ahmedjk34/hardware-grad-project/report_src/figs/fig-raw-fisheye.png

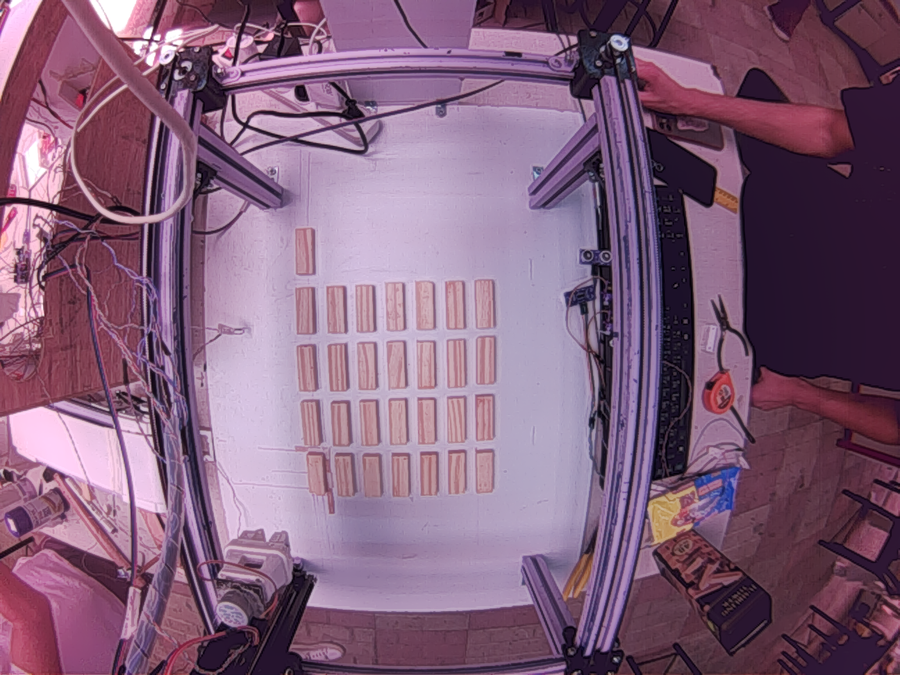
report_src/figs/fig-raw-fisheye.png
