ahmedjk34/hardware-grad-project/report_src/figs/fig-feed-detected.png

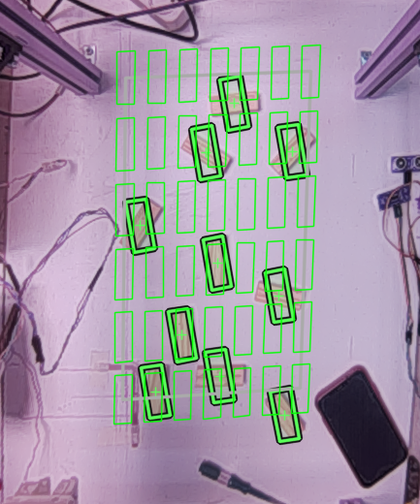
report_src/figs/fig-feed-detected.png
