ahmedjk34/hardware-grad-project/WANTED_REPORT_STRUCTURE.md

# Graduation Project Report Structure

## Front Matter

- Title Page
- Acknowledgments
- Abstract
- Table of Contents
- List of Figures
- List of Tables

# 1. Introduction

## 1.1 Background and Motivation

- General background of the project area.
- Context behind the project.
- Motivation for developing the system.

## 1.2 Problem Statement

- The problem being addressed.
- Why the problem requires a solution.

## 1.3 Project Objectives

- Main goal of the project.
- Specific objectives the completed system is intended to achieve.

## 1.4 Scope and Boundaries

- What is included within the project.
- What is outside the project's scope.
- Boundaries of the implemented system.

## 1.5 Significance of the Project

- Importance and potential value of the project.
- What the project contributes or demonstrates.

## 1.6 Organization of the Report

- Brief description of what each following chapter covers.

# 2. System Requirements and Design

## 2.1 System Requirements

- Functional requirements.
- Performance requirements where applicable.
- Safety or operational requirements.

## 2.2 Design Constraints

- Physical constraints.
- Hardware/electrical constraints.
- Technical and project constraints.

## 2.3 Overall System Architecture

- High-level system architecture.
- Main subsystems.
- How the subsystems connect and interact.

## 2.4 Mechanical Design

- Overall mechanical structure.
- Main mechanical mechanisms.
- Design choices relevant to movement and physical operation.

## 2.5 Electrical and Control Design

- Overall electrical design.
- Control architecture.
- Connections between controllers, actuators, sensors, and other hardware.

## 2.6 System Workflow

- Overall sequence of operation.
- How the system moves from an initial command/input to the final physical operation.

# 3. Hardware and System Implementation

## 3.1 Cartesian Motion System

- Physical motion mechanisms.
- Motors and motor drivers.
- Axis control hardware.
- Homing and movement-related hardware.

## 3.2 End-Effector and Manipulation System

- End-effector design.
- Gripping/manipulation mechanisms.
- Actuators involved in manipulation.

## 3.3 Processing and Control Hardware

- Main processing units and microcontrollers.
- Purpose of each controller.
- Division of responsibilities between them.

## 3.4 Vision System

- Vision hardware.
- Physical setup and mounting.
- Calibration and positioning approach.

## 3.5 Sensors and Feedback

- Sensors used in the system.
- Purpose of each sensor.
- Signal acquisition and feedback.

## 3.6 Power and Safety

- Power sources and voltage requirements.
- Power distribution.
- Electrical protection.
- Safety mechanisms.

## 3.7 System Integration

- How the individual hardware subsystems are connected.
- Final integrated hardware configuration.

# 4. Control and System Operation

## 4.1 Control Methodology

- Overall control approach.
- Relationship between high-level and low-level control.

## 4.2 Motion Control

- Movement commands and execution.
- Homing and positioning.
- Relevant control logic.

## 4.3 Vision and Positioning

- Image processing workflow.
- Detection/localization process.
- Conversion between vision information and physical coordinates.

## 4.4 Main System Operation

- Main automatic operating sequence.
- How individual subsystems cooperate during operation.

## 4.5 Additional Operating Modes

- Any manual, interactive, testing, or alternative operating modes implemented.

# 5. Testing, Results and Discussion

## 5.1 Testing Methodology

- How the system and its subsystems were tested.
- Test conditions and evaluation criteria.

## 5.2 Motion System Testing

- Movement and positioning tests.
- Homing and repeatability where applicable.

## 5.3 Manipulation Testing

- End-effector tests.
- Physical manipulation performance.

## 5.4 Vision System Testing

- Detection and positioning tests.
- Calibration results.
- Accuracy where measurable.

## 5.5 Sensor Testing

- Sensor calibration.
- Sensor performance and stability.

## 5.6 Integrated System Testing

- Testing of the complete system.
- End-to-end operation.
- Overall results.

## 5.7 Challenges and Limitations

- Major problems encountered.
- Solutions or design changes made.
- Remaining limitations of the final system.

# 6. Conclusion and Future Work

## 6.1 Conclusion

- Summary of the completed project.
- Main outcomes.
- Degree to which the project objectives were achieved.

## 6.2 Future Work

- Possible improvements.
- Features or capabilities that could be added.
- Areas that could be improved in future versions.

# References

- Academic papers.
- Technical documentation.
- Datasheets.
- Other sources referenced throughout the report.

# Appendices

- Detailed wiring diagrams.
- Pin mappings.
- Bill of materials.
- Relevant code or pseudocode.
- Detailed experimental data.
- Additional mechanical drawings or diagrams.
