ahmedjk34/hardware-grad-project/WRITING_STYLE.md

# Deep Writing-Style Analysis of Your CircuitAI Graduation Report

I treated this as a **style-reconstruction task, not a project summary**, and analyzed the report as a writing corpus, as you requested. I read the complete uploaded PDF from page 1 through page 126, including the long implementation/results sections rather than judging your style only from the polished opening pages.

There is one important document-level finding before the analysis: **the uploaded report does not actually contain standalone sections titled “Problem Statement,” “Conclusion,” or “Future Work.”** The problem is expressed across **General Background** and **Problem Scope and Boundaries**. The report says in its organization section that “Chapter 5 discusses limitations, trade-offs, and future improvements,” but the uploaded PDF instead ends during the Authentication & User Management limitations, without a separate Chapter 5 conclusion/future-work chapter. I will therefore **not invent original examples that are not in the document**. For conclusion/future-work style, I can only derive a lower-confidence pattern from your abstract endings, high-level summaries, discussion sections, trade-offs, and limitations.

---

# 1. The Core Fingerprint of Your Writing

If I had to recognize your report anonymously, the strongest fingerprint would be this:

> **Practical engineering writing with academic framing, direct vocabulary, moderately long explanatory sentences, strong system-oriented structure, concrete implementation detail, frequent lists/workflows, and occasional conversational or imperfect phrasing that prevents the prose from sounding like polished journal-paper English.**

Your writing is **not primarily “research-paper academic.”** It is closer to:

**student-engineer academic report + technical system documentation + practical design explanation.**

That distinction matters enormously.

You do not normally write like:

> “The proposed methodological paradigm facilitates the systematic orchestration of heterogeneous computational subsystems…”

You write more like:

> “The system follows a modular, layered architectural approach to ensure maintainability, scalability, and clear boundaries throughout the entire design.”

And when explaining an actual feature, you become even more concrete:

> “Student opens /student/dashboard. System calls get_student_dashboard_overview with the student ID.”

That movement from **formal explanation → concrete mechanism → exact implementation** is one of the strongest recurring characteristics of the report. The methodology introduces the architecture at a high level and then immediately decomposes it into functional layers and technologies.

A second major fingerprint is that you strongly prefer **clarity and completeness over sophisticated academic wording**. You regularly use familiar words such as _provide, support, enable, manage, handle, reduce, clear, practical, unified, reliable,_ and _interactive_. You rarely reach for ornate scholarly connectors.

A third fingerprint is **functional thinking**. You describe things according to:

**what it is → what it does → what goes into it → what comes out → how it operates → what constrains it.**

That becomes almost an explicit template in the Results and Discussion chapter, where features repeatedly use **What it does / Inputs / Outputs / Typical workflow / Validation & constraints**.

That pattern will be extremely useful when writing the hardware report.

---

# 2. Full Original Style Reference

## Original example from my report — Abstract

> Engineering students have been facing significant challenges bridging theoretical circuit knowledge with its practical implementation. While current general purpose AI systems exist, they have showcased inadequate accuracy in addressing hardware design questions, frequently providing incorrect instructions, flawed circuit analysis, and misleading debugging guidance, leaving students with no reliable assistance once outside of the classroom.
>
> This is where our project comes in: an interactive cross-platform hardware learning application that integrates three foundational components into a single system. The platform includes a Moodle-like learning management layer responsible for course structuring, enrollment, assignments, quizzes, grading, and progress tracking. It also provides interactive circuit simulation, featuring a real-time, client-side digital logic simulator for immediate feedback and conceptual validation, alongside a SPICE-based electrical circuit simulator capable of DC operating point analysis, DC sweep, AC frequency analysis, and transient time-domain simulation. Last but not least, a domain-specific AI engine, enhanced through Retrieval-Augmented Generation (RAG) and grounded in An-Najah University course materials and circuit design principles, which ensures that it delivers accurate, context-specific tutoring, and then we applied the same advanced AI capabilities to quiz generation and AI-assisted grading designed to support instructors while preserving human oversight.
>
> The resulting system enables students to learn theory, design circuits, perform simulations, and complete assignments within a unified workflow aligned with academic and laboratory practices. Integrating learning management, accurate circuit simulation, and curriculum-grounded AI ensures coherence between instruction, practical application, and evaluation.
>
> The front-end development was done using NextJS and CSS modules, while the back-end development was done in python for the AI inference server and setup, while the RESTful API endpoints were tied closely to our front-end via NextJS API routes. As for database choice, we used a PostgreSQL database for user data and general storage, and ChromaDB vector database for AI embeddings.
>
> While general circuit tools such as Multisim and Proteus support heavy simulation, and TinkerCAD and CircuitLab offer lighter educational interfaces, and while general-purpose AI assistants are becoming widely available, no project combines the best of all worlds into a single, easily accessible platform. This work demonstrates the effectiveness of such integration, with An-Najah University as its starting point.

### Abstract structure

Your abstract follows this sequence:

**problem → solution → major system components → integrated value → implementation stack → comparative positioning/significance.**

What is interesting is what it **doesn't** do. It does not behave like a strict scientific abstract with _method → experiment → quantitative results → conclusion_. There are no statistical findings.

Instead, it behaves like a **graduation engineering-project abstract**:

1. Establish a practical problem.
2. Introduce the product directly.
3. Explain the main subsystems in substantial detail.
4. Explain what integration achieves.
5. Name the concrete technologies.
6. position it relative to existing alternatives.

Your transition into the solution is particularly characteristic:

> “This is where our project comes in…”

That is noticeably more natural and conversational than something such as _“To address the aforementioned challenge, a novel framework is proposed.”_

Similarly:

> “Last but not least…”

and:

> “As for database choice…”

are not highly formal academic constructions. They are **human, direct, student-engineer constructions**.

That mixture is central to your voice.

---

# 3. Your Full Introduction Style

Your introduction is not just the page headed “General Background.” Structurally, it consists of **General Background → Objectives and Purpose → Significance → Organization of the Report**.

## Original example from my report — General Background

> Electrical and digital circuit designs is a core pillar of many engineering majors (such as computer, electrical, mechatronics), yet it is one of the areas where students most frequently struggle to translate theory into reality. In the typical fashion, the student first encounters circuit laws, device models, and logical reasoning in lectures, and later attempts to apply them in laboratories, assignments and design exercises. This transition exposes a gap: solving a circuit on paper is fundamentally different from building, simulating, debugging, and validating it under real constraints such as incorrect wiring, missing ground references, non-ideal component behavior, misunderstanding of measurement points, and even faulty hardware components.
>
> And there exists learning workflows that could help mitigate that gap, but they are scattered across multiple systems; Course content and assessments are handled in a learning management system (LMS), simulation is usually performed in specialized heavy desktop tools. And students often rely on informal sources such as online forums for explanations and debugging help.
>
> This fragmentation introduces a real-world barrier: complex installations, licensing constraints, device and platform incompatibility, and a lack of continuity between learning materials, lab activities, and evaluation. As a result, students may spend significant time switching tools instead of focusing on conceptual understanding and hands-on skills.
>
> At the same time, general-purpose AI assistants have become widely available, and they are supposed to be a real help when it comes to bridging those gaps, and answering students hardware-related questions accurately, since they do use the entire internet as a source of info. However, traditional large language models [LLMs] often struggle with hallucinations, which causes it to produce confident but incorrect explanations, flawed circuit reasoning, or misleading debugging steps. And that is especially true when the question depends on a certain convention that is used in a specific course material but not necessarily all.
>
> These challenges highlight the need for a more coherent learning environment that connects course content, hands-on practice, and reliable support in one place. By reducing tool-switching and confusion, students can focus on understanding circuits and developing practical skills rather than struggling with fragmented workflows.

This is one of the **best samples of your natural prose voice**.

Your opening strategy is:

**broad domain importance → actual student experience → concrete practical mismatch → fragmented current workflow → consequence → new technological opportunity → weakness of that opportunity → project need.**

Notice that you do not spend several paragraphs explaining the history of electrical engineering or AI. You get to the **actual user problem very quickly**.

You also repeatedly make abstract problems tangible using concrete examples:

> “incorrect wiring, missing ground references, non-ideal component behavior…”

This is very characteristic. You don't simply write “practical implementation challenges.” You enumerate what those challenges actually look like.

---

## Original example from my report — Objectives and Purpose

> This work was done to reduce the practical gap between theoretical hardware education and real-world applications by building a single software platform that supports the full learning cycle: instruction, practice, validation, and evaluation.
>
> The main objectives of this project are:
>
> 1. Provide an integrated circuit-learning environment that combines course delivery (modules, lectures, slides), student management (enrollment, role-based access), and assessment tools (assignments, quizzes, grading, progress tracking) in one system rather than distributed tools.
> 2. Enable hands-on circuit practice with immediate feedback by delivering two complementary simulators
>    a) A client-side digital logic simulator that runs in real time in the browser for fast conceptual validation of combinational and sequential logic.
>    b) A SPICE-based electrical circuit simulator powered by a Python back-end capable of DC operating point analysis, DC sweep, AC frequency analysis, and transient simulation for realistic analog behavior.
> 3. Deliver reliable, curriculum-grounded AI tutoring using a RAG pipeline that retrieves relevant content from ingested course materials (Books and Slide) and generates answers with source awareness, reducing hallucination risk, grounding the answer, and showing proper citations directly from the material the student is studying.
> 4. Support instructors with AI-assisted automation while preserving oversight, whether through AI-driven quiz generation from lecture slides to reduce workload while keeping questions aligned with course content. Or AI-assisted grading that provides suggested grades and feedback as a decision-support tool, not as a replacement for the instructor.

### Objective-writing fingerprint

The verbs are extremely revealing:

**Provide → Enable → Deliver → Support.**

You prefer **action verbs describing outcomes**, followed immediately by enough implementation detail to prove that the objective is concrete.

You don't write vague goals like:

> “Explore the potential of artificial intelligence.”

You write:

> “Deliver reliable, curriculum-grounded AI tutoring using a RAG pipeline…”

So your objectives combine:

**desired capability + mechanism + intended benefit.**

That is exactly how future objectives should be written if they are to sound like this report.

---

## Original example from my report — Significance and Importance

> This work is tied to the increasing demand for accessible, scalable, and interactive engineering education tools. Universities worldwide are steadily moving towards digital and hybrid learning models. Where students expect easy access to course materials, labs, and assessments with minimal friction. At the same time, engineering programs in many universities around the world face increasing pressure to deliver practical, industry-relevant skills while managing large class sizes and limited laboratory time and staffing. These trends create a strong need for platforms that can provide hands-on practice, consistent evaluation, and continuous support beyond the physical lab in a way that allows the instructor to scale their teaching effort without turning the grading, tracking and support process into a bottleneck.
>
> As engineering education continues to shift toward blended delivery, tools that combine learning, practice, and evaluation in one workflow are becoming a baseline expectation rather than an extra feature.
>
> In addition, there is a growing demand for AI-integrated software all around the globe, but we end up with many programs that are just a generic LLM wrapper or out-of-place AI usage, where the “AI feature” feels cosmetic rather than functional. In contrast, our software introduces a real, high-impact use case for AI within engineering education by embedding a domain-specific support layer directly into the learning workflow, so students receive help that stays aligned with their course context instead of generic, disconnected answers. At the same time, the AI is explicitly designed as a support tool, not a replacement for instructors or a shortcut around learning. Because human expertise is essential for engineering judgment, proper evaluation, and oversight; the system uses AI to assist students and reduce repetitive instructor workload while keeping teaching authority and final decisions in human hands

This section shows another important characteristic: you express significance using **practical consequences rather than abstract societal claims**.

Even when you make a large-scale claim, you immediately bring it toward a practical bottleneck:

> “without turning the grading, tracking and support process into a bottleneck.”

And your criticism of bad AI integration is unusually plain:

> “just a generic LLM wrapper”

> “the ‘AI feature’ feels cosmetic rather than functional.”

That phrasing is much more recognizably yours than generic academic language.

---

## Original example from my report — Organization of the Report

> This report is organized as follows: Chapter 2 outlines the system requirements and design goals. Chapter 3 presents the methodology in detail, including the selected tools, programming languages, architecture decisions, and how course materials were processed for the AI pipeline. Chapter 4 carries the main weight of the work, presenting the implemented features and results. Chapter 5 discusses limitations, trade-offs, and future improvements.

This is very direct. You do not explain why the report is organized this way. You simply tell the reader **where everything is**.

“Chapter 4 carries the main weight of the work” is another small human signature. A more generic academic writer would probably say “Chapter 4 presents the primary implementation and evaluation results.”

---

# 4. Problem Statement: What the Report Actually Does

There is **no section titled “Problem Statement.”**

The problem is instead developed in two places:

1. **General Background**, where the problem is narrated.
2. **Problem Scope and Boundaries**, where it is formalized and bounded.

That means your problem-writing style is **distributed rather than redundant**. You introduce the human/practical problem first, and later state its formal project boundary.

## Original example from my report — Problem Scope and Boundaries

> This project targets a well-defined problem within engineering education: the difficulty students face when translating theoretical circuit concepts into practical design, simulation, and validation workflows. The scope is focused on university-level hardware courses, with An-Najah University serving as the primary academic context.
>
> Rather than separating learning management, circuit simulation, and student support across multiple tools, the system integrates these components into a single, coherent platform. Students can move smoothly between studying course material, designing circuits, simulating behavior, and completing assessments without leaving the environment.
>
> The project emphasizes educational correctness, integration, and accessibility, prioritizing alignment with academic workflows over industrial-scale simulation depth or commercial deployment concerns.
>
> This following aspects are considered out of scope for this software graduation project:
>
> 1. Support for a broad or extensible library of circuit components, whether digital or analog, beyond the predefined educational set needed for An-Najah students.
> 2. Highly specialized analysis domains, such as RF circuit design, power electronics, signal integrity analysis, or simulations requiring frequency ranges and numerical precision beyond standard undergraduate coursework.
> 3. Physical laboratory hardware integration or real-time embedded execution
> 4. Academic materials and curricula outside An-Najah University
> 5. Commercial deployment concerns such as large-scale scalability, licensing, or high-availability guarantees.
> 6. Any unique mobile application features (it represents a mirror of the web version)

The sequence here is extremely reusable:

**define exact problem → define target context → explain what the system includes → state design priority → explicitly list what it does not attempt.**

You are comfortable saying what the project **does not do**, without trying to hide it.

---

# 5. Overall Academic Voice

### Formality

Your voice sits around **medium-high formality**, but not scholarly-journal formality.

You use technical terminology correctly and comfortably, but you mix it with ordinary phrases:

- “This is where our project comes in”
- “real help”
- “best of all worlds”
- “As for database choice”
- “Last but not least”
- “generic LLM wrapper”
- “bullet-proof yet simple integration”

That prevents the writing from becoming sterile.

### Engineering tone

Very strong.

You think in terms of:

- components;
- responsibilities;
- inputs/outputs;
- states;
- interfaces;
- workflows;
- constraints;
- failure modes;
- trade-offs.

The architecture chapter explicitly divides the system into presentation, application logic, computation, and data layers, then states the design principles independently.

### Confidence

Usually assertive.

You write:

> “The system follows…”

> “The simulator supports…”

> “The system validates…”

> “The platform includes…”

rather than:

> “The system may potentially…”

You hedge primarily when a limitation genuinely requires it.

### Personality

Low in implementation sections, moderate in introductory prose.

Your personality appears through wording rather than direct personal commentary.

The introduction feels substantially more human than the later implementation chapter.

### What you optimize for

**Understanding.**

Not elegance for its own sake.

Your recurring question seems to be:

> “Will the reader understand exactly what this component does and how the system behaves?”

That is why you often give one more concrete example, field name, route, state, or constraint than strictly necessary.

---

# 6. Sentence-Level Fingerprint

I also measured the extracted text to avoid relying entirely on impression.

In the more narrative opening portion of the report, your sentences average approximately **23 words**, with a median around **20 words**. Across the entire document, where the many workflow bullets make sentences substantially shorter, the average falls to roughly **15 words** with a median around **11**.

So the important distinction is:

**prose = medium-to-long sentences**
**technical bullets/workflows = short-to-medium declarative units**

## Pattern 1: Long sentence + concrete enumeration

Example:

> “This transition exposes a gap: solving a circuit on paper is fundamentally different from building, simulating, debugging, and validating it under real constraints such as incorrect wiring, missing ground references, non-ideal component behavior, misunderstanding of measurement points, and even faulty hardware components.”

You often state an abstract point and then **unpack it into several concrete cases**.

### Formula

**claim + colon + specific examples**

This should absolutely be preserved.

---

## Pattern 2: Several related ideas inside one sentence

You are comfortable stacking clauses:

> “At the same time, general-purpose AI assistants have become widely available, and they are supposed to be a real help when it comes to bridging those gaps, and answering students hardware-related questions accurately…”

You do **not** aggressively split every idea into a separate polished sentence.

This produces a slightly flowing, natural rhythm.

---

## Pattern 3: Present-tense system agency

Later chapters repeatedly use:

> “System fetches…”

> “System validates…”

> “Student opens…”

> “Instructor selects…”

> “UI renders…”

This is arguably the strongest implementation-level syntax in the report.

The actor is named first; then the action.

Very little abstraction.

---

## Pattern 4: Colon as an explanation tool

You use colons constantly for:

- definitions;
- lists;
- roles;
- implementation explanations;
- component descriptions.

Examples:

> “The main objectives of this project are:”

> “Presentation Layer (Web and Mobile Clients): Implements…”

> “What it does: Displays…”

> “Inputs:”

> “Outputs:”

Colons are far more characteristic of you than elegant semantically hidden transitions.

---

## Pattern 5: Parenthetical clarification

You regularly use parentheses for:

- examples;
- acronyms;
- routes;
- implementation alternatives;
- units;
- states.

For example:

> “course delivery (modules, lectures, slides)”

> “student management (enrollment, role-based access)”

> “status badge, progress indicator (0–100%)”

This lets you keep the main sentence readable while still providing implementation specificity.

---

## Pattern 6: Contrast inside the sentence

Typical structures include:

> “Rather than separating…”

> “while preserving oversight”

> “not as a replacement for the instructor”

> “prioritizing alignment with academic workflows over industrial-scale simulation depth…”

You often define something partly by **what it is not**.

---

## Pattern 7: Cause/result tails

You frequently attach the engineering consequence to the end:

> “…reducing hallucination risk…”

> “…enabling the use of scientific and machine learning libraries…”

> “…without impacting front-end performance.”

> “…to reduce integration risk.”

So the sentence frequently operates as:

**implementation choice → immediate reason/consequence.**

---

# 7. Punctuation Signature

The extraction shows an overwhelming preference for **commas, colons, parentheses, and ordinary hyphenation**.

The em dash is exceptionally rare across the entire report.

That means prose like this would _not_ sound natural for you:

> “The controller—a critical component of the architecture—must therefore…”

Your natural form would be closer to:

> “The controller is a critical component of the architecture, since it is responsible for…”

or:

> “The controller has one primary responsibility: …”

That is an important imitation rule.

Also notable: formal transitions such as **Moreover, Thus, Hence, Therefore, Consequently, Nevertheless** are virtually absent.

Across the extracted report:

- “Moreover”: 0
- “Therefore”: 0
- “Thus”: 0
- “Hence”: 0
- “Consequently”: 0
- “Furthermore”: only 1, in the acknowledgment
- “At the same time”: several uses
- “As a result”: several uses
- “Rather than”: recurring
- “In contrast”: occasional

So if future text constantly says _Moreover_, _Furthermore_, _Consequently_, or _Thus_, it will immediately sound unlike this report.

---

# 8. Paragraph-Level Style

Your paragraphs generally follow a clear **one-main-point architecture**, but individual sentences may contain multiple details.

A very typical paragraph behaves like this:

**topic sentence → explanation → specific examples/mechanism → engineering consequence.**

For example:

> “This fragmentation introduces a real-world barrier: complex installations, licensing constraints, device and platform incompatibility, and a lack of continuity between learning materials, lab activities, and evaluation. As a result, students may spend significant time switching tools instead of focusing on conceptual understanding and hands-on skills.”

This paragraph is characteristic because it does four things quickly:

1. names the issue;
2. enumerates what creates it;
3. states the practical consequence;
4. stops.

You usually do **not** add a final decorative sentence that restates everything.

### General → specific movement

This is very consistent.

You often begin broadly:

> “This work is tied to the increasing demand…”

then narrow toward:

> actual course materials → instructors → grading → AI → system design.

That broad-to-project-specific movement is a major part of the introduction voice.

---

# 9. Requirements Style

Requirements are one area where you become extremely compressed.

Your functional requirements are essentially **capability statements without paragraphs of explanation**:

> “User authentication and role-based access control”

> “Course and module management”

> “Browser-based digital logic circuit simulation”

> “AI-assisted grading with structured feedback”

Non-functional requirements are similarly concise:

> “Correct and reliable simulation behavior for educational circuits”

> “Stable operation during normal academic use and demonstrations”

> “Maintainable and modular codebase”

So when a section is naturally list-like, you do not force it into prose merely to sound academic.

That is another key trait:

**you choose format based on information type.**

---

# 10. Methodology and Architecture Style

The methodology section is very revealing.

You first tell the reader **what kind of methodology applies**:

> “This project follows a software engineering design and implementation methodology rather than a traditional physical experimental approach.”

Then you explain what the usual academic terminology means **in the context of your project**:

> “the ‘materials’ consist primarily of programming frameworks, libraries, databases, and APIs…”

Then you move to architecture.

This means you don't like dumping formal methodology language without connecting it to actual work.

### Architecture explanation pattern

You use:

**high-level architectural principle → individual layers → responsibility of each layer → design principles.**

The layer descriptions are written as:

> **Layer name:** action + responsibility + consequence.

For example:

> “Application Logic Layer (Next.js API Routes): Acts as a lightweight orchestration layer responsible for request handling, authentication enforcement, and coordination…”

This form should transfer very naturally to hardware components later.

---

# 11. Technology Explanation Style

When introducing individual technologies, you rarely give textbook histories.

You write:

> “Fabric.js: Powers the interactive circuit design canvas…”

> “Axios: Handles HTTP communication…”

> “ChromaDB: Vector database used to store and retrieve embeddings…”

> “PySpice with NGSpice: Provides SPICE-based electrical circuit simulation…”

The pattern is:

**Technology name → project-specific role → useful implementation capability.**

Not:

**Technology definition → history → industry adoption → generic advantages → project usage.**

That is extremely important for the hardware report.

For example, when eventually describing a driver, sensor, microcontroller, motor, or power system, a paragraph that spends half a page explaining generic electrical theory would probably not match your existing style unless that theory is necessary to understand the design.

Your natural instinct is:

> **What is this component doing in our system?**

before:

> **What is this component in general?**

---

# 12. Your Implementation-Section Formula

This is perhaps the most reproducible part of the entire report.

For almost every major software feature, you use roughly:

### Feature N: [Feature]

**High-level summary**

Short dense overview.

**Feature list**

Main capabilities.

**Sub-features**

For every major UI or subsystem:

- What it does
- Inputs
- Outputs
- Typical workflow
- Validation & constraints

Then:

### Discussion

- Design goals
- Architectural overview
- Key system mechanisms
- Implementation architecture
- Design trade-offs
- Constraints & limitations

That pattern begins immediately with the Course Management System.

The Student Course List then uses:

> “What it does…”

> “Inputs…”

> “Outputs…”

> “Typical workflow…”

And later sub-features add:

> “Validation & constraints…”

This repeats so consistently that it is essentially a **personal technical-report grammar**.

---

# 13. Purpose → Implementation → Details → Reasoning → Result?

The pattern you proposed in your prompt is close, but your actual pattern is slightly different.

Your report usually follows:

**purpose → observable behavior → implementation/workflow → constraints → architecture/rationale → trade-off**

rather than:

**purpose → implementation → reasoning → result.**

You frequently postpone the deeper design reasoning until the **Discussion** section.

So you might first explain exactly how a feature behaves, and only later discuss why a certain architecture or trade-off was selected.

That separation is characteristic.

---

# 14. Results Style

Your chapter is titled **Results and Discussion**, but its dominant meaning of “results” is:

> **what was successfully implemented and what the resulting system can do**

rather than:

> **experimental evaluation with hypotheses, data sets, statistical analysis, and confidence intervals.**

That is an important distinction.

The first feature starts:

> “The Course Management System delivers core LMS functionality…”

then immediately states how it organizes content and what its outputs are.

So your result-writing is predominantly **factual and implementation-centered**.

You describe:

- final behaviors;
- outputs;
- limits;
- routes;
- data structures;
- timings;
- capacities;
- states.

You interpret results mostly through the later **Discussion / Design Trade-offs / Constraints & Limitations** sections.

---

# 15. Use of Numbers and Evidence

You use many numbers, but generally as **engineering parameters and system facts**, not academic statistical evidence.

Examples throughout the report include things such as:

- 0–100% progress;
- 40 MB uploads;
- 500 MB media files;
- 50 MB assignment files;
- 24-hour urgency thresholds;
- 7-day feedback windows;
- one attempt per quiz;
- 8 convergence iterations;
- 60-second SSE timeout;
- 384-dimensional embeddings;
- `top_k=30`.

The pattern is usually:

**state exact value → place it directly beside the relevant mechanism or constraint.**

You usually do **not** isolate numerical values merely to make the report appear quantitative.

### What is missing

The report has very little formal empirical evaluation.

There is no strong pattern of:

> “Ten experiments were performed…”

> “Mean error was…”

> “Standard deviation…”

> “The proposed method improved X by Y%…”

That means we **cannot truthfully derive a mature experimental-results style from this software report**.

For the hardware report, where actual physical testing will probably matter more, the safest stylistic transfer is:

**measured value → condition under which it was measured → direct interpretation → limitation if relevant.**

That preserves your directness without inventing a testing style that does not exist here.

---

# 16. Limitations and Trade-Off Style

This is one of the strongest areas of the report.

You are relatively candid.

The early project constraints already state things such as:

> “Development was bounded by academic timelines…”

> “AI features rely on cost-constrained, open-source / lower-tier models…”

> “The project intentionally prioritized horizontal system coverage… over vertical specialization…”

Later sections become even more systematic.

You repeatedly use two forms:

### Trade-off

**choice → benefit → cost**

Examples conceptually include:

- simpler approach vs scalability;
- automation vs review requirement;
- persistent saving vs write volume;
- external service benefit vs dependency;
- JSON flexibility vs queryability.

### Limitation

**subsystem/category: concrete restriction + engineering consequence**

Your limitations are generally:

- specific;
- unemotional;
- non-defensive;
- technically explainable.

You do not write:

> “Unfortunately, due to unforeseen circumstances, the system was unable…”

You write something closer to:

> “No real-time updates: dashboards can become stale if left open; refresh required.”

That tone will be valuable in the hardware report.

---

# 17. Vocabulary Profile

Your most characteristic vocabulary is **functional**, not decorative.

### Common action vocabulary

- provide
- support
- enable
- manage
- handle
- deliver
- integrate
- validate
- enforce
- store
- retrieve
- render
- route
- load
- reduce
- preserve

The entire report repeatedly assigns these verbs to concrete system actors.

### Characteristic descriptive vocabulary

- unified
- integrated
- clear
- consistent
- reliable
- modular
- practical
- accessible
- interactive
- structured
- optimized
- strict
- real-time

### Characteristic nouns

- system
- platform
- workflow
- architecture
- component
- module
- layer
- functionality
- integration
- validation
- constraint
- behavior
- state
- output
- input
- implementation
- design
- access
- management

### Characteristic benefit expressions

You frequently phrase benefits as:

- “to reduce…”
- “enabling…”
- “while preserving…”
- “to ensure…”
- “without…”
- “rather than…”
- “allowing…”
- “providing…”
- “keeping…”

This gives your writing a highly **cause-and-purpose oriented** character.

---

# 18. Transition Style

You do not rely heavily on explicit academic transition words.

Instead, flow usually comes from **logical continuity of subject matter**.

Your actual recurring transitions include:

> “At the same time…”

> “As a result…”

> “Rather than…”

> “In addition…”

> “In contrast…”

> “While…”

> “Since…”

> “The resulting system…”

> “These challenges…”

You also frequently transition simply by changing the subject:

> “The system…”

> “The platform…”

> “The project…”

There is very little:

> Moreover
> Furthermore
> Therefore
> Hence
> Thus
> Consequently
> Nevertheless

This is one of the easiest ways to detect generic AI imitation of your writing: ChatGPT often overuses those words unless explicitly restrained.

---

# 19. How You Refer to the Project

Your references vary depending on context:

### “This project”

Used when discussing:

- purpose;
- scope;
- methodology;
- constraints.

### “This work”

Used when framing:

- significance;
- purpose;
- broader contribution.

### “The system”

Dominant when explaining:

- behavior;
- architecture;
- workflows;
- validation.

### “The platform”

Used when referring to the product as a unified user-facing environment.

### Specific subsystem names

Once deep in implementation, you stop saying “the project” and use:

- Course Management System
- Assignment System
- Quiz System
- Circuit Simulation System
- AI-Powered Educational Assistant

That hierarchy is useful.

---

# 20. Figures, Tables, and Diagrams

Your figure integration is practical rather than analytical.

The recurring pattern is:

**Sub-feature title (Fig. N)**

then explanation,

then figure,

then:

> “(Figure. N) [short descriptive name]”

Examples include **Student Course List & Discovery**, **Instructor Course Detail & Management**, and **Module System**.

The caption normally names the interface or subsystem rather than explaining an interpretation.

You rarely write a separate paragraph such as:

> “As demonstrated in Figure 4, the visualization indicates…”

Instead, the figure is integrated as **visual evidence of the feature just described**.

Tables appear primarily where information has a naturally comparative form, especially:

- role/access relationships;
- design trade-offs.

You do not turn everything into tables.

---

# 21. Formatting Style

The report consistently prefers:

### Headings

Multiple semantic levels, but relatively little visible numerical subsection numbering.

Examples:

- Results and Discussion
- Feature 1: Course Management System
- High-level summary
- Feature list
- Sub-features
- Discussion
- Design Goals
- Architectural Overview
- Key System Mechanisms
- Implementation Architecture
- Design Trade-offs
- Constraints & Limitations

### Bullets

Used heavily for:

- architecture components;
- feature capabilities;
- inputs;
- outputs;
- constraints;
- technical mechanisms.

### Numbered lists

Used predominantly for:

- objectives;
- workflows;
- ordered procedures;
- constraints when the order/list is significant.

### Code and implementation identifiers

You usually keep code-level information inline:

- route names;
- RPC names;
- enum values;
- database fields;
- API endpoints.

There are effectively no long source-code dumps.

### Equations

Almost nonexistent. Where a formula is needed, you state it directly in text/bullets.

So a hardware report suddenly filled with pages of formal mathematical derivations would not resemble this report unless the subject genuinely required them.

---

# 22. Grammar and Personal Quirks

This needs to be separated carefully.

## Intentional or consistent style characteristics

These are worth preserving:

- beginning occasional sentences with **“And”**;
- direct phrases such as **“This is where…”**;
- combining technical and plain language;
- using concrete parenthetical examples;
- somewhat long comma-linked sentences;
- repeating an important noun instead of constantly searching for synonyms;
- direct active actors such as **System**, **Student**, **Instructor**;
- using _rather than_ to distinguish design choices;
- practical wording rather than polished literary wording;
- separating reasoning into a later Discussion section.

## Likely mistakes or inconsistencies

These should **not** be deliberately copied.

Examples from the report include:

> “Electrical and digital circuit designs is…”

Subject–verb disagreement.

> “And there exists learning workflows…”

Agreement/wording problem.

> “Universities worldwide are steadily moving towards digital and hybrid learning models. Where students expect…”

Sentence fragment.

> “traditional large language models [LLMs] often struggle with hallucinations, which causes it…”

Singular/plural pronoun mismatch.

> “This following aspects…”

Grammar error.

> “different types content”

Missing preposition.

There are also occasional:

- inconsistent capitalization;
- `python` instead of `Python`;
- incomplete punctuation;
- awkward semicolon usage;
- slightly redundant phrases;
- inconsistent singular/plural forms.

For future work, I would reproduce the **structure and rhythm**, not the mistakes.

That is the correct balance if the new report should sound like you **after proofreading**, rather than like artificially degraded English.

---

# 23. Active vs Passive Voice

Your style is mixed, depending on section.

### Project-development discussion

You occasionally use passive constructions:

> “The front-end development was done using…”

> “All components were built…”

### Functional description

You overwhelmingly move toward active/simple-present structures:

> “System fetches…”

> “Instructor opens…”

> “UI renders…”

> “The system validates…”

So a future report should not become passive-heavy.

Something like:

> “The signal was subsequently transmitted to the controller, where it was processed…”

is less characteristically yours than:

> “The sensor sends the signal to the controller, which processes the reading…”

unless passive voice is genuinely useful.

---

# 24. Technical Explanation Style

Your default sequence is approximately:

### 1. Identify the component/subsystem.

### 2. State its role immediately.

### 3. Explain its interaction with the rest of the system.

### 4. Give exact implementation details.

### 5. Describe normal operation as a workflow.

### 6. State constraints.

### 7. Later discuss rationale/trade-offs.

This is much more **project-specific** than textbook-like.

You generally assume the reader has a basic engineering/software background.

You explain what RAG, SPICE, RPC, JWT, etc. are _enough to understand their role_, but you do not teach an entire introductory course on them.

That level of assumed prior knowledge should carry over.

---

# 25. Human-Written Characteristics

Several things make the report feel distinctly human.

### Uneven polish

Some sections are clean and controlled; others contain awkward grammar or very long sentences.

AI-generated reports often maintain an unnaturally uniform polish.

### Natural repetition

You repeatedly say:

- “the system”
- “the instructor”
- “the student”
- “course”
- “module”
- “workflow”

You do not aggressively replace them with synonyms.

### Practical language

Phrases such as:

> “generic LLM wrapper”

> “best of all worlds”

> “real help”

> “carries the main weight of the work”

sound like a person explaining something they actually built.

### Uneven sentence lengths

The narrative sections contain substantial sentences, while workflows become extremely short.

### Concrete implementation habits

You include obscure details that make sense because they arose during implementation: enum names, route paths, RPC function names, limits, storage behavior, cascade deletion, exact state models.

That specificity is one of the strongest defenses against generic AI prose.

---

# 26. What Sounds AI-Like in the Existing Report

Some aspects **do** become formulaic.

That does not prove anything about authorship; it simply describes the prose.

The biggest one is the repeated framework:

> What it does
> Inputs
> Outputs
> Typical workflow
> Validation & constraints

Repeated across many sub-features, this creates a documentation-template feel.

Other more generic constructions include:

> “ensure maintainability, scalability, and clear boundaries”

> “modular, layered architectural approach”

> “clear separation of concerns”

> “optimized response times”

These are legitimate engineering phrases, but they are common enough to sound generic unless followed by concrete system detail.

Your report usually fixes that by immediately supplying that detail.

So the rule for imitation should be:

**generic engineering claim + immediate project-specific evidence.**

Never leave the generic sentence standing alone.

---

# 27. Things That Would NOT Sound Like You

A future section would noticeably deviate from this report if it did the following:

1. Used ornate academic vocabulary throughout: _paradigm, multifaceted, elucidates, aforementioned, notwithstanding, quintessential, facilitates the orchestration of…_
2. Used **Moreover / Furthermore / Therefore / Thus / Consequently** every paragraph.
3. Used em dashes constantly.
4. Made every sentence short and punchy.
5. Made every paragraph exactly the same length.
6. Avoided repetition by constantly inventing synonyms for “system,” “component,” or “project.”
7. Explained generic engineering theory for pages before discussing your actual design.
8. Used excessive passive voice.
9. Filled implementation sections with buzzwords but omitted routes, components, interfaces, states, thresholds, measurements, or constraints.
10. Used dramatic claims such as “revolutionary,” “groundbreaking,” or “state-of-the-art” without evidence.
11. Made every limitation sound like a positive.
12. Used dense research-paper hedging: _may potentially suggest that…_
13. Used extremely compressed technical descriptions with no operational sequence.
14. Turned everything into prose instead of using lists where the information is naturally procedural.
15. Used first-person singular “I” throughout.
16. Produced perfectly polished ChatGPT-style parallel sentences in every paragraph.

---

# 28. MY GRADUATION REPORT WRITING STYLE

This is the reusable profile I would give another AI.

## Tone

Formal enough for an engineering graduation report, but practical and natural rather than journal-like. The writing should sound like a student engineer explaining a system they actually designed and implemented.

## Formality

Moderate-to-high. Use correct technical terminology, but prefer normal English over ornate academic vocabulary. Occasional natural phrases are acceptable.

## Sentence Structure

Narrative prose should usually use medium-to-long sentences, roughly 18–30 words, often combining a main claim with examples, consequences, or implementation details. Technical workflows should use much shorter sentences.

Use commas and colons freely. Parentheses are common for examples, abbreviations, values, and clarifications. Avoid frequent em dashes.

## Paragraph Structure

Begin with a concrete topic sentence. Develop one main idea. Move from general claim to specific implementation or examples. End when the point has been demonstrated; do not add unnecessary concluding filler.

## Vocabulary

Prefer:

**system, project, platform, component, workflow, design, implementation, functionality, validation, constraint, practical, clear, reliable, integrated, unified, modular, real-time.**

Prefer verbs:

**provide, enable, support, handle, manage, validate, integrate, reduce, store, retrieve, process, render, ensure.**

## Technical Depth

Explain enough theory to establish the role of a technology/component, then quickly move into **how it is used in this project**.

Do not write textbook chapters unless the underlying engineering concept is necessary to understand a design decision.

## Explanation Pattern

Use:

**purpose → behavior → implementation → interaction → workflow → constraints → rationale/trade-off.**

For major features/components, separate operational description from later discussion.

## Section Structure

Start broad sections with a short overview.

For implementation-heavy material, prefer:

**High-level summary → capabilities → individual components/subfeatures → workflow → validation/constraints → discussion → trade-offs → limitations.**

## Transitions

Use straightforward transitions such as:

- At the same time
- As a result
- Rather than
- In addition
- In contrast
- While
- Since
- This project
- The system
- The resulting system

Do not artificially insert formal transitions between every paragraph.

## Use of Evidence

Give concrete specifications directly beside the relevant statement. Numbers should mean something operationally.

When actual testing exists, give the measurement and immediately state what it means for the system.

## Formatting

Use prose for reasoning and context.

Use bullets for:

- components;
- features;
- requirements;
- constraints.

Use numbered lists for:

- objectives;
- workflows;
- ordered procedures.

Use tables where genuine comparison or trade-offs exist.

## Typical Phrases

Characteristic constructions include:

> “This project…”

> “This work…”

> “The system…”

> “The platform…”

> “Rather than…”

> “At the same time…”

> “As a result…”

> “The main objectives of this project are…”

> “The system follows…”

> “The following design principles…”

> “What it does:”

> “Inputs:”

> “Outputs:”

> “Typical workflow:”

> “Validation & constraints:”

> “while preserving…”

> “to reduce…”

## Things to Avoid

Avoid ornate vocabulary, excessive formal transition words, frequent em dashes, excessive passive voice, buzzwords without implementation evidence, generic textbook explanations, artificial synonym variation, perfect-but-generic ChatGPT prose, and unnecessary rhetorical flourish.

---

# 29. Section-Specific Writing Templates

These are **style templates only**, not hardware-report content.

## Background Template

**Paragraph 1:** Establish why the domain/problem matters. Introduce the gap using a concrete real-world situation.

**Paragraph 2:** Explain how current workflows or solutions deal with it and why they are fragmented/inadequate.

**Paragraph 3:** State the practical consequences.

**Paragraph 4:** Introduce any modern technology or alternative that appears able to solve the issue, then explain its limitation.

**Final paragraph:** Synthesize the challenges into a direct need for the proposed project.

Characteristic progression:

> broad importance → real problem → existing approach → shortcomings → need

---

## Problem Statement Template

**Confidence: medium, because the source report has no standalone Problem Statement.**

Derived from General Background + Problem Scope:

> This project targets [specific practical problem]: [plain-language definition].
> The problem appears when [real operating situation].
> Existing approaches [fragmentation/limitation].
> As a result, [practical consequence].
> The project therefore focuses on [bounded problem area] rather than [excluded broader objective].

---

## Objectives Template

One opening sentence:

> “This work was done to…”

Then:

> “The main objectives of this project are:”

Numbered objectives beginning with direct verbs:

1. **Provide** [capability] by [mechanism].
2. **Enable** [user/system outcome] through [implementation].
3. **Deliver** [capability] using [technical mechanism], reducing/improving [effect].
4. **Support** [stakeholder/process] while preserving/maintaining [constraint].

---

## Scope Template

**Paragraph 1:** precise problem and environment.

**Paragraph 2:** what the system combines/supports.

**Paragraph 3:** what the project prioritizes over broader alternatives.

Then:

> “The following aspects are considered out of scope…”

Numbered exclusions.

---

## System Architecture Template

Opening:

> “The system follows a [architecture type] approach to ensure [2–3 practical qualities].”

Then each architectural element:

> **Component/Layer:** Performs [role], handling [responsibilities] while [interaction/benefit].

Then:

> “The following design principles guided…”

with short labelled bullets.

---

## Hardware / Technical Component Template

The closest direct analogue to your technology-stack style is:

> **[Component name]:** Provides/Handles/Controls [role in project], enabling [specific capability] while [important interaction or design consideration].

Then, if complex:

- What it does
- Inputs
- Outputs
- Typical workflow
- Validation / operating constraints

This would sound much closer to your existing report than a textbook definition.

---

## Implementation Template

### [Subsystem]

**High-level summary**

One dense paragraph covering purpose, major functionality, and resulting outputs.

**Feature/component list**

Short bullets.

### [Individual component/subfeature]

**What it does:** concrete role.

**Inputs:** signals/data/actions.

**Outputs:** resulting state/data/action.

**Typical workflow:**

1. Actor/component initiates.
2. System reads/processes.
3. Component responds.
4. State/result changes.
5. Validation occurs.

**Validation & constraints:** explicit limits.

Then a later **Discussion** containing design goals, mechanisms, architecture, trade-offs, and limitations.

---

## Testing / Results Template

This is the least directly evidenced template because the source lacks a dedicated experimental testing chapter.

The best style-consistent pattern is:

> **Test purpose:** what behavior is being validated.
> **Inputs/conditions:** exact setup.
> **Outputs/results:** measured or observed result.
> **Interpretation:** what the result proves.
> **Validation & constraints:** conditions under which it remains valid.

Keep results factual first; interpret after.

---

## Limitations Template

Prefer:

> **[Subsystem/constraint]:** specific technical limitation; resulting consequence.

Or a trade-off table:

**Decision | Benefit | Cost**

Do not apologize for limitations.

Explain them.

---

## Conclusion Template

**Direct source evidence is absent**, so this is a _provisional_ reconstruction from your abstract/high-level summaries rather than an observed conclusion formula.

Closest likely structure:

**restate original problem → summarize resulting system → mention major implemented capabilities → explain what integration achieved → end with practical project significance.**

Keep it concrete. Do not suddenly become philosophical.

---

## Future Work Template

Again, there is no standalone Future Work section in the uploaded report.

The strongest available evidence comes from your limitation sections. Your natural future-work logic would therefore probably be:

**existing limitation → specific extension that removes it → practical benefit.**

Not:

> “Future researchers may explore various exciting directions…”

More likely:

> “[Current feature] is limited to [constraint]. Future development could extend it by [specific mechanism], allowing [practical outcome].”

---

# 30. Before/After Style Demonstrations

These use neutral hypothetical content so I am **not starting the new hardware report**.

## A. Introduction / Background

### Generic AI version

> Modern educational systems increasingly rely on sophisticated technological solutions to enhance learning outcomes. Nevertheless, students continue to encounter numerous challenges when transitioning from theoretical instruction to practical application. Consequently, an integrated platform may provide a valuable mechanism for improving this process.

### Version in your style

> Students can understand a concept during a lecture and still struggle when they have to apply it in an actual practical task. This creates a gap between knowing how something should work theoretically and being able to build, test, and debug it under real conditions. Existing tools can help with individual parts of this process, but when those tools are separated, the student still has to move between multiple environments to complete the full workflow.

### What changed

Less academic decoration. Concrete student behavior. Practical gap. No _Nevertheless/Consequently_. Clear movement toward system fragmentation.

---

# 31. Technical Explanation

### Generic AI version

> The database management subsystem represents a fundamental component of the proposed architecture and facilitates the efficient persistence and retrieval of heterogeneous application data.

### Version in your style

> The database layer manages persistent application data and keeps the main system entities organized in a consistent structure. It stores user and application records while exposing the data needed by the back-end services, allowing the rest of the system to retrieve and update information without directly handling storage logic.

### What changed

Concrete role first. Familiar vocabulary. Specific interaction. Benefit attached to implementation.

---

# 32. Architecture Explanation

### Generic AI version

> A multilayered architectural paradigm was adopted to enhance scalability, maintainability, and modularity across the solution.

### Version in your style

> The system follows a layered architecture to keep the main responsibilities separated and make individual components easier to maintain. Each layer handles a specific part of the workflow and communicates with the next layer through a defined interface, allowing individual parts of the system to change without requiring the entire architecture to be redesigned.

### What changed

The generic architectural claim was retained, but immediately explained operationally.

That is very characteristic of you.

---

# 33. Results

### Generic AI version

> Experimental evaluation demonstrated satisfactory system performance and validated the effectiveness of the proposed implementation.

### Version in your style

> The implemented system completed the expected workflow successfully and produced the required output under the tested conditions. The result confirms that the main components can communicate correctly during normal operation, while the remaining limitations are mainly tied to the current implementation boundaries rather than the basic workflow itself.

### What changed

Less vague praise. More operational description. Direct interpretation. Limitation acknowledged.

---

# 34. Limitation

### Generic AI version

> Despite the promising performance of the proposed system, several limitations remain and represent potential opportunities for future enhancement.

### Version in your style

> The current implementation is limited to the predefined operating conditions used throughout the project. This keeps the system predictable and reduces implementation complexity, but it also limits how easily the same design can be extended to significantly different use cases without additional changes.

### What changed

No ceremonial “despite promising performance.” Limitation stated immediately, followed by **benefit vs cost**.

---

# 35. Conclusion

Because your actual report has no conclusion, this one is only a **lower-confidence approximation based on your abstract and feature summaries**.

### Generic AI version

> In conclusion, the proposed system successfully demonstrates the transformative potential of modern technologies and establishes a robust foundation for future innovation in this domain.

### Closest match to your observed style

> The resulting system brings the main project components into a single workflow and demonstrates that the proposed design can support the intended use case in practice. By combining the individual subsystems rather than treating them as separate tools, the project provides a more complete solution to the original problem while still leaving clear areas that can be improved in future development.

### What changed

No “transformative potential.” No “robust foundation for innovation.” Concrete system integration, original problem, and realistic limitation.

---

# 36. The Most Important Distinction When I Imitate You Later

There are really **two variants of your report voice**.

### Narrative Ahmed

Used in:

- Abstract
- General Background
- Significance
- Scope

Characteristics:

- moderately long sentences;
- some conversational wording;
- concrete examples;
- flowing paragraphs;
- broader problem framing;
- occasional “we/our.”

### Technical-documentation Ahmed

Used throughout implementation/results.

Characteristics:

- structured headings;
- very direct wording;
- system/component as grammatical subject;
- lists;
- workflows;
- exact fields/routes/limits;
- constraints;
- trade-offs;
- minimal decoration.

A good hardware report should probably use **both**, depending on chapter.

Trying to use the abstract voice for every technical component would not match the source.

Trying to use the `What it does / Inputs / Outputs` voice for the introduction would also not match it.

That distinction is essential.

---

# 37. Confidence by Section Type

| Future section | How confidently your software report defines the style |
| --- | ---: |
| Abstract | **Very high** |
| Background | **Very high** |
| Objectives | **Very high** |
| Significance | **Very high** |
| Scope | **Very high** |
| Requirements | **Very high** |
| Architecture | **Very high** |
| Component explanation | **Very high** |
| Implementation | **Extremely high** |
| Workflow description | **Extremely high** |
| Constraints | **Extremely high** |
| Trade-offs | **Extremely high** |
| Figures/captions | **High** |
| Experimental testing | **Medium-low** |
| Problem Statement as separate section | **Medium** |
| Conclusion | **Low/derived** |
| Future Work | **Low/derived** |

This matters because I should **not pretend the report gives equally strong evidence for every future section**.

---

# 38. Final Style Checklist for the Hardware Report

When we eventually write a hardware-report section, I would evaluate it against these questions:

### Voice

- Does it sound like an engineering student explaining a system they actually built?
- Is it formal without sounding like a journal paper?
- Does it use straightforward vocabulary rather than unnecessarily sophisticated wording?

### Sentences

- Are narrative sentences mostly medium-length, with occasional longer explanatory sentences?
- Are concrete examples or consequences often attached to the main claim?
- Are colons and parentheses used naturally?
- Are em dashes rare?
- Did we avoid constant _Moreover/Furthermore/Therefore/Thus_?

### Paragraphs

- Does each paragraph have one recognizable main idea?
- Does it move from general explanation toward concrete project detail?
- Does it stop when the point has been established instead of adding generic filler?

### Technical explanation

- Is the role of the component explained before unnecessary generic theory?
- Does the text say how the component interacts with the actual project?
- Are inputs, outputs, behavior, or interfaces concrete where appropriate?
- Are exact implementation details included when they improve understanding?
- Are constraints stated rather than hidden?

### Structure

- Are lists used when the information is naturally list-like?
- Are ordered workflows numbered?
- Are rationale and trade-offs separated from basic functional explanation where appropriate?
- Does the section use a hierarchy comparable to the software report rather than excessive micro-headings?

### Vocabulary

- Does it naturally use words such as _system, component, project, design, workflow, practical, reliable, integrated, support, provide, enable, validate,_ and _reduce_?
- Does it avoid thesaurus-style synonym swapping?
- Does it avoid marketing language?

### Evidence

- Are numbers connected to actual engineering meaning?
- Are measured values stated directly?
- Is the significance of a result explained instead of simply calling it “successful”?

### Human consistency

- Does the prose retain some natural rhythm and repetition?
- Is it clean without becoming suspiciously perfect or formulaic?
- Have grammatical mistakes from the old report been corrected **without changing the underlying voice**?

### Final test

The strongest test is this:

> **Could this paragraph reasonably sit beside your CircuitAI report without suddenly sounding like it was written by a different academic writer?**

If the answer is yes, it should have the same combination of **directness, practical engineering detail, medium-length explanatory prose, concrete implementation language, structured workflows, honest constraints, simple transitions, and restrained academic vocabulary**.

That is the writing identity I would preserve when we move to the hardware graduation project.
