ahmedjk34/hardware-grad-project/REFERENCES.md

THE PCB / Cartesian ROBOT X/Y DESIGN COME DIRECTLY FROM THIS:
https://www.instructables.com/Automated-Chessboard/

This will help a ton in the mechanical design of the robot

---

Some context

We have the 12 volt power supply, and the step down converter, for electrical design, for wiring we used heat shrink and cropped male/male jumpers. with heat shrink and communication wires.
