ahmedjk34/hardware-grad-project/docs/feature-ideas.md

# Feature ideas — the software around the rig

A catalogue of everything worth building on top of the gantry, sorted by what it
costs and what it buys. The rig itself already works: a block gets picked from
the feeder and placed at `B <col> <row> <level>`. Everything here is about
making that capability *legible, planned, verified and impressive*.

The headline item — the **3D Build Studio** — is now built (M0–M7); its
living implementation record is [STUDIO.md](STUDIO.md).
Visual language for all of it is in [DESIGN.md](DESIGN.md).

---

## Tier 0 — done in the index redesign

**All of these shipped** with the console redesign (see [CONSOLE.md](CONSOLE.md)
§1 "Grown beyond the original ten steps", [DESIGN.md](DESIGN.md), and the
components under `web/src/`). Kept as a record of the plan.

| # | Feature | Where it landed |
| --- | --- | --- |
| 0.1 | **Rig serial log panel** | `web/src/components/RigLog.tsx`; `consoleStore.ts` keeps a bounded buffer of `serial` events |
| 0.2 | **Overlay view toggles** | `api.view()` → `POST /api/view`, chips on the camera stage |
| 0.3 | **Grid mode switch in the browser** | `web/src/components/ModeSwitch.tsx` → `api.mode()`; confirm step warns it homes X/Y |
| 0.4 | **Camera freshness meter** | `web/src/components/CameraChip.tsx` from `state.camera` / `camera_age_ms` |
| 0.5 | **Direct level entry** | `api.setLevel()` → `POST /api/level {value}`, guarded ≥ 0 |
| 0.6 | **Axis select** | `api.selectAxis()` → `POST /api/select/axis` |
| 0.7 | **Keyboard control** | `web/src/components/Shortcuts.tsx`, `?` overlay |

---

## Tier 1 — the flagship: design, plan, build, verify

### 1.1 The 3D Build Studio  ★ headline — built

A real 3D modelling environment in the browser. Dark space, orbit with the
mouse, the machine's own lattice on the floor, click to drop an actual 3D block,
stack on top of it, switch orientation and watch the lattice re-form live, shift
the grid live, save models to a library.

Under the hood every model is nothing but an ordered list of
`B <col> <row> <level>` commands separated by `R` / `RR` mode latches — which is
exactly why this is tractable: the hard part is a viewer, not a robot.

**Built, M0–M7.** Living implementation record: [STUDIO.md](STUDIO.md). One
piece remains unbuilt — the "wow pass" (live shift clipping, timeline scrub,
audio, instruction-sheet export, plan-on-video projection) — kept at
[STUDIO.md §12](STUDIO.md#12-not-yet-built--m8-the-wow-pass).

### 1.2 The live digital twin — built

The same 3D engine, read-only, sitting **next to the camera on the index page**.
As the rig places each block the twin fills in, the next target pulses, and the
remaining plan shows as ghosts. Real workspace and virtual workspace, side by
side, in step. This is the single most impressive thing a demo can show.

**Built, Studio milestone M6** — see [STUDIO.md](STUDIO.md).

### 1.3 Plan projection onto the live camera  ★ sleeper hit

You already have a homography from workspace cells to camera pixels
(`WorkspaceMap.target_polygon`, used by `web/geometry.py`). Feed the *planned*
model through it and draw the plan superimposed on the real video: the next
block glowing in the exact place it will physically land, and the rest of the
design faintly behind it. Near-AR, on hardware you already own, with maths that
is already written and tested.

### 1.4 Placement supervision  ★ BUILT

After each `PLACED`, compare the detections against the cell the model expected
to fill: `VERIFIED`, `NOT DETECTED`, `UNEXPECTED BLOCK AT [c,r]`. Run the same
check continuously while the rig is idle and it also catches a **human moving
or removing a block** — the board stops matching the plan, and the console says
which cell.

This closes the loop between the vision pipeline and the motion system, the most
defensible engineering claim in the project, with no new detector and no extra
frames.

> **The build plan is [features/placement-supervision.md](features/placement-supervision.md).**
> It merges and supersedes Appendix A below *and* Stage 15 §3's "as-built
> memory" — they were one component described twice. Read it before Appendix A;
> its §2a corrects three things the older designs assert about the code that
> are not true (most importantly: **detections are not labelled with cells**,
> so the pixel → cell step is real work, not an inherited input).

**Implemented.** `rig/placement_ledger.py` is the memory, `rig/supervisor.py`
is the subtraction, `web/app.py` runs it once per accepted frame, and
`web/state.py` publishes `vision_verification` plus a `SupervisionModel` that
four surfaces render. `vision_verification` is populated — the run-report column
was free as predicted, and the runner log row needed one extra event because the
verdict cannot exist until ~0.6 s after the result the row is written from.

**Gate 0 was measured on the rig on 2026-09-07** and settled the risk this idea
lived or died on: a hand over the board reads **105× the parked median**, and
the quiet window opens in 42–47% of frames *during a running program*. So
supervision is not restricted to a between-jobs activity.

What is **not** built: M4's bounded automatic repair, and M5's lift of the
level-3 detection ceiling. And nothing here has been watched on hardware —
there is no camera on the development desktop.

Appendix A is kept below for its reasoning — the decisions and why they were
made. **The milestones, the file list and the known limits live in the plan
file, and several of Appendix A's claims about the code are wrong; the plan's
§2a says which.** Read the plan and its build record, not this, for what was
actually built.

### 1.5 Colour-aware planning and next-block guidance — built in Studio

Detections already carry a colour name. Let a model assign a colour per block,
then have the console preview which colour the automatic feeder path must stage
next: **`NEXT: RED`**. The current Uno stages the hopper's next block; it does
not select colours, so loading/sorting the hopper remains an operator concern.

### 1.6 Build execution runner — built (Studio M7)

Given a compiled model, step through it: current command, blocks placed / total,
elapsed and estimated remaining from measured cycle time, per-block confirm or
continuous run, and a clean resume point if a build is rejected. The safety
rules do not change — one command at a time, never queued.

**Built** as the Studio's runner: `web/src/studio/runner.ts`,
`runner-driver.ts`, `run-report.ts`, surfaced by
`web/src/components/RunnerPanel.tsx`. See [STUDIO.md](STUDIO.md) M7.

---

## Tier 2 — credibility and polish

| # | Feature | Why it earns its place |
| --- | --- | --- |
| 2.1 | **Session timeline** — every build with timestamp, command, result, duration and a camera thumbnail at completion | Becomes the evidence section of the written report |
| 2.2 | **Time-lapse export** — save a JPEG on every `PLACED`, stitch to GIF/MP4 | Frames already flow through the pipeline; near-free, enormous demo value |
| 2.3 | **Telemetry strip** — builds today, placed/rejected/aborted counts, mean cycle time, camera FPS, socket round-trip | Makes the console feel instrumented rather than decorative |
| 2.4 | **Diagnostics page** — serial port, board FQBN, camera settings in force, calibration age, workspace-map presence, self-test | The page you open when a demo misbehaves in front of an examiner |
| 2.5 | **SIMULATION badge** — the console already runs `--mock` with no hardware; say so unmistakably on screen | Lets you rehearse and present with zero risk, honestly labelled |
| 2.6 | **Audio and haptic result cues** — distinct tones for placed / rejected / locked, `navigator.vibrate` on phones | The operator is looking at the rig, not the screen. This is real usability |
| 2.7 | **Calibration wizard** — stepped four-corner flow with progress, preview and a saved-calibration timestamp | Replaces a row of bare buttons with something an examiner can follow |
| 2.8 | **Control arbitration** — one operator "holds" the rig, others are view-only | Deferred in [CONSOLE.md](CONSOLE.md); cheap to fake convincingly, good safety story |
| 2.9 | **Run report export** — Markdown/PDF of a session: model, commands, results, timings, photos | Straight into the thesis appendix |
| 2.10 | **QR code on screen** to open the console on a phone | Two lines of code, always impresses |
| 2.11 | **Kiosk mode** — fullscreen, no chrome, for a tablet mounted at the rig | Makes the installation look like a product |
| 2.12 | **E-stop status surface** — the hardware interlock is deferred; display `E-STOP: NOT FITTED` honestly, and require the operator to hold the button for unattended runs | Honesty about a known gap reads as engineering maturity, not weakness |

---

## Tier 3 — the camera as an instrument

Every idea above uses the camera the way it is used today: as a **monitor**. It
watches the board, it calibrates the grid against printed sheets or placed
blocks, and it draws overlays. Tier 1's supervision and plan-projection are more
of the same lens — the camera looking at *blocks*.

This tier is the other use, and nothing in the repo does it yet: **the camera as
the only measuring device on the rig, pointed at the machine itself.**

The reason it earns a tier is embarrassing and easy to fix. Almost every physical
number in this project is a guess, and — to the codebase's credit — each one says
so out loud:

| Number | What it says about itself | Where |
| --- | --- | --- |
| `BLOCK_CYCLE_SECONDS = 2.115` | five `--mock` placements; *"rehearsal transport, not the physical arm"* | [studio/settings.ts](../web/src/studio/settings.ts) |
| `LATCH_HOMING_SECONDS = 16` | *"A guess until M7 measures it"* | same |
| `CLAW_MARGIN_MM = 8` | *"A guess about the claw's width. Measure the claw and change this."* | same |
| `SUPPORT_RATIO = 0.55` | *"Nobody has measured this rig."* | same |
| `SETTLE_SECONDS = 1.5` | *"belt-and-braces wait on top of the firmware's own confirmation"* | [rig/block_calibration.py](../python/rig/block_calibration.py) |
| camera height `H` | the one extrinsic `block_levels` needs, and it is a tape measurement | [vision/block_levels.py](../python/vision/block_levels.py) |

A camera is already pointed at the workspace at 10 Hz. **Every one of those is
something it could measure instead.** That is the cheapest credibility available
in the project, and it is the difference between a report that says "the system
places blocks" and one that says "placement repeatability is ±0.4 mm, measured
over sixty placements".

Everything in this tier is **software only** — no firmware change, no new
detector, no second camera, no extra frames beyond the ones `ConsolePipeline`
already produces.
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
