ahmedjk34/hardware-grad-project/docs/dual-orientation-grid.md

# Dual-orientation grid — vertical and horizontal, both calibrated

**State:** built on the desk — all eight steps have regression coverage; camera
and hardware verification remain. See §10 for exactly what has and has not run.
**Blocked on:** nothing; §4 was answered (see §4)

> **Numbers here are pre-revision. Read §5 and §10 first.** This started as a
> plan against a 7.5 cm block / 0.5 cm gap layout with a centred allocation.
> The shipped geometry is a **2.2 × 6.0 × 1.5 cm** block, uniform **1.6 cm**
> gaps on every axis, and a **centre-anchored** lattice (`centre(i) = trim +
> error_offset + shift + i·pitch`). Vertical is **7 × 6** addressable
> (6 × 5 positive), horizontal **3 × 10** (2 × 9 positive); holder travel is
> **22.8 × 38.0 cm**. `config/rig.json`, `python/rig/grid.py` and
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
