ahmedjk34/hardware-grad-project/artifacts/stack-detector-20260909/combined.png

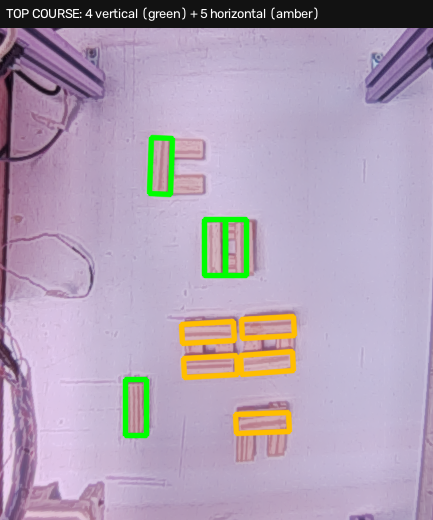
artifacts/stack-detector-20260909/combined.png
