ahmedjk34/hardware-grad-project/python/camera/Camera Feed - picamera2 @ 1296x972, sensor mode 1296x972_screenshot_20.08.2026.png

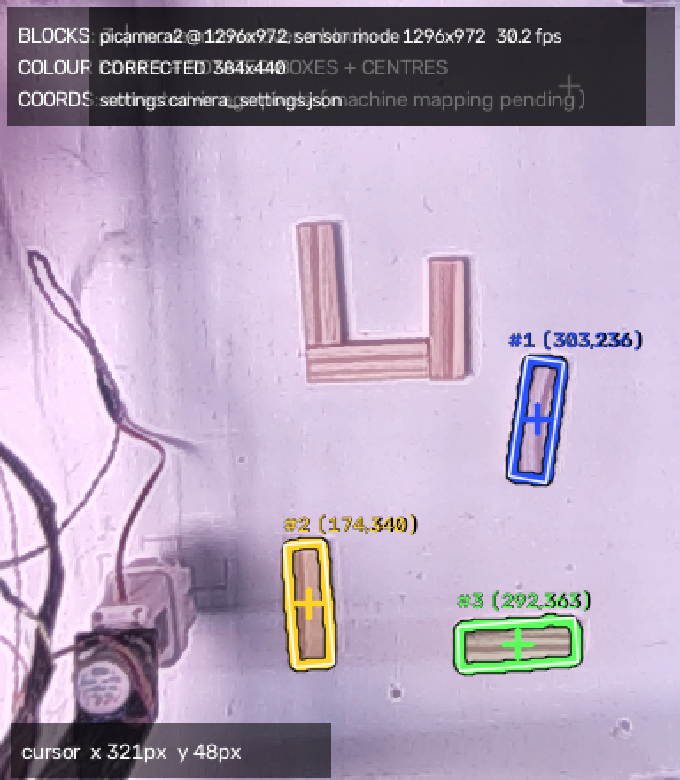
python/camera/Camera Feed - picamera2 @ 1296x972, sensor mode 1296x972_screenshot_20.08.2026.png
