ahmedjk34/hardware-grad-project/python/captures/20260902-165930_corrected_equidistant-lens160-out120-k+0.04_+0.00_+0.02_+0.00-c+0_+0-f1.200_1.000-s+0.000-p-0.028_+0.000.png

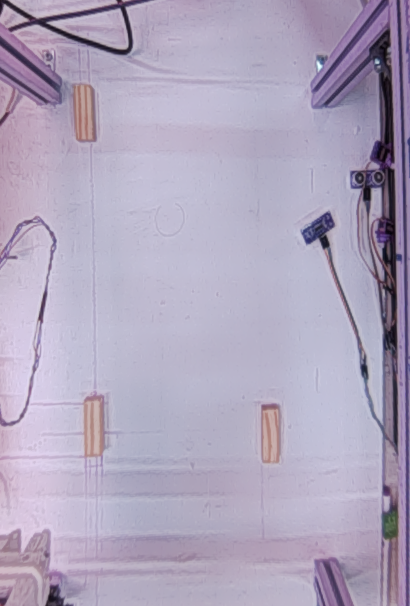
python/captures/20260902-165930_corrected_equidistant-lens160-out120-k+0.04_+0.00_+0.02_+0.00-c+0_+0-f1.200_1.000-s+0.000-p-0.028_+0.000.png
