ahmedjk34/hardware-grad-project/python/captures/20260903-122957_corrected_equidistant-lens168-out120-k+0.14_+0.18_+0.03_+0.00-c+0_+0-f1.200_1.000-s+0.020-p-0.028_+0.000.png

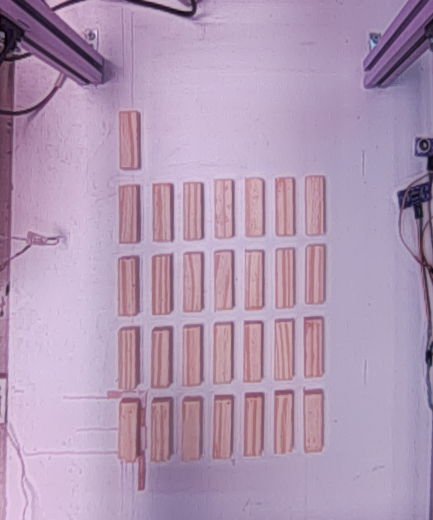
python/captures/20260903-122957_corrected_equidistant-lens168-out120-k+0.14_+0.18_+0.03_+0.00-c+0_+0-f1.200_1.000-s+0.020-p-0.028_+0.000.png
