ahmedjk34/hardware-grad-project/python/captures/20260905-123235_corrected_equidistant-lens168-out120-k+0.14_+0.18_+0.03_+0.00-c+0_+0-f1.200_1.105-s+0.042-p-0.020_+0.008.png

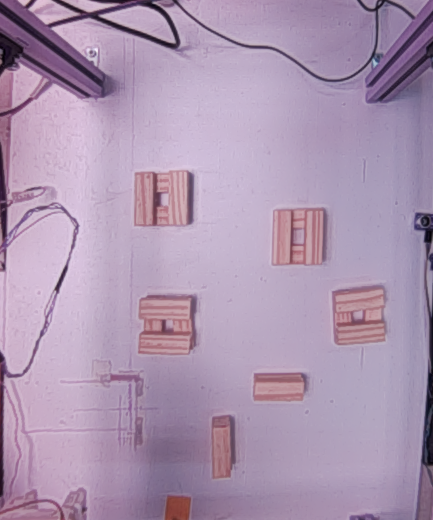
python/captures/20260905-123235_corrected_equidistant-lens168-out120-k+0.14_+0.18_+0.03_+0.00-c+0_+0-f1.200_1.105-s+0.042-p-0.020_+0.008.png
