ahmedjk34/hardware-grad-project/python/captures/20260908-184831_blocks.png

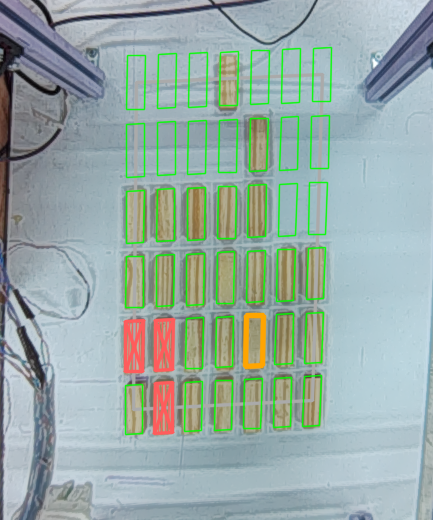
python/captures/20260908-184831_blocks.png
