ahmedjk34/hardware-grad-project/python/captures/20260909-094841_raw.png

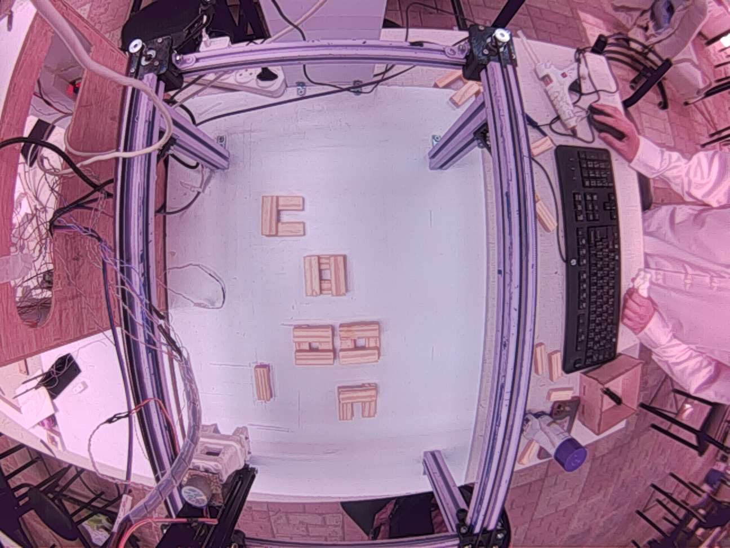
python/captures/20260909-094841_raw.png
