ahmedjk34/hardware-grad-project/python/captures/camera_live.png

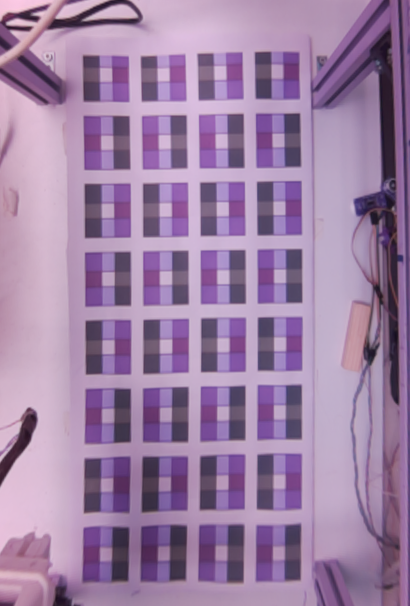
python/captures/camera_live.png
