ahmedjk34/hardware-grad-project/python/captures/color_correction/raw_with_phone.jpeg

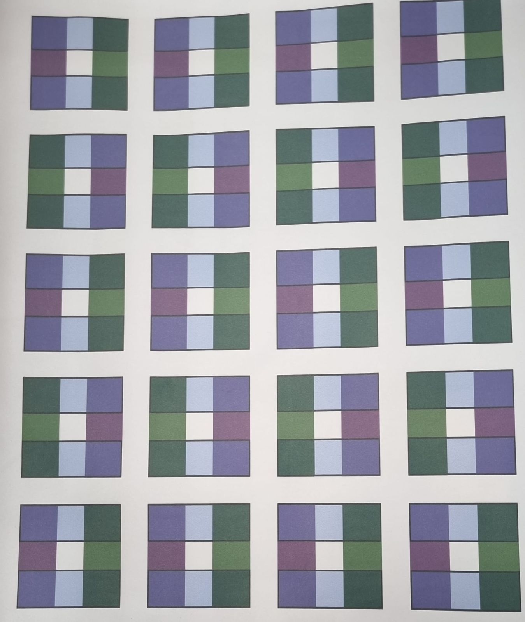
python/captures/color_correction/raw_with_phone.jpeg
