ahmedjk34/hardware-grad-project/python/captures/physical_grid_digital_image.jpeg

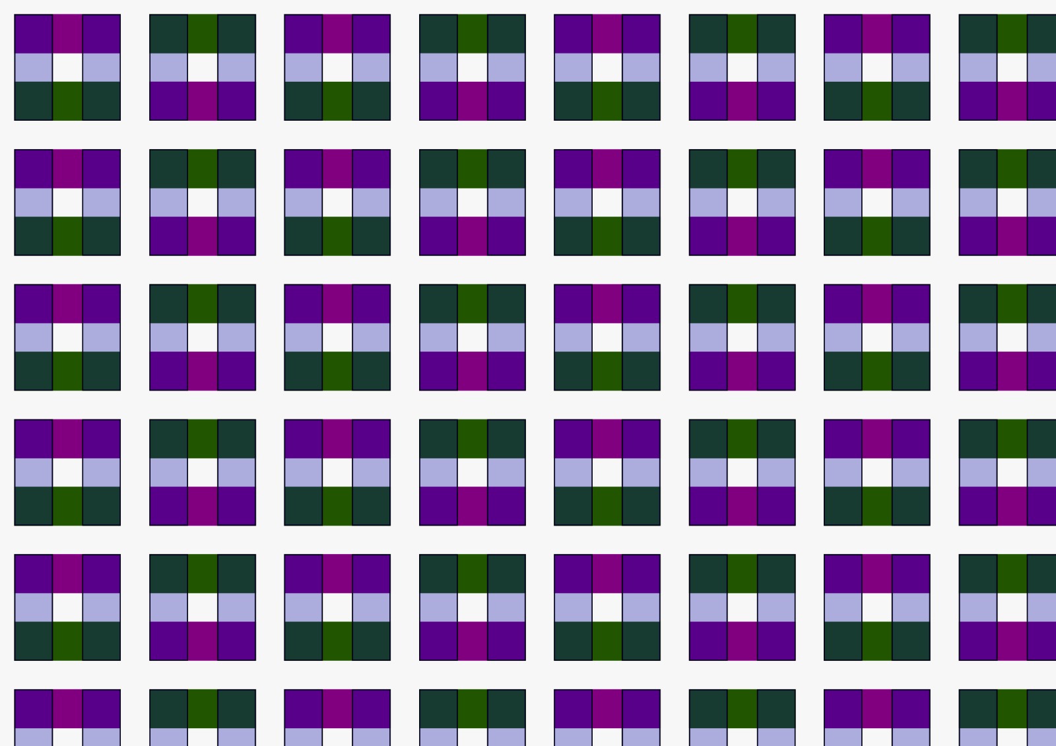
python/captures/physical_grid_digital_image.jpeg
