ahmedjk34/hardware-grad-project/python/captures/WITH_BLOCK_DETECTOR_ON_EXAMPLE.png

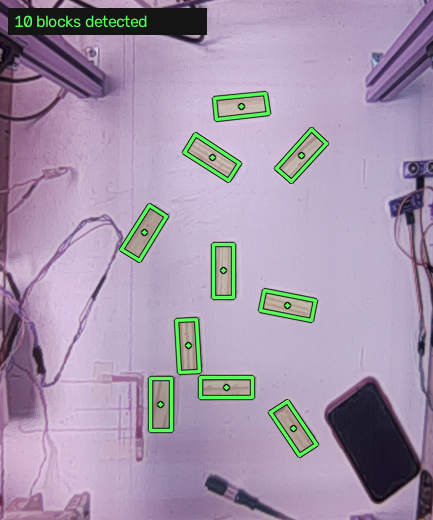
python/captures/WITH_BLOCK_DETECTOR_ON_EXAMPLE.png
