ahmedjk34/hardware-grad-project/report_src/figs/combined-grid.png

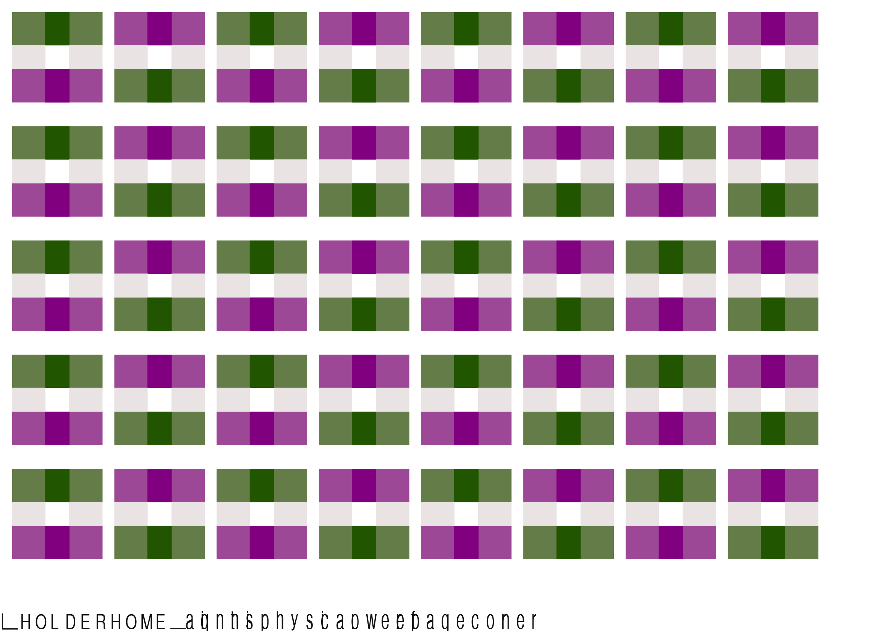
report_src/figs/combined-grid.png
