ahmedjk34/hardware-grad-project/report_src/figs/fig-combined-target.png

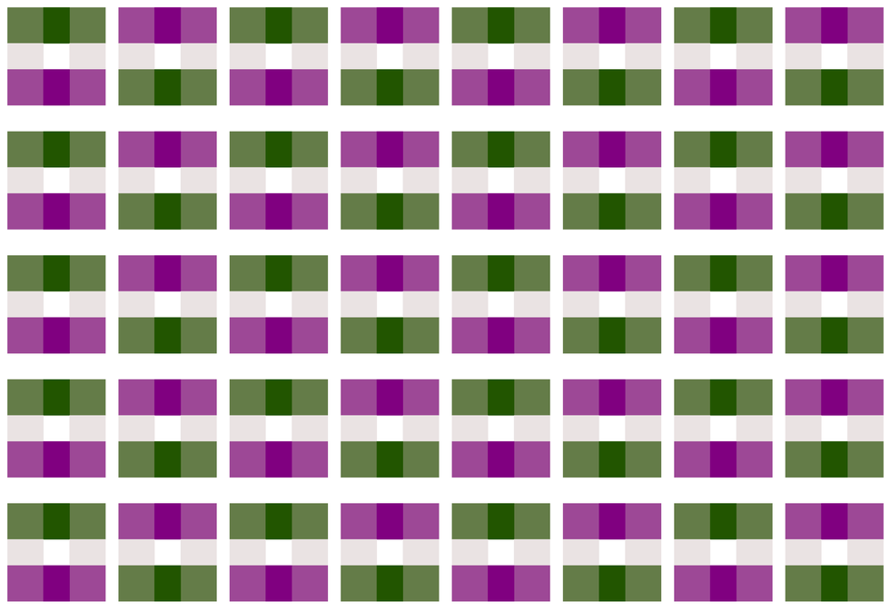
report_src/figs/fig-combined-target.png
