ahmedjk34/hardware-grad-project/report_src/figs/fig-descent-vs-level.png

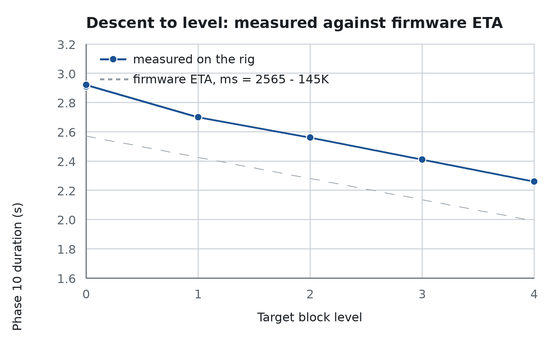
report_src/figs/fig-descent-vs-level.png
