ahmedjk34/hardware-grad-project/report_src/figs/fig-detection-pair.png

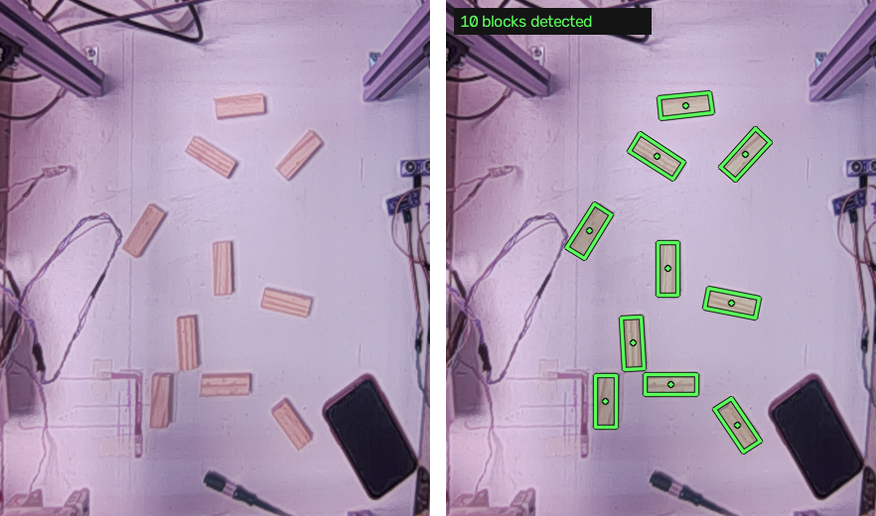
report_src/figs/fig-detection-pair.png
