ahmedjk34/hardware-grad-project/report_src/figs/fig-reference-board.png

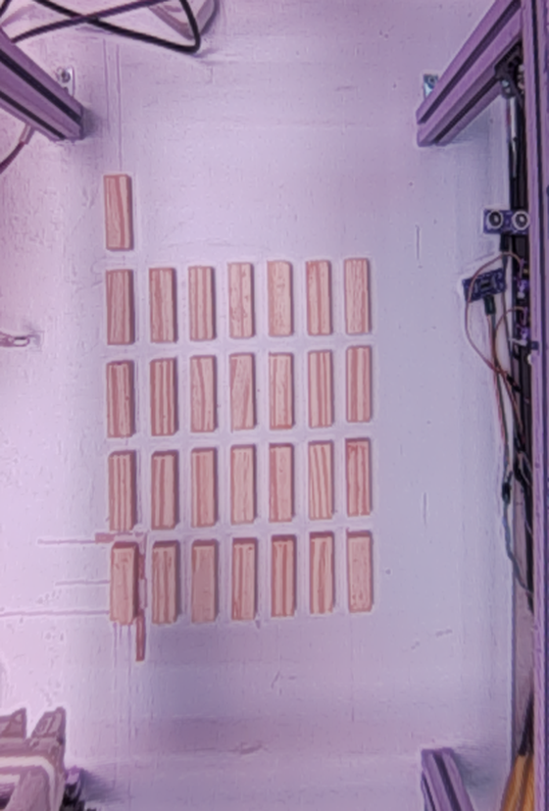
report_src/figs/fig-reference-board.png
