ahmedjk34/hardware-grad-project/report_src/figs/fig-target-detail.png

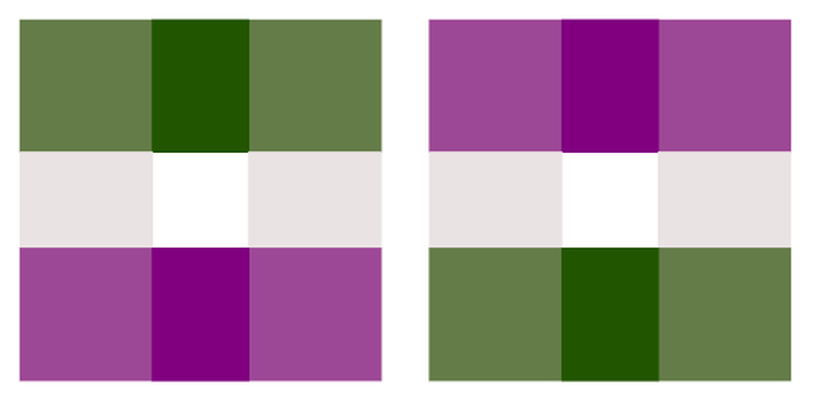
report_src/figs/fig-target-detail.png
