ahmedjk34/hardware-grad-project/report_src/figs/fig-traverse-vs-column.png

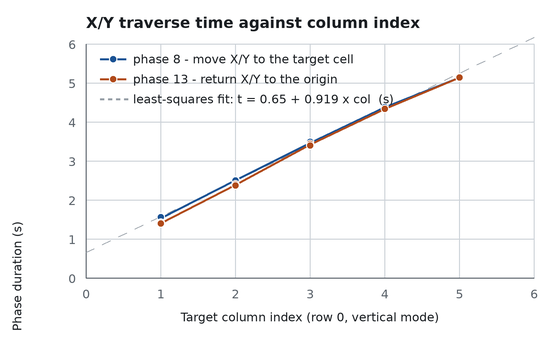
report_src/figs/fig-traverse-vs-column.png
