ahmedjk34/hardware-grad-project/docs/Bill_of_Materials.md

# Bill of Materials — Hardware Grad Project

## Compute

| Item | Qty |
| --- | --- |
| Arduino Mega | 1 |
| Raspberry Pi 5 (8GB RAM) | 1 |
| Raspberry Pi 5 Camera Module (Fisheye 160° FOV) + cable | 1 |

## Motion / Actuators / Sensors

| Item | Qty |
| --- | --- |
| NEMA17 Stepper Motor | 3 |
| TB6600 Driver | 3 |
| Stepper Motor 28BYJ-48, 5V | 1 |
| ULN2003 Driver | 1 |
| Servo Motor | 1 |
| Limit Switch | 4 |

## Mechanical

| Item | Qty | Note |
| --- | --- | --- |
| Linear Rail + Linear Motion Bearing | 1 | 1.5m x 15mm |
| Aluminum Profile | 1 | Gantry frame and ~30cm Z column; cut from 6m stock |
| Timing Pulley | ~9 | CoreXY and Z drive |
| 3D Printed Parts | multiple | Carriages, claw and mounts |
| Timing Belt | 4 | 5 Meters GT2, 1 meter belet |
| Castor Wheel | 8 | For X/Y movment, attached to 3d parts |

## Electrical / Power

| Item | Qty |
| --- | ----- |
| Power Supply, 12V 15A | 1 |
| LM2596 Adjustable Buck Converter (4–40V → 1.25–37V, 3A, with display) | 1 |
| Resistors & Capacitors (assorted) | 1 lot |
