ahmedjk34/hardware-grad-project/docs/server-guide.md

# Rig operator console — server guide

This guide runs the browser console in the `hardware-grad-project` checkout.
The service owns exactly one camera and one Arduino serial connection, so run
one backend process only. Do not start multiple Uvicorn workers or launch a
second camera/serial client while the service is running.

For how a placement travels from the browser through the Pi to the Mega and
back, see
[docs/communication-pipeline.md](communication-pipeline.md).

## 1. Prerequisites

You need:

- Python 3 and the repository virtual environment at `.venv/`.
- Node.js and npm for the browser app.
- For mock operation: no hardware.
- For real operation: a configured camera and a powered, flashed Arduino Mega.

On a desktop, create the environment once with:

```bash
cd /home/ahmedjk34/Desktop/Work_Dev/Miscellaneous/hardware-grad-project
python3 -m venv --system-site-packages .venv
.venv/bin/pip install -r requirements-dev.txt
```

The Raspberry Pi should use its distro-provided NumPy/OpenCV/Picamera2 and the
venv for the remaining Python packages. Do not pip-install `numpy` or
`opencv-python` into the Pi venv; see [AGENTS.md](../AGENTS.md).

Install the browser dependencies once:

```bash
cd web
npm install
```

## 2. Check configuration

Before starting, inspect `config/rig.json`:

- `serial.port`, `serial.baud`, and `board.*` identify the Mega gantry.
- `grid.active_mode` selects the vertical or horizontal layout.
- `workspace.width_cm` and `workspace.height_cm` are the holder travel
  envelope; they are not the observed build footprint.

Camera settings are read from
`python/config/camera_settings.json`. A saved
`config/workspace_map.json` is generated calibration data and is ignored by
Git. Delete that local file only when you intentionally want to recalibrate.

On the Pi, enumerate stable device names with:

```bash
ls -l /dev/serial/by-id/
```

If the configured paths exist but open fails with `Permission denied`, add the
service account to the distro's serial-device group (normally `dialout` on
Raspberry Pi OS), then log out/in or restart the service session so the new
group membership takes effect. Do not solve identity or permission problems by
running the web service as root.

If the sketch or any shared geometry/baud value changes, update both firmware
and Python-side partners as described in [AGENTS.md](../AGENTS.md), then run the
grid/config tests before connecting hardware.

## 3. Run a complete mock console (recommended first)

Use two terminals from the repository root.

Terminal A — backend:

```bash
PYTHONPATH=python .venv/bin/python -m web --mock --host 127.0.0.1 --port 8000
```

Terminal B — browser app:

```bash
cd web
npm run dev -- --host 127.0.0.1
```

Open the URL Vite prints, normally `http://127.0.0.1:5173/`. The Vite proxy
forwards `/api/*` and `/api/events` to the backend on port 8000. Mock mode
provides a simulated camera and Mega; it does not move hardware.

The mock workflow is:

1. Wait for the camera badge to become `LIVE`.
2. Tap a grid cell. The server returns the authoritative selection and `B`
   command label.
3. Tap `BUILD`, stage one block at pickup, then tap the displayed confirmation.
4. When the Mega pauses with its claw open, align the block and tap `CLOSE CLAW`.
5. Watch the RUNNING banner and terminal result.
6. Use **Calibrate** for four-corner calibration if you want to exercise the
   generated map path. The current mock artwork is not a full-fidelity printed
   calibration sheet; test the printed-sheet route with a real sheet/camera.

## 4. Run with the real rig

First discover, flash, and bench-check the configured Mega:

```bash
scripts/flash.sh boards
scripts/flash.sh compile
scripts/flash.sh upload
```

Then start only the backend on the Pi (or the machine physically connected to
the rig):

```bash
cd /home/ahmedjk34/hardware-grad-project
PYTHONPATH=python .venv/bin/python -m web --host 0.0.0.0 --port 8000
```

Do not pass `--mock`. The backend opens and validates the configured Mega port
during startup. If it cannot connect cleanly, stop and inspect the camera,
USB cables, board resets, and the values in `config/rig.json`; do not work
around it by starting another process.

From a phone or tablet on the trusted LAN, open `http://<raspberry-pi-ip>:8000/`
if you have copied/built `web/dist/` on the Pi. The FastAPI process serves that
bundle and the `/api/*` routes from the same origin. The backend itself is HTTP
unless you place it behind an HTTPS reverse proxy; do not expose port 8000
directly to the public Internet.

## 5. Build and serve the PWA

Create the production app bundle with:

```bash
cd web
npm test
npm run build
```

For a no-separate-frontend-server deployment, build on the Pi (or copy the
resulting `web/dist/` directory to the Pi) and then start the backend from the
repository root:

```bash
cd /home/ahmedjk34/hardware-grad-project/web
npm install
npm test
npm run build
cd /home/ahmedjk34/hardware-grad-project
PYTHONPATH=python .venv/bin/python -m web --host 0.0.0.0 --port 8000
```

Open `http://<raspberry-pi-ip>:8000/` on the phone. There is exactly one server
process: FastAPI serves `web/dist/`, REST, the WebSocket, and MJPEG stream.
Node/npm is needed to build the bundle, not to keep the live UI running.

The generated `web/dist/` directory is a deployment artefact and is ignored by
Git. Serve it from a static web server or local HTTPS reverse proxy, forwarding
these paths to the single backend process:

| Browser path | Backend route |
| --- | --- |
| `/api/state` | REST state snapshot |
| `/api/events` | WebSocket event stream (state, build phases, serial, results) |
| `/api/stream.mjpg` | shared MJPEG camera stream |
| `/api/select`, `/api/build`, `/api/level`, etc. | guarded commands |
| `/api/calibration/*` | guarded calibration routes |

The frontend must not cache `/api/*`, `/api/events`, or the MJPEG stream. Only
the app shell may be precached; stale rig state or camera imagery is unsafe.

### The `/api/events` protocol

Every frame carries `type`, a monotonic `event_id` and an `at` timestamp in
epoch milliseconds. There are five fact types plus one envelope:

| `type` | Carries |
| --- | --- |
| `state` | the whole `StateModel` snapshot, under `state` |
| `build_step` | one firmware build phase: `command_seq`, `step`, `total`, `phase`, `label`, `action`, `status`, `eta_ms` |
| `build_result` | one settled build: `command_seq`, `result`, `reason`, `locked`, `locked_reason`, `from_prose` |
| `serial` | one Mega raw line, under `line`, with `stream` (`rig` / `error`) |
| `heartbeat` | nothing but its id — proof the socket is alive |
| `replay` | the envelope a reconnect's missed events arrive in: `events`, plus `gap` |

**Priority.** `serial`, `build_step` and `build_result` are DURABLE: delivered
exactly once each, in order, and kept in a bounded server-side replay buffer.
`state` is COALESCED: each client holds only the newest pending snapshot,
because a snapshot describes *now* and an older one has no value once a newer
one exists. Durable events are always sent first, so a backlog of camera
geometry can never delay a build phase.

**Rate.** A state snapshot goes out immediately whenever something semantic
changes — a selection, a phase, a result. A snapshot whose only change is
camera geometry is throttled to `geometry_hz` (default 5) rather than the
driver's 20 Hz.

**Reconnecting.** Open with `?after=<the newest durable event_id you applied>`
and the server replays everything after it, in one `replay` envelope. If that
id predates the buffer, `gap` is true and the client says so rather than
pretending its log is continuous. Deduplicate with `>` on the id — **never by
comparing text**, because two identical serial lines are two real lines, and
**never** by assuming `previous + 1`, because coalesced snapshots and
heartbeats consume ids without being replayable.

**What the build fields mean.** `build_phase_status` walks `idle → accepted →
validating → running → parking → placed | rejected | aborted | locked`.
`parking` is still a RUNNING command: the block is down and the rig is tidying
up. `build_release_confirmed` is phase 11's `status=done` — the jaws opened —
and is **not** a placement. Nothing says `placed` before the terminal `@n OK`
arrives as a `build_result`.

**`eta_ms`** is the firmware's own prediction of how long a phase will take,
present on the Z moves only and `null` everywhere else. The board computes it
(exact step count x its Z step period) because the constants it needs are
firmware-owned and the Pi may not keep copies. It is a FLOOR — the real move can
only take longer — so a client may animate from it but must never treat its
expiry as the phase having finished.

The firmware reports PHASES, not motor positions. There is no continuous
position telemetry, so no client may claim to know where the arm is between
phases. The one animation driven by a clock is the placement descent, and it is
clamped short of the cell so that only the real release event can land the
block.

## 6. Safety rules while operating

- A build always requires selection followed by a second confirmation tap.
- During `RUNNING`, the server rejects mutations. Mega motion cannot be
  interrupted; the runner's stop control means stop after the current block.
- Once the operator confirms a block is staged, any Mega non-success locks the
  session because pickup/claw state may be unknown.
- A placed build clears the selection.
- An aborted build, timeout, reset, or cable-loss/unknown outcome locks the
  session. Stop touching the controls, inspect the physical rig, and restart
  the service only after a human has verified its state.
- Calibration, selection, and build commands are server-guarded for freshness,
  build state, and lock state. Never rely on a disabled browser button as the
  safety mechanism.

## 7. Run logs

A real server run (`python -m web`, with or without `--mock`) appends to three
plain-text files under `logs/` at the repository root. All are git-ignored and
opened in append mode, so they accumulate across runs; delete them
yourself when they get large. `pytest` never writes to them — only the
`main()` entry point turns them on, via `rig.build_log.configure()`.

- **`logs/build.log`** — one clearly separated section per build triggered from
  the web console. It records the `/api/build` request, the job-thread handoff,
  the board's `RECV`, then every firmware phase with the ETA the firmware
  predicted beside the time the phase actually took (`(firmware ETA 2.57s,
  +0.23s)`), and the settled result with the total elapsed. Every timestamp in
  a section is relative to that build's start, so it reads as a stopwatch.
- **`logs/serial.log`** — every line to (`>>`) and from (`<<`) the Mega,
  each stamped with the wall clock and the gap since the previous serial line.
  `[MEGA/GANTRY]` identifies the source.
  A stall on the cable or a slow phase shows up directly as a large delta in
  the second column. The terminal ack and a one-line `-- final: …` summary
  close each build.

- **`logs/placements.log`** — the board's own timeline: what was placed, and
  what the camera made of it. One `PLACED` line per confirmed placement (the
  as-built record behind `rig/placement_ledger.py`), one `CHECK` line per
  settled build carrying the camera's sentence about it, and one line each time
  the observer **changes** what it says about the board — a verdict, or a
  refusal such as `NO MAP` / `NO MEMORY`. Deliberately per *change* and not per
  frame: at the pipeline's measured 8.6–8.7 Hz a line a frame would be half a
  million entries an hour and the one that mattered would be unfindable.

  **Nothing ever reads this file back.** It is evidence, not authority — a
  reloaded ledger would claim to describe a board nobody has looked at since the
  process died, and what consumes the ledger drives a claw. After a restart the
  console reports `NO MEMORY` and refuses every verdict until the first build.

Placed-block calibration drives the rig through the same serial link, so its
traffic also appears in `logs/serial.log`; it does not get a `logs/build.log`
section.

The code is `python/rig/build_log.py`, wired in from `python/web/app.py`,
`python/web/routes_command.py`, and `python/rig/link.py`.

## 8. Troubleshooting

**The page says `DISCONNECTED`.** Confirm the backend is listening on port
8000, the browser is using the correct host, and the reverse proxy forwards the
WebSocket upgrade for `/api/events`. In development, keep the backend on 8000
and use the Vite dev server so its proxy remains active.

**Camera stays `WAITING` or becomes `STALE`.** Check the camera connection and
`python/config/camera_settings.json`; on a desktop use `--mock` because the
Pi CSI camera is not available there. A stale frame is intentionally refused
for selection and calibration.

**The board does not connect.** Verify `serial.*` and `board.*` in
`config/rig.json`; check that no other process owns the port. The service
validates the Mega handshake before it accepts requests.

**The overlay is amber.** No valid saved workspace map exists for the active
mode. Approximate-grid operation is supported; use four-corner or printed-sheet
calibration when you need a measured camera mapping.

**The session is locked.** This is deliberate. Inspect the claw, holder,
block, and gantry before restarting the service. There is no browser reset,
cancel, or retry path for an unknown machine state.

## 9. Verification commands

From the repository root:

```bash
PYTHONPATH=python .venv/bin/python -m pytest
cd web && npm test && npm run build
```

The Python suite (`pytest`) currently has two known failures, both isolated to
`mock_camera_test.py` and neither a console regression (see
[CONSOLE.md](CONSOLE.md) §6): a freeze/pump race — an in-flight frame arriving
just after `MockCamera.freeze()` — and `test_warm_mock_blocks_..._grid_cells`
occasionally seeing 1 detection instead of ≥2 for two same-colour blocks. Do
not hide either as part of server/frontend changes.

Note that `pytest` only collects the `*_test.py` files (`pytest.ini`); the
`python/tests/test_*.py` scripts are plain-assert programs, run individually
(`../.venv/bin/python tests/test_grid.py`). Three of those currently fail on a
fresh checkout for missing fixtures / a moved asset path — see the repo notes,
not this guide.
