ahmedjk34/hardware-grad-project/docs/printed-color-grid.md

# The printed colour calibration grid

A sheet of alternating green and magenta blocks, printed at the rig's own cell
geometry, that the camera can measure instead of an operator having to aim at
an invisible rectangle.

**The required behaviour is specified in
[printed-grid-spec.md](printed-grid-spec.md)** — read that to decide whether a
change is still correct. This document is how it works and what was measured.

**Current status.** The combined A2 target described below (§"The current
one-page target") is the primary, actively-used calibration artefact; its
geometry is verified by `python/tests/test_combined_grid.py` (all passing).
The legacy per-mode sheet described in §"The sheet" is a fallback only,
reachable through `detect_printed_grids()`; its reference training captures
are of the retired pre-6cm-block sheet and are skipped by
`test_color_grid.py` until a new legacy sheet is reprinted and reshot.

Implemented by `python/vision/color_grid.py` (geometry),
`python/vision/combined_grid.py` (the one-page target and legacy fallback),
`python/vision/color_grid_overlay.py` (drawing),
`python/camera/color_grid_check.py` (a tool that does nothing but prove it
works), the strict `p`/`k` routes in `camera/gridded_camera_feed.py` and
`camera/rig_build_v1.py`, and the evidence collector
`python/vision/grid_evidence.py`. The latter lives only in the non-moving
gridded feed: `e` starts it, Space accepts a frame and `k` saves once its
coverage gates pass. See
[Evidence-Assisted Printed-Grid Calibration](evidence-assisted-printed-grid-calibration.md).

---

## The current one-page target

The current printable artefact is
[`assets/combined-calibration-grid.svg`](assets/combined-calibration-grid.svg),
one A2 landscape page carrying both visible
block orientations. Detection treats its saturated green/magenta portions as
an **8 × 10 fiducial lattice**, not as 80 machine blocks:

| property | value |
| --- | --- |
| page | 59.4 × 42.0 cm, A2 landscape |
| fiducial bar | 6.0 × 2.2 cm, X thirds 2.2 + 1.6 + 2.2 cm |
| fiducial gaps | 0.8 cm X, 1.6 cm Y |
| lattice | 8 columns × 10 rows |
| first outer edge | 0.8 cm from page left, 4.8 cm from page bottom |
| machine registration | physical lower-left page corner = holder home |

The supplied `grad project grid white background.png` is 2245 × 1587 px
(37.79 px/cm). Away from one-pixel antialiased edges, a composite tile measures
227–228 px square. Its X runs are approximately 83 px muted chromatic/beige,
60 px dark chromatic or white, and 83 px muted chromatic/beige. Its Y runs are
approximately 83 px chromatic, 60 px beige/white/beige, and 83 px opposite
chromatic. Tiles repeat every 257 px in X (about 0.8 cm white separation) and
287 px in Y (the extra 60 px is the plain-white 1.6 cm separator). This measured
raster geometry is the source of the 2.2 + 1.6 + 2.2 cm internal model; it is
not inferred from the old detector comments.

The olive shades use a detector-local wider green hue window. The exact raster
is an 8 × 5 array of 6.0 × 6.0 cm composite tiles. Read along X, each of the 80
chromatic bars is muted colour + dark same colour + muted colour: one vertical
fiducial. Read perpendicular to those bars, the left and right 2.2 cm lanes of
each tile are colour + beige + opposite colour: two separate horizontal
fiducials, 80 total. The 1.6 cm centre lane is white in the middle and is a
local paper reference. Four other intervals are plain-white separators.

Detection first uses the full chromatic bars, then retries faded/cracked ink
with stronger mask closing. If those fills have nearly disappeared, the dark
centre accents are isolated with separate green and magenta Otsu thresholds
plus local saturation contrast. After fitting the homography it samples every
projected subregion and classifies green, purple or beige/gray using normalized
channel opponents, HSV saturation, Lab prototype distances and locally
adaptive thresholds. Each physical pattern is assigned exactly one of
vertical, horizontal or unknown; horizontal bridge evidence is never copied
onto either neighboring chromatic bar. The selected calibration mode chooses
one family before aggregation and output. Vertical mode returns only the 80
bars (`80/0/0`); horizontal mode returns only the 80 bridges (`0/80/0`). The
inactive family may support shared colour normalization internally but is not
counted, labelled or drawn. The two selected views expose the same logical
8 × 10 cell addresses. Gray alone cannot vote: the fallback still has to pass
the complete
8 × 10 chromatic geometry, alternating-colour parity, aspect and residual
gates. All 80
chromatic bars fit one page-coordinate homography; that same
fit yields the shared holder envelope
(`grid.workspace_width_cm` × `grid.workspace_height_cm` = 22.8 × 38.0 cm) for
either active mode.
The resulting `WorkspaceMap` is still saved under the active mode and embeds
that mode's independent block/gap/trim geometry.

A camera-cropped diagnostic frame may fit/extrapolate the 8 × 10 homography
from a broad partial lattice and decode only its complete visible patterns.
That is orientation evidence, not permission to save geometry: fewer than
76/80 page-plane observations makes `workspace_corners()` refuse calibration.
Frame-edge partial bars are excluded from both votes and evidence.

The `firmware` home convention is mandatory for the combined target. The
`printed` convention below belongs only to the legacy real-block sheets.

`detect_printed_grids()` tries this target first and falls back to the two
legacy sheets. `PrintedGridEvidence` locks onto whichever target the first
accepted frame used, so the existing evidence-assisted route works for the
combined page too without mixing observations from two designs. Overlay labels
`V: G-G-G`, `H: G-B-P` and `?: ...` show the measured signatures rather than
build-cell names.

Horizontal decoding compares each beige middle with the adjacent 1.6 cm white
centre lane at the same illumination. Its two end thirds must remain chromatic
and opposite; beige or gray alone never votes. If an individual beige middle
is washed out, it may be inferred only after directly measured bridges choose
one alternating interval parity sheet-wide. Inferred cells are `H~`; directly
measured ones are `H`.

---

## The sheet

Each printed cell has the active mode's block footprint with white between
neighbours — **a uniform 1.6 cm on both axes** (an earlier revision claimed
0.8 cm along Y; that was wrong — see AGENTS.md §3a): vertical is
**2.2 × 6.0 cm**, horizontal is **6.0 × 2.2 cm**. Both come from
`config/rig.json`, so the paper and the machine are describing the same grid.
Colours alternate like a chessboard, which costs nothing to print and gives
the detector a free consistency check: if a cell's colour disagrees with the
parity of its index, the indices are wrong.

The sheet is deliberately printed **larger than the machine's grid**. An A2
print holds more cells than the mapped window. Vertical maps 7 × 6; the
horizontal sheet maps **3 × 10** (30 cells — the horizontal grid dropped from
11 to 10 rows in a later block revision; see
[dual-orientation-grid.md](dual-orientation-grid.md) §3). That surplus is what makes the sheet usable at
any camera height without reprinting it — and it is why choosing which cells
count, and which of several overlapping mode-sized windows to calibrate on, is
half the problem.

### What is not part of the project

* **Partial cells.** Any block clipped by the edge of the paper or the edge of
  the frame. Their centres and sizes are both wrong, so they are excluded from
  the fit entirely rather than down-weighted. A whole cell that merely comes
  *near* the frame border is excluded too: `edge_margin` (a fraction of the
  cell's own size, default 0.5) is how much clear space it must keep. `0`
  disables that and keeps every visible cell.
* **The outer white margin.** The sheet has one; the grid does not. The grid
  ends at the outer edge of the last whole block, with no trailing margin, the
  same way the machine's grid ends at the last block edge.
* **Inner margins are real.** The 1.6 cm (X) / 0.8 cm (Y) between blocks is
  white paper, not a rounding artefact. `cell_at()` returns `None` there instead
  of naming the nearer block, because quietly absorbing the gap would widen
  every cell.

---

## How the fit works

0. **The frame is white balanced first**, driving its bright quantile to
   neutral. See [Colour, and why this is not optional](#colour-and-why-this-is-not-optional).
1. **Two hue windows** segment the inks. Hue plus a saturation floor rather
   than brightness: the two inks stay far apart in hue (green at 80-88 in
   OpenCV's 0-179 scale in a clean capture, 101 in a balanced rig frame;
   magenta at 150-162; nothing in between).
2. **Each blob becomes a rotated rectangle.** Broad aspect, area and colour-
   purity checks decide which rectangles may vote on the median size and
   long-axis direction. Rejected scene blobs are still drawn for diagnosis.
3. **Multiple breadth-first walks** hand out integer lattice indices, hopping
   from cell to cell using *that cell's own* measured size times the known
   pitch/block ratio. Each connected hypothesis is fitted provisionally, then
   other physical blobs close to its integer grid sites are recovered. This
   bridges a missed local hop without inventing an occluded cell. Hypotheses
   are ranked by coverage, chessboard parity and residual.
4. **A homography is fitted** from integer indices to cell centres; every cell
   is re-scored against the footprint the fit predicts *for it*; the fit is
   repeated on the survivors. Both an upper and lower fill bound reject clipped
   and merged cells. Colour parity, measured aspect, mean residual and maximum
   residual are hard acceptance gates rather than status-only measurements.
5. **Every strongly supported mode-sized window is retained** (7 × 6 vertical,
   3 × 10 horizontal), swept across **both** axes — an oversized sheet exposes
   every full copy of the coordinate map it contains, not just short-axis
   shifts off one anchored edge. A window needs at least 95% physical coverage
   with every row/column supported, so one underlit edge cell does not move the
   calibration but a clipped strip cannot pass; `edge_margin` additionally drops
   any window whose ring hugs the frame border. Windows are ordered by distance
   from image bottom-left (index 0 = the bottom-left-most) and capped at
   `max_windows` (16). The operator selects with `,` / `.` (or `--grid-window`)
   before `k` saves the map.

### Which axis is X

Never from the image alone. The explicit mode decides which physical side is
machine X: vertical maps 2.2 cm to X; horizontal maps 6.0 cm to X. The detected
short/long lattice axes then follow that declared geometry, whichever way the
sheet was photographed. `ColorGridSpec.mode` and the 7 × 6 / 3 × 10 complete
counts cross-check the `MachineGrid` before calibration; a partial sheet never
causes an orientation guess.

---

## Colour, and why this is not optional

The first live frame from the rig detected **nothing at all**, and it is worth
recording why, because the failure was invisible from the outside.

The camera's white balance had put a heavy magenta cast over the whole scene.
Measured off that frame:

| what | HSV, raw | HSV, white balanced |
| --- | --- | --- |
| green ink | **(120, 49, 168)** | (101, 48, 160) |
| magenta ink | (153, 97, 160) | (155, 75, 153) |
| white paper | (137, 37, 195) | (98, 15, 186) |
| the wall behind the rig | (139, 78, 176) | (135, 53, 168) |

The green ink had moved to hue **120 — cyan, not green** — with saturation 49.
It missed the green hue window *and* fell under the saturation floor, so half
of every sheet was simply not there. Worse, the pink **wall** landed inside the
magenta window with saturation 78, so the frame had plenty of "ink" in it, none
of it on the sheet.

Absolute hue windows cannot survive an arbitrary camera white balance, so the
detector now normalises first. `white_balance()` scales each channel so the
frame's 92nd-percentile brightness is neutral — white-patch rather than
grey-world, because the sheet's white paper is the brightest large thing in
frame and therefore a real white reference, whereas grey-world would be dragged
around by how much of the frame the pink ink happens to cover. It costs ~3 ms
on a 1296 × 972 frame (a lookup table, not a float pass), and it no-ops on a
frame that is already neutral.

The thresholds moved with it: green `(58, 115)`, magenta `(130, 178)`,
saturation floor `32`. The floor sits between the rig's green ink at 48 and its
white paper at 15.

The wall and the aluminium rails can still register as "magenta" under that
cast. They remain in the failure overlay, but broad shape/area/purity filters
exclude them from the direction and size vote before the lattice hypotheses
are built. An over-inclusive hue mask is useful, but its clutter is not allowed
to influence the fitted grid.

**This is worth fixing at the camera too.** A cast that severe also degrades
`block_detector.py`, which keys on red-minus-blue. `camera_studio.py` is where
the white balance and gains are tuned and saved.

---

## The paper and the firmware once disagreed at coordinate zero

**Historical — resolved by the centre-anchored lattice.** Kept because the
`--home-convention` switch is still in the code.

Before the centre-anchored lattice, the sheet printed a real block at
coordinate zero while the firmware treated zero as a bare home *point* with
only the gap before cell 1, so the printed grid was one block wider on X and
one taller on Y than the machine's, and `workspace_corners()` needed an
explicit convention to reconcile them. The figures that used to be worked out
here (`10 × 2.2 + 9 × 0.5`, `9 × 2.7 = 24.3 cm`, "45 positive cells",
"3.75 cm on Y") are all pre-revision.

Today the firmware **also** puts a real 2.2 × 6.0 cm block on the home corner
(cell 0's centre is home, half the block hanging back past the switches), so
`ColorGridSpec.from_config` reads `grid.cols` / `grid.rows` from config **with
no `+1`** and the counts agree outright. `workspace_corners()` still takes a
convention:

| convention | machine origin sits at | effect |
| --- | --- | --- |
| `firmware` *(default)* | the far corner of printed `[0,0]` | printed `[c,r]` lands exactly on the firmware's `[c,r]` for all positive cells |
| `printed` | the centre of printed `[0,0]` | every printed cell taken at face value; positive cells sit `block/2 − (pitch − grid.x_start)` further from home per axis |

`tests/test_color_grid.py` derives the expected offset from the current grid
geometry rather than hard-coding it, so the two conventions differ by whatever
the shipped trims say (`0` for vertical, `+1.9` for horizontal).

Switch with `--home-convention`, or with `h` in `color_grid_check.py`.

---

## Measured on the training captures

`python/captures/grid_training/` is gitignored, so these are recorded here
rather than in a test's expected output.

> These captures are of the **pre-6 cm sheet** (2.2 × 7.5 cm blocks, 0.5 cm
> gaps, 10 × 6 map). They no longer match `ColorGridSpec` and the tests skip
> them until a new sheet is printed and reshot. The rows below are the old
> record.

| capture | result |
| --- | --- |
| `original_image_VERTICAL.jpeg` (2048 × 1466) | 130 blobs, 111 on the lattice, **15 × 7 whole cells**, 10 × 6 grid fitted, mean residual **1.13 px** (max 5.59), colour parity **100 %** |
| `original_image_HORZONTIAL.jpeg` (1920 × 1061) | 133 blobs, 110 on the lattice, **22 × 5 whole cells** — refused: 5 whole cells along the 7.5 cm axis cannot hold 6 rows |

A first live frame from the rig (1296 × 972, corrected feed) found 89 blobs
with 53 on the lattice, spread over 11 × 6 — but with holes from a cable lying
diagonally across the sheet and from the frame clipping the outer columns, so
the largest unbroken block was only 6 × 3. The strict one-frame route refuses
that correctly. Evidence-Assisted Printed-Grid Calibration can use the whole
cells it sees across several gantry positions, but only if those frames expose
every outer edge and corner region; it still cannot invent a permanently hidden
workspace boundary.

The refusal is correct, not a limitation: that photo genuinely does not contain
six whole rows. The sheet is the same A2 print in both, just laid down the other
way, and only one of the two orientations has room for the grid. A live camera
looking straight down from 50 cm sees far more forgiving geometry than either.

---

## Using it

```bash
cd python

# prove the detection on a still, or live on the camera
../.venv/bin/python camera/color_grid_check.py --image captures/grid_training/original_image_VERTICAL.jpeg --mode vertical
../.venv/bin/python camera/color_grid_check.py --mode horizontal

# the two feeds: p overlays the sheet, k calibrates from it and saves
../.venv/bin/python camera/gridded_camera_feed.py --mode horizontal
../.venv/bin/python camera/rig_build_v1.py
```

`k` writes the same mode-keyed `config/workspace_map.json` the four-click route
writes. Recalibrating one layout preserves the other; loading a map through the
wrong mode is refused. Nothing downstream knows the sheet exists. In
`rig_build_v1.py` it is guarded exactly like `c`: refused during a build,
refused on a stale camera, and it clears the current selection.

The overlay tints every mapped cell and stamps its `col,row`; whole cells
outside the chosen window are outlined dull yellow and clipped ones red. Watch
the tint against the ink — a residual number cannot tell you *where* a fit went
wrong, and the tint can.

If the gantry hides an interior strip, use Evidence-Assisted Printed-Grid
Calibration in `gridded_camera_feed.py`: `e`, then Space for each useful safe
gantry position, then `k` only at **READY TO SAVE**. It keeps physical evidence
green and inferred-only interior cells amber/dashed; it never allows a virtual
outer boundary. The full procedure and gates are in
[evidence-assisted-printed-grid-calibration.md](evidence-assisted-printed-grid-calibration.md).

### Reading a bad result

**A refusal always still draws what it found** — the blobs that joined a
lattice in green, the ones that did not in red, with the count and the stage in
the corner. A blank window would make "the sheet is out of shot", "the colours
are wrong" and "the code never ran" look identical, which is precisely how the
first live attempt was reported as *no detection, no overlay, nothing*.

| what you see | what it means |
| --- | --- |
| `N whole cells along the 2.2 cm side where 7 are needed … Move the sheet or the camera` | genuinely not enough sheet in view. The named side says which way to move. |
| `… The sheet is big enough in view, so the gaps are holes` | enough cells, but something punched holes in them — a cable lying across the sheet, or an edge clipping a row. The strict route refuses; Evidence-Assisted calibration can cover an interior hole from other safe gantry positions. |
| `only N coloured blocks visible` | the sheet is not in frame, or the colours are being lost. Look at the drawn blobs: many blobs means a colour problem, almost none means a framing one. |
| `they do not form a regular lattice` | blobs found, but not in a grid. Usually something else in view is ink-coloured and the sheet is mostly out of shot. |
| red blobs all over the walls and rails | normal under a colour cast; the lattice discards them. Only a problem if they outnumber the sheet. |
| parity below 100 % | the lattice indices are inconsistent. Distrust the fit even if the residual looks fine. |
| tint drifting off the ink at one corner | residual lens distortion, or the sheet is not flat. |
| `normalized workspace corners must lie inside the image` | the envelope the sheet implies runs off the frame. The sheet is too close to an edge to calibrate from. |
