ahmedjk34/hardware-grad-project/report_src/figs/fig-wiring-mega.png

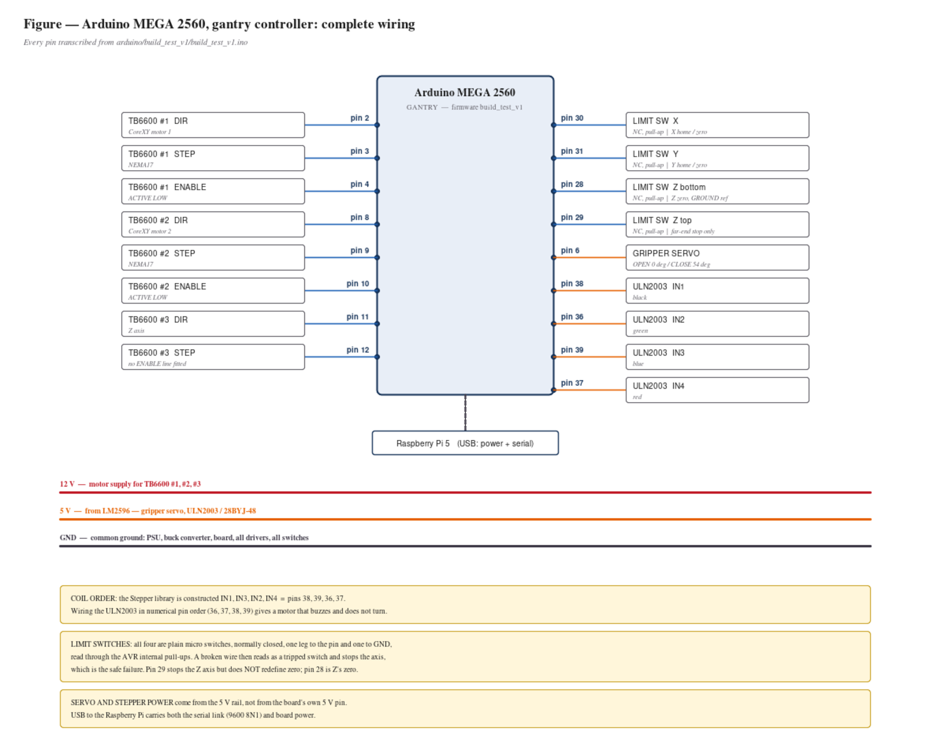
report_src/figs/fig-wiring-mega.png
