ahmedjk34/hardware-grad-project/docs/measurements/gate0_hand.csv

t | seq | stale | calibrated | mode | diff_fraction | detections | on_lattice | off_lattice | cell_churn | cells
0.536 | 3 | 0 | 1 | vertical |  | 0 | 0 | 0
0.647 | 7 | 0 | 1 | vertical | 0.000013 | 6 | 5 | 1 | 5 | 0:2 2:0 2:1 3:2 4:4
0.759 | 10 | 0 | 1 | vertical | 0.000013 | 6 | 5 | 1 | 0 | 0:2 2:0 2:1 3:2 4:4
0.874 | 13 | 0 | 1 | vertical | 0.000004 | 6 | 5 | 1 | 0 | 0:2 2:0 2:1 3:2 4:4
0.986 | 17 | 0 | 1 | vertical | 0.000004 | 6 | 5 | 1 | 0 | 0:2 2:0 2:1 3:2 4:4
1.099 | 20 | 0 | 1 | vertical | 0.008207 | 6 | 5 | 1 | 0 | 0:2 2:0 2:1 3:2 4:4
1.215 | 23 | 0 | 1 | vertical | 0.040487 | 6 | 5 | 1 | 0 | 0:2 2:0 2:1 3:2 4:4
1.327 | 27 | 0 | 1 | vertical | 0.063759 | 6 | 5 | 1 | 0 | 0:2 2:0 2:1 3:2 4:4
1.441 | 30 | 0 | 1 | vertical | 0.043422 | 6 | 5 | 1 | 0 | 0:2 2:0 2:1 3:2 4:4
1.552 | 34 | 0 | 1 | vertical | 0.041704 | 6 | 4 | 2 | 1 | 0:2 2:1 3:2 4:4
1.664 | 37 | 0 | 1 | vertical | 0.033150 | 4 | 4 | 0 | 0 | 0:2 2:1 3:2 4:4
1.776 | 40 | 0 | 1 | vertical | 0.020368 | 4 | 4 | 0 | 0 | 0:2 2:1 3:2 4:4
1.887 | 44 | 0 | 1 | vertical | 0.020021 | 4 | 4 | 0 | 0 | 0:2 2:1 3:2 4:4
1.999 | 47 | 0 | 1 | vertical | 0.027296 | 4 | 4 | 0 | 0 | 0:2 2:1 3:2 4:4
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
