ahmedjk34/hardware-grad-project/docs/measurements/gate0_parked.csv

t | seq | stale | calibrated | mode | diff_fraction | detections | on_lattice | off_lattice | cell_churn | cells
0.536 | 3 | 0 | 1 | vertical |  | 0 | 0 | 0
0.647 | 7 | 0 | 1 | vertical | 0.000022 | 6 | 5 | 1 | 5 | 0:2 2:0 2:1 3:2 4:4
0.759 | 10 | 0 | 1 | vertical | 0.000004 | 6 | 5 | 1 | 0 | 0:2 2:0 2:1 3:2 4:4
0.874 | 13 | 0 | 1 | vertical | 0.000009 | 6 | 5 | 1 | 0 | 0:2 2:0 2:1 3:2 4:4
0.985 | 17 | 0 | 1 | vertical | 0.000004 | 6 | 5 | 1 | 0 | 0:2 2:0 2:1 3:2 4:4
1.096 | 20 | 0 | 1 | vertical | 0.000000 | 6 | 5 | 1 | 0 | 0:2 2:0 2:1 3:2 4:4
1.208 | 23 | 0 | 1 | vertical | 0.000009 | 6 | 5 | 1 | 0 | 0:2 2:0 2:1 3:2 4:4
1.32 | 27 | 0 | 1 | vertical | 0.000009 | 6 | 4 | 2 | 1 | 0:2 2:1 3:2 4:4
1.433 | 30 | 0 | 1 | vertical | 0.000004 | 6 | 5 | 1 | 1 | 0:2 2:0 2:1 3:2 4:4
1.545 | 34 | 0 | 1 | vertical | 0.000004 | 6 | 5 | 1 | 0 | 0:2 2:0 2:1 3:2 4:4
1.656 | 37 | 0 | 1 | vertical | 0.000000 | 6 | 5 | 1 | 0 | 0:2 2:0 2:1 3:2 4:4
1.767 | 40 | 0 | 1 | vertical | 0.000000 | 6 | 5 | 1 | 0 | 0:2 2:0 2:1 3:2 4:4
1.878 | 44 | 0 | 1 | vertical | 0.000009 | 6 | 5 | 1 | 0 | 0:2 2:0 2:1 3:2 4:4
1.99 | 47 | 0 | 1 | vertical | 0.000004 | 6 | 5 | 1 | 0 | 0:2 2:0 2:1 3:2 4:4
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
