ahmedjk34/hardware-grad-project/docs/measurements/gate0_program.csv

t | seq | stale | calibrated | mode | diff_fraction | detections | on_lattice | off_lattice | cell_churn | cells
0.535 | 3 | 0 | 1 | vertical |  | 0 | 0 | 0
0.646 | 7 | 0 | 1 | vertical | 0.014274 | 1 | 0 | 1 | 0
0.757 | 10 | 0 | 1 | vertical | 0.013337 | 1 | 0 | 1 | 0
0.87 | 13 | 0 | 1 | vertical | 0.015633 | 1 | 0 | 1 | 0
0.981 | 17 | 0 | 1 | vertical | 0.016819 | 1 | 0 | 1 | 0
1.093 | 20 | 0 | 1 | vertical | 0.029428 | 1 | 0 | 1 | 0
1.206 | 23 | 0 | 1 | vertical | 0.048392 | 1 | 0 | 1 | 0
1.317 | 27 | 0 | 1 | vertical | 0.060446 | 1 | 0 | 1 | 0
1.428 | 30 | 0 | 1 | vertical | 0.042436 | 0 | 0 | 0 | 0
1.541 | 33 | 0 | 1 | vertical | 0.036019 | 0 | 0 | 0 | 0
1.652 | 37 | 0 | 1 | vertical | 0.049667 | 1 | 0 | 1 | 0
1.764 | 40 | 0 | 1 | vertical | 0.043542 | 1 | 0 | 1 | 0
1.875 | 44 | 0 | 1 | vertical | 0.040265 | 1 | 0 | 1 | 0
1.986 | 47 | 0 | 1 | vertical | 0.038835 | 1 | 0 | 1 | 0
2.098 | 50 | 0 | 1 | vertical | 0.042974 | 1 | 0 | 1 | 0
2.209 | 54 | 0 | 1 | vertical | 0.056484 | 1 | 0 | 1 | 0
2.321 | 57 | 0 | 1 | vertical | 0.044462 | 0 | 0 | 0 | 0
2.432 | 60 | 0 | 1 | vertical | 0.038937 | 0 | 0 | 0 | 0
2.543 | 64 | 0 | 1 | vertical | 0.061077 | 1 | 0 | 1 | 0
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
