ahmedjk34/hardware-grad-project/docs/measurements/gate0_split.csv

t | seq | stale | calibrated | mode | diff_fraction | detections | on_lattice | off_lattice | in_gap | margin | outside | cell_churn | cells | elsewhere
0.535 | 3 | 0 | 1 | vertical |  | 0 | 0 | 0 | 0 | 0 | 0
0.646 | 7 | 0 | 1 | vertical | 0.000573 | 5 | 5 | 0 | 0 | 0 | 0 | 5 | 0:2 2:0 2:1 3:2 4:4
0.758 | 10 | 0 | 1 | vertical | 0.002456 | 5 | 5 | 0 | 0 | 0 | 0 | 0 | 0:2 2:0 2:1 3:2 4:4
0.871 | 13 | 0 | 1 | vertical | 0.000004 | 5 | 5 | 0 | 0 | 0 | 0 | 0 | 0:2 2:0 2:1 3:2 4:4
0.983 | 17 | 0 | 1 | vertical | 0.000004 | 5 | 5 | 0 | 0 | 0 | 0 | 0 | 0:2 2:0 2:1 3:2 4:4
1.094 | 20 | 0 | 1 | vertical | 0.000004 | 5 | 5 | 0 | 0 | 0 | 0 | 0 | 0:2 2:0 2:1 3:2 4:4
1.209 | 23 | 0 | 1 | vertical | 0.000009 | 5 | 5 | 0 | 0 | 0 | 0 | 0 | 0:2 2:0 2:1 3:2 4:4
1.32 | 27 | 0 | 1 | vertical | 0.000004 | 5 | 5 | 0 | 0 | 0 | 0 | 0 | 0:2 2:0 2:1 3:2 4:4
1.441 | 30 | 0 | 1 | vertical | 0.000000 | 5 | 5 | 0 | 0 | 0 | 0 | 0 | 0:2 2:0 2:1 3:2 4:4
1.553 | 34 | 0 | 1 | vertical | 0.000000 | 5 | 5 | 0 | 0 | 0 | 0 | 0 | 0:2 2:0 2:1 3:2 4:4
1.667 | 37 | 0 | 1 | vertical | 0.000000 | 5 | 5 | 0 | 0 | 0 | 0 | 0 | 0:2 2:0 2:1 3:2 4:4
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
