ahmedjk34/hardware-grad-project/arduino/build_horizontal_grid/build_horizontal_grid.ino

/*
 * Standalone automatic level-0 build of every usable HORIZONTAL grid cell.
 * Flash only with the machine clear and supervised.
 * [0,0] is the feeder and is deliberately omitted.
 */
#include <stdio.h>

void handleLine(char *line);

/*
  ============================================================
  Dual TB6600 + Arduino MEGA 2560
  CNC-style step testing with limit switches, SOFTWARE limits,
  live position tracking, step counters, and GRID ADDRESSING

  Plus a THIRD, independent motor driving a Z axis (single motor,
  not coupled to the X/Y pair), a GRIPPER SERVO on pin 6 with just
  two positions (OPEN and CLOSE), and a FOURTH, independentB
  28BYJ-48 + ULN2003 stepper that only jogs +/-90 degrees on command.

  NEW IN build_tesT_v1:  the  B  (BUILD) command - one full
  pick-and-place cycle expressed in BLOCK LEVELS instead of steps.
  ============================================================C

  SERIAL COMMANDS
    1 = X-   (Motor 1 CW  / Motor 2 CW )   <-- SOFTWARE limit end
    2 = X+   (Motor 1 CCW / Motor 2 CCW)   <-- physical limit switch end
    3 = Y-   (Motor 1 CW  / Motor 2 CCW)   <-- physical limit switch end
    4 = Y+   (Motor 1 CCW / Motor 2 CW )   <-- SOFTWARE limit end
    5 = FULL MACHINE REPORT (position, counters, every statistic)
    6 = Reset ALL statistics to zero
    7 = Disable both motors (release holding torque)
    8 = ZERO the position counters (set "here" as origin 0,0)
    9 = Show ASCII grid map + current cell
    0 = HOME / GO TO ORIGIN (drive into both switches, X/Y only)
    0+ = FULL RESET: Z down to its bottom switch, Z up to its TOP
         switch, then home X/Y. Puts the rig in a known state.

    D = Z-   (Motor 3 CW )   <-- physical limit switch, pin 28 (GROUND)
    U = Z+   (Motor 3 CCW)   <-- physical limit switch, pin 29 (TOP)

    O = Servo OPEN   (pin 6)
    C = Servo CLOSE  (pin 6)

    R  = select the VERTICAL grid    (cols 0..6, rows 0..5, block 2.2 x 6.0)
    RR = select the HORIZONTAL grid  (cols 0..2, rows 0..9, block 6.0 x 2.2)
      Gaps are a uniform 1.6 cm on every axis of both grids. Horizontal is
      registered +1.9 cm on BOTH axes (pickup-cell registration). See SECTION 6C.
      These LATCH a grid layout. NEITHER MOVES ANYTHING. Each is refused
      when it is already true, and both need X/Y homed first. The claw's
      rotation is owned entirely by the build cycle.
      THE CLAW'S PHYSICAL ANGLE IS NOT SENSED. You are trusted to start
      with it neutral - 6.0 cm jaw axis along Y. If it is not, every
      placement this session is turned 90 degrees and nothing can tell.

    G <col> <row>   = go to grid cell. e.g.  G 3 5   or  G3,5
      EVERY coordinate is a real block footprint, 0 included, and BOTH axes
      always move. G 0 0 drives to the FEEDER cell centre.
      (This changed: 0 used to mean "leave that axis at the origin", so
      G 5 0 was an X-only move. It is now the cell [5,0].)
    S <cols> <rows> = change the HIGHEST INDEX live, for the ACTIVE grid
      only. The other mode keeps the size it was last given. This is the
      REQUESTED size; a live shiftX/shiftY may clip what is reachable.

    shiftX <cm> / shiftY <cm> = translate the WHOLE placement lattice of the
      ACTIVE grid by <cm>, measured from and including the [0,0] reference,
      in that axis. Decimal and sign allowed; + is away from the home switch.
      shiftX 0 / shiftY 0 clears it. Per mode, like the trims. The PICK-UP is
      NOT shifted - it is a plain home to [0,0], so a build still lifts the
      block off the un-shifted feeder and only the PLACEMENT rides the shift.
      [0,0] stays the feeder and is never built on. The reachable build range
      is recomputed: a shift that pushes the far block past the travel cap
      drops that column/row (shiftX/shiftY 0 restores it); a shift that leaves
      no cell on the machine is refused and reverted.

    B <col> <row> <level>   = BUILD one block   <<< NEW
      B 0 0 is a no-op: [0,0] is the FEEDER in both modes and is never
      built on. Every other cell, row 0 and column 0 included, is a real
      placement.
      There is NO rotation word. The active grid decides how the block is
      laid: vertical places it unrotated, horizontal turns it 90 CW.
    Z               = print the Z / build calibration table  <<< NEW
    ?               = reprint the help text

  Multi-character commands need a newline. Single digit commands
  work with or without one - including 0 and 0+, which are special
  cased in checkSerial() so the '+' has a chance to arrive. D, U, O, C, V, R and Z are letters, so like
  G/S/B/? they need a newline too. RR is two letters and ALSO needs
  a newline - there is no single-character fast path for it.

  ------------------------------------------------------------
  COORDINATE SYSTEM  (this is the important part)
  ------------------------------------------------------------
  SOFT_ZERO_ON_LIMIT_HIT is true, so each HOME switch zeros its own
  axis the moment it trips. The corner where BOTH X/Y switches are
  pressed is therefore machine position (0, 0) = the ORIGIN.

  Each axis travels AWAY from its own home switch. The two switches
  sit at OPPOSITE ends now, so the two axes no longer share a sign:

      X switch at the X+ end  ->  X runs   0  ...  -4550   (soft limit)
      Y switch at the Y- end  ->  Y runs   0  ...  +7600   (soft limit)
      Z switch at the Z- end  ->  Z runs   0  ...  +1350   (TOP SWITCH)

  The current software-safe envelope is 4550 x 7600 steps. The measured
  HOLDER displacement to those caps is 22.8 x 38.0 cm - 199.56 and 200.00
  steps/cm. The active rectangle is
  X in [-4550, 0], Y in [0, +7600]. Grid
  indices hide this sign mess:

      col 0  = nearest the X switch (X = 0 side, the X+ end)
      col N  = far end of X travel  (X = -4750 side)
      row 0  = nearest the Y switch (Y = 0 side)
      row M  = far end of Y travel  (Y = +8250 side)

  Coordinate 0 is a REAL BLOCK whose CENTRE sits on the home corner, so the
  last cell's centre lands exactly on the software cap and cell 0's block
  hangs half a block past the switches. [0,0] is the feeder. See SECTION 6C.

  Generalised in code as: each axis extends from 0 in the direction
  travelEndOf(axis), for axisTravelOf(axis) steps - whether that far
  end is held by a software cap (X/Y) or by a switch (Z). Change the
  step limits and the cm calibration set each axis's steps/cm scale.

  Z works the same way, except that BOTH of its ends are now real
  switches: Z = 0 is the bottom switch on pin 28 (the GROUND / table
  surface, claw all the way down) and the top of travel is the switch
  on pin 29 - roughly +Z_TRAVEL_STEPS, but the switch, not the number,
  is what actually stops the axis. SECTION 6E turns that step range
  into centimetres and then into BLOCK LEVELS.

  ------------------------------------------------------------
  Z+ IS A HARDWARE END STOP NOW  (it used to be a software limit)
  ------------------------------------------------------------
  The Z+ end used to be guarded by a counted software limit, which
  only worked while the step count was trustworthy. It is now a
  physical switch on PIN 29, wired and treated exactly like the X, Y
  and Z- switches, so:

    * Z has NO software limit at all - SECTION 6B disables it.
    * Z_TRAVEL_STEPS (SECTION 6E) survives as a CALIBRATION number:
      it converts steps to centimetres and sizes the homing cap. It
      no longer stops anything.
    * "Z to the top" is now a SEEK - drive up until the switch trips -
      instead of a move to a counted position. It therefore works even
      when Z has never been homed.
    * The rig MEASURES the real switch-to-switch distance whenever it
      runs up from a true zero, and prints it next to Z_TRAVEL_STEPS
      in the full report. If the two disagree, copy the measured
      number into SECTION 6E.

  ------------------------------------------------------------
  GO-TO SEQUENCE
  ------------------------------------------------------------
    1. Home Y into its switch, then home X into its switch  (= origin)
    2. Move Y to the target row
    3. Move X to the target column
  Re-homing every time means lost steps never accumulate.

  ------------------------------------------------------------
  BUILD SEQUENCE  (the B command)                        <<< NEW
  ------------------------------------------------------------
    1. Z up to the TOP SWITCH                    (clear of everything)
    2. X/Y home. That IS the feeder: the lattice is centre-anchored, so
       vertical [0,0]'s centre is the home corner. The feeder never
       rotates - it always presents a block standing, in both modes.
    3. Return the claw to neutral (including any manual A jog)
    4. Open the claw
    5. Z down to the FEEDER PICKUP HEIGHT (a fixed drop below the top
       switch - the belt sits above GROUND, so this is NOT a ground seek
       any more; see Z_PICKUP_DROP_FROM_TOP_CM)
    6. Close the claw                            (block is now held)
    7. Z up to the TOP SWITCH                    (carry height)
    8. X/Y to the requested cell
    9. Apply the active grid's placement rotation
   10. Z down to the requested BLOCK LEVEL
   11. Open the claw                             (block is placed)

  ...then it PARKS itself, so the rig never sits over the stack with
  an open claw and the next B starts from a known state:

   12. Z up to the TOP SWITCH                    (clear of the block)
   13. X/Y home to the origin
   14. Rotate the claw back to neutral           (if this build turned it)

  Phases 12-14 are skipped if BUILD_PARK_AFTER_PLACE is false. A
  failure in them is a WARNING, not a failed build - the block is
  already down by then.

  ------------------------------------------------------------
  A NOTE ON F("...")  -  DO NOT DROP IT
  ------------------------------------------------------------
  The MEGA has 8 KB of SRAM, and on AVR every plain string literal
  handed to Serial.print() is COPIED INTO SRAM at boot. This sketch
  prints a lot of text, and written the naive way it needed 9443
  bytes of SRAM - 115% of the chip. It would not have run.

  Wrapping the literals in F() keeps them in flash and streams them
  out instead, which costs nothing but a little program space:

        SRAM   9443 bytes (115%)   ->   2099 bytes (26%)
        flash 39158 bytes  (15%)   ->  40590 bytes (15%)

  So: any new Serial.print of a fixed string MUST B be F("..."), e.g.
        Serial.println(F("--- MY NEW SECTION ---"));
  Variables print normally - F() is only for literals.

  ============================================================
*/

#include <Servo.h>
#include <Stepper.h>

// ============================================================
// SECTION 1 - MOTOR PIN CONFIGURATION
// ============================================================

// IMPORTANT: BOTH X/Y drivers now go CW on ACTIVE HIGH. The pins 2/3
// driver (DIR_PIN1/STEP_PIN1) always did, because its coil wiring was
// physically reversed; the pins 8/9 driver ended up the same after the
// machine was rewired. Do not "fix" either polarity in software without
// re-checking the physical wiring first - see SECTION 3.
const int DIR_PIN1 = 2;
const int STEP_PIN1 = 3;
const int EN_PIN1 = 4;

const int DIR_PIN2 = 8;
const int STEP_PIN2 = 9;
const int EN_PIN2 = 10;

// Z axis - single independent motor, not coupled to X/Y.
// No enable pin was specified for this driver, so it is left
// permanently enabled (only DIR/STEP are driven).
const int DIR_PIN3 = 11;
const int STEP_PIN3 = 12;

// Level that ENABLES the TB6600 in the current wiring.
const bool EN_ACTIVE_LEVEL = LOW;
const bool EN_INACTIVE_LEVEL = HIGH;

// ============================================================
// SECTION 1B - GRIPPER SERVO CONFIGURATION
// ============================================================
//
// A single hobby servo, two positions only: OPEN [O] and CLOSE [C].

const int SERVO_PIN = 6;

// The feeder is calibrated for a tighter opening when both X/Y home switches
// are physically active. The home-switch check is made at the instant
// O/openServo() runs.
// Build gripper calibration. The OPEN angle is split by "are both X/Y home
// switches active?" (checked when openServo() runs): at the feeder home ->
// SERVO_HOME_OPEN_ANGLE (107); anywhere else, i.e. the release at the target
// cell (build phase 11) -> SERVO_OPEN_ANGLE (95). Close is one angle, 180.
const int SERVO_HOME_OPEN_ANGLE = 107;
const int SERVO_OPEN_ANGLE = 95;
const int SERVO_CLOSE_ANGLE = 180;

// The servo is commanded and then forgotten - nothing reports back
// when it has actually arrived. The build sequence must not start
// moving Z while the jaws are still swinging, so every open/close
// inside a build waits this long afterwards.
unsigned int SERVO_SETTLE_MS = 600;

Servo gripperServo;

// True = last commanded position was OPEN. Set to a known state in
// setup() so this always reflects reality, not just "assumed".
bool servoIsOpen = false;

// ============================================================
// SECTION 1C - AUXILIARY STEPPER CONFIGURATION (28BYJ-48 + ULN2003)
// ============================================================
//
// A fourth, independent motor - not part of the X/Y/Z rig. `A <degrees>`
// gives it a signed RELATIVE jog; positive is CW and negative is CCW. There
// is no home switch or mechanical angle reading, so this is never an absolute
// physical angle. R/RR are grid latches, not aux-stepper commands.
//
// ULN2003 connections:
//   IN1 / BLACK -> pin 38
//   IN2 / GREEN -> pin 36
//   IN3 / BLUE  -> pin 39
//   IN4 / RED   -> pin 37
// Power the ULN2003 from a 5V external supply with a shared GND

const int AUX_STEPPER_IN1 = 38;
const int AUX_STEPPER_IN2 = 36;
const int AUX_STEPPER_IN3 = 39;
const int AUX_STEPPER_IN4 = 37;

// Approximate number of steps for one output-shaft revolution.
const int AUX_STEPPER_STEPS_PER_REV = 2048;

// A quarter turn, used by the build's neutral/CW/CCW placement states.
const int AUX_STEPPER_QUARTER_TURN = AUX_STEPPER_STEPS_PER_REV / 4;

// One manual command is deliberately capped at one turn. The aux mechanism
// has no limit switch, so a larger move must be consciously split into
// separate commands rather than silently winding cables or hardware forever.
const int AUX_STEPPER_MAX_MANUAL_DEGREES = 360;

const int AUX_STEPPER_SPEED_RPM = 10;

// IMPORTANT: the correct Stepper library pin order for most
// 28BYJ-48 + ULN2003 boards is IN1, IN3, IN2, IN4 (not IN1..IN4).
Stepper auxStepper(
    AUX_STEPPER_STEPS_PER_REV,
    AUX_STEPPER_IN1,
    AUX_STEPPER_IN3,
    AUX_STEPPER_IN2,
    AUX_STEPPER_IN4);

// Net position in steps, relative to power-on. Purely informational -
// this motor has no limits or homing to keep it honest.
long auxStepperPos = 0;

// Current angular position reduced to one revolution around the assumed
// power-on neutral. Unlike auxStepperPos, a full 360-degree manual jog lands
// back at zero here. Build rotation uses this so it need not undo a pointless
// whole turn before a pick.
long auxAngleSteps = 0;

// ============================================================
// SECTION 2 - MOTION TUNING
// ============================================================

// ------------------------------------------------------------
//   X/Y AND Z ARE TUNED SEPARATELY
// ------------------------------------------------------------
//   The Z axis is a single motor lifting against gravity - and, once
//   a block is gripped, against a load. The pulse rate that suits the
//   X/Y gantry is rarely the one that suits the lift, so Z has its
//   own pulse delay and its own jog size. Change either without
//   touching how the gantry behaves.
//
//   Every Z move goes through these: manual D/U jogs, homing, and
//   the build sequence.

// Half-period of the step pulse, in microseconds. One full step is
// two of these, so 2000 us => 4.000 ms per step => ~250 steps/sec.
// RAISE the Z value to slow Z down (more torque, less chance of
// losing steps under load); LOWER it to speed the lift up.
unsigned int STEP_DELAY = 575; // X and Y, 2000 us per half-period

unsigned int STEP_DELAY_Z = 950; // Z only

// How many steps a single MANUAL jog moves.
//   stepsPerMove  -> the 1-4 commands (X/Y)
//   stepsPerMoveZ -> the D/U commands (Z)
// Z is worth setting finer: 150 steps is only ~2.9 cm of X/Y travel
// but is nearly a fifth of the whole Z range.
int stepsPerMove = 150; // X and Y

int stepsPerMoveZ = 150; // Z only

// Settle time after changing a DIR pin before the first step pulse.
const unsigned int DIR_SETTLE_MS = 5;

// ============================================================
// SECTION 3 - MOTOR DIRECTION POLARITY
// ============================================================

const bool MOTOR1_CW = HIGH;
const bool MOTOR1_CCW = LOW;

// Motor 2 now turns CW on HIGH, same as motor 1 - its direction sense
// inverted when the machine was rewired. These two values were swapped
// to match what the shafts were observed to do. The pin levels each
// command sends did NOT change, only the names for them, so motion is
// identical to before the swap.
const bool MOTOR2_CW = HIGH;
const bool MOTOR2_CCW = LOW;

// CW = -Z, CCW = +Z (per spec). Flip these two if the physical
// direction ends up reversed once wired up.
const bool MOTOR3_CW = LOW;
const bool MOTOR3_CCW = HIGH;

// ============================================================
// SECTION 4 - AXIS DEFINITIONS
// ============================================================

const uint8_t AXIS_X = 0;
const uint8_t AXIS_Y = 1;
const uint8_t AXIS_Z = 2;
const uint8_t AXIS_COUNT = 3;

const int8_t DIR_NEG = -1;
const int8_t DIR_POS = +1;

// ============================================================
// SECTION 5 - MOVEMENT TABLE  (command -> direction mapping)
// ============================================================

struct MoveDef
{
  const char *label;
  bool dir1; // DIR_PIN1 level (X/Y moves only)
  bool dir2; // DIR_PIN2 level (X/Y moves only)
  bool dir3; // DIR_PIN3 level (Z moves only)
  uint8_t axis;
  int8_t sign;
};

const uint8_t MOVE_COUNT = 6;

// X/Y entries pulse STEP_PIN1+STEP_PIN2 together (coupled drive).
// Z entries pulse STEP_PIN3 alone. See moveSteps().
//
// VERIFIED ON THE MACHINE after the rig was physically re-oriented and
// motor 2 was rewired. Confirmed by watching the shafts turn:
//     M1 CW  + M2 CW   ->  X-   (short axis, toward the X SOFT limit)
//     M1 CCW + M2 CCW  ->  X+   (toward the X switch, pin 30)
//     M1 CW  + M2 CCW  ->  Y-   (long axis, toward the Y switch, pin 31)
//     M1 CCW + M2 CW   ->  Y+   (toward the Y SOFT limit)
// Motors turning the SAME sense walk X; opposed senses walk Y. The axis
// names, travel caps, switch pins and grid all kept their original
// meaning. Re-verify against the hardware before changing this.
const MoveDef MOVES[MOVE_COUNT] = {
    {"X-", MOTOR1_CW, MOTOR2_CW, false, AXIS_X, DIR_NEG},
    {"X+", MOTOR1_CCW, MOTOR2_CCW, false, AXIS_X, DIR_POS},
    {"Y-", MOTOR1_CW, MOTOR2_CCW, false, AXIS_Y, DIR_NEG},
    {"Y+", MOTOR1_CCW, MOTOR2_CW, false, AXIS_Y, DIR_POS},
    {"Z-", false, false, MOTOR3_CW, AXIS_Z, DIR_NEG},
    {"Z+", false, false, MOTOR3_CCW, AXIS_Z, DIR_POS}};

// ============================================================
// SECTION 6 - PHYSICAL LIMIT SWITCH CONFIGURATION
// ============================================================
//
// Every switch on the machine lives in ONE table. A switch is
// described by WHICH END OF WHICH AXIS it guards, not by its axis
// alone - which is exactly what lets Z carry two of them:
//
//     X    one switch  at the X+ end          pin 30
//     Y    one switch  at the Y- end          pin 31
//     Z    TWO switches:
//              Z-  bottom / GROUND            pin 28
//              Z+  top of travel              pin 29   <<< was software
//
// The Z+ switch REPLACED the Z+ software limit. Nothing about it is
// special-cased: it is read, debounced, counted and obeyed by the
// same code as every other end stop.
//
// ------------------------------------------------------------
//   isHome  -  which switch is an axis' ZERO?
// ------------------------------------------------------------
//   An axis needs exactly one switch that means "you are at position
//   0". That is the one homing drives into, and the one that re-zeros
//   the counter under SOFT_ZERO_ON_LIMIT_HIT.
//
//   Z- is Z's home switch because it is the GROUND reference the
//   block levels are measured from. Z+ is a FAR-END switch: it stops
//   the axis and reports where the top is, but it does not redefine
//   zero. See applyLimitReference().

const int LIMIT_PIN_X = 30;     // X AXIS limit switch
const int LIMIT_PIN_Y = 31;     // Y AXIS limit switch
const int LIMIT_PIN_Z_BOT = 28; // Z AXIS bottom (GROUND) limit switch
const int LIMIT_PIN_Z_TOP = 29; // Z AXIS top limit switch   <<< NEW

struct LimitSwitch
{
  uint8_t axis;
  int8_t end; // DIR_NEG / DIR_POS - which end of the axis it guards
  uint8_t pin;
  bool useNC;   // true = normally-closed wiring
  bool enabled; // false = ignore this switch completely
  bool isHome;  // true = tripping it means "this axis is at 0"
};

const uint8_t LIMIT_COUNT = 4;

// The order here is the order every report prints them in.
const LimitSwitch LIMITS[LIMIT_COUNT] = {
    {AXIS_X, DIR_POS, LIMIT_PIN_X, true, true, true},
    {AXIS_Y, DIR_NEG, LIMIT_PIN_Y, true, true, true},
    {AXIS_Z, DIR_NEG, LIMIT_PIN_Z_BOT, true, true, true},
    {AXIS_Z, DIR_POS, LIMIT_PIN_Z_TOP, true, true, false}};

// ------------------------------------------------------------
//   WHAT THE Z+ SWITCH DOES TO THE POSITION COUNTER
// ------------------------------------------------------------
//   When Z runs up into the top switch it can either KEEP the step
//   count it just made, or ADOPT Z_TRAVEL_STEPS as its position.
//
//   Keeping the count (false, the default) is more accurate whenever
//   Z already has a true zero from the bottom switch: the count came
//   from the real hardware this run, while Z_TRAVEL_STEPS is a
//   hand-entered constant that may be slightly stale. A build always
//   re-zeros at the bottom before it places anything, so the count is
//   never left to drift for long.
//
//   Set true only if you would rather trust the constant - e.g. if
//   the lift skips steps often enough that the count is the less
//   reliable of the two.
//
//   NOTE: when Z has NO zero at all (never homed), the top switch
//   always adopts Z_TRAVEL_STEPS regardless of this setting - a
//   rough reference beats no reference.
const bool Z_TOP_REFERENCES_POSITION = false;

const unsigned int LIMIT_CONFIRM_US = 200;
const uint8_t LIMIT_CHECK_EVERY_N_STEPS = 1;

// ============================================================
// SECTION 6B - SOFTWARE LIMIT CONFIGURATION
// ============================================================
//
// These numbers define the software-safe size of the grid envelope.
//
// ------------------------------------------------------------
//   Z IS NOT HERE ANY MORE
// ------------------------------------------------------------
//   Z used to be capped by a counted software limit at the Z+ end.
//   That end is now the physical switch on pin 29 (SECTION 6), so the
//   Z software limit is DISABLED and there is no Z travel cap to set.
//
//   The step count that used to live here as SOFT_LIMIT_Z_TRAVEL has
//   moved to SECTION 6E as Z_TRAVEL_STEPS, where it is a CALIBRATION
//   number - it converts steps into centimetres and sizes the Z
//   homing cap. It does not stop the axis; the switch does.
//
//   A soft limit only ever guards the end an axis travels TOWARD,
//   which is always the end away from its home switch. So for every
//   axis, SOFT_LIMIT_*_AT_END == travelEndOf(axis) by construction.

const long SOFT_LIMIT_INFINITE = 0; // sentinel: no cap at all

long SOFT_LIMIT_X_TRAVEL = 4550;                      // X- travel cap, in steps
long SOFT_LIMIT_Y_TRAVEL = 7600;                      // Y+ travel cap, in steps
const long SOFT_LIMIT_Z_TRAVEL = SOFT_LIMIT_INFINITE; // Z: switch, not a cap

// Measured HOLDER displacement from each home switch to the active software
// cap. These are displacements between two holder reference positions, not
// dimensions of the arm or block. The arm-holder offset is intentionally zero
// for now, so it does not participate in either scale.
//
//   X scale = 4750 / 24.3 = 195.4733 steps/cm
//   Y scale = 8250 / 40.0 = 206.2500 steps/cm
float X_TRAVEL_CM = 22.8;
float Y_TRAVEL_CM = 38.0;

const int8_t SOFT_LIMIT_X_AT_END = DIR_NEG; // guards the X- end
const int8_t SOFT_LIMIT_Y_AT_END = DIR_POS; // guards the Y+ end
const int8_t SOFT_LIMIT_Z_AT_END = DIR_POS; // (unused - Z has no cap)

const bool SOFT_LIMIT_X_ENABLED = true;
const bool SOFT_LIMIT_Y_ENABLED = true;
const bool SOFT_LIMIT_Z_ENABLED = false; // pin 29 replaced it

// Re-zero an axis automatically the moment its HOME switch trips.
// REQUIRED for the grid AND for the build levels to mean anything -
// leave this true. Far-end switches (Z+) never re-zero; see
// applyLimitReference().
const bool SOFT_ZERO_ON_LIMIT_HIT = true;

const bool SOFT_LIMIT_VERBOSE = true;

// ============================================================
// SECTION 6C - GRID CONFIGURATION
// ============================================================
//
// TWO GRIDS, BOTH REAL.  A block measures 2.2 x 6.0 cm in plan, and it can be
// laid either way round.  Which way round it is laid decides how many cells
// fit, where they sit, and how far the grid has to be trimmed - so it is not
// one grid with a flag, it is two grids, each with its own complete geometry:
//
//   VERTICAL   (mode 0)  block 2.2 X x 6.0 Y      6 cols x  5 rows
//   HORIZONTAL (mode 1)  block 6.0 X x 2.2 Y      2 cols x  9 rows
//
// ------------------------------------------------------------
//   COORDINATE 0 IS A REAL BLOCK, AND ITS CENTRE IS HOME
// ------------------------------------------------------------
// It used to be the home POINT, with only a gap before cell 1, and the whole
// allocation was then CENTRED in the holder travel. Both of those are gone.
// The lattice is a plain run of centres anchored on the home corner:
//
//       centre(i) = trim + i * pitch          pitch = block + gap
//
// so the LAST centre lands exactly on the software cap, and cell 0's block
// hangs half a block past the home switches:
//
//   vertical    X: 7 cells (0..6)  centres 0 .. 22.8   pitch 3.8
//               Y: 6 cells (0..5)  centres 0 .. 38.0   pitch 7.6
//   horizontal  X: 3 cells (0..2)  centres 1.9 .. 17.1  pitch 7.6
//               Y: 10 cells (0..9) centres 1.9 .. 36.1  pitch 3.8
//
// GRID_COLS / GRID_ROWS hold the HIGHEST INDEX, not a count, which is why they
// read 6/5 and 2/9 - there are 7/6 and 3/10 addressable cells.
//
// Vertical fills its travel exactly on both axes: 6 * 3.8 = 22.8 and
// 5 * 7.6 = 38.0. That is not a coincidence to be tuned away - it is what
// "the build area IS the travel area" means, and it is why vertical X has
// seven columns rather than six.
//
// ------------------------------------------------------------
//   THE GAPS ARE UNIFORM - 1.6 cm, EVERY AXIS, BOTH MODES
// ------------------------------------------------------------
// A vertical block reads 2.2 + 1.6 + 2.2 along its 6.0 cm length, and
// consecutive blocks are also 1.6 cm apart, so the 2.2 cm sub-cells repeat at
// one unbroken 3.8 cm pitch. Measured off the printed sheet: tiles 6.00 cm,
// gaps 1.56 cm, identical on both axes.
//
// An earlier revision had a 0.8 cm block gap, which made the horizontal Y
// lattice alternate 0.8 / 1.6. That alternation was an artefact of the wrong
// gap, not a real feature of the paper. Do not reintroduce it without
// re-measuring the sheet.
//
// ------------------------------------------------------------
//   [0,0] IS THE FEEDER, IN BOTH MODES, AND IS NEVER BUILT ON
// ------------------------------------------------------------
// The feeder never rotates: a block is always presented standing, on the
// VERTICAL [0,0] footprint, whichever mode is latched. Because the lattice is
// centre-anchored, that cell's centre IS the home corner - so a pick-up is a
// plain home with no move afterwards, and the claw, which closes on the middle
// of the block, closes on its centre.
//
// That kills exactly one cell per mode and no more. Every other row-0 /
// column-0 cell is a real placement, so B 0 0 stays the inert no-op it always
// was, while B 0 3 and B 4 0 are ordinary builds rather than the old "move one
// axis only" sentinel.
//
// ------------------------------------------------------------
//   HOW THE TWO GRIDS RELATE
// ------------------------------------------------------------
//   X  a horizontal column covers two vertical columns plus the gap between
//      them: block 6.0 = 2.2 + 1.6 + 2.2, pitch 7.6 = 2 * 3.8.
//   Y  a vertical row is 6.0 cm; a horizontal block laid on it is 2.2 cm.
//   Both axes carry the SAME +1.9 cm registration (GRID_TRIM_{X,Y}_CM): the
//   block is picked up standing at the vertical [0,0] feeder, centred on home,
//   then rotated 90 degrees about the grip. The rotated 6.0 cm face overhangs
//   the 2.2 cm vertical footprint by 6.0/2 - 2.2/2 = 1.9 cm per side, so a
//   +1.9 cm trim on each axis seats horizontal [0,0] flush against the
//   vertical [0,0] block edge (near edge in X, far edge in Y).
//
// Nothing here swaps an X extent for a Y one; see D12 in
// docs/dual-orientation-grid.md.
//
// THE PRINTED SHEET is registered the same way: lay it so the CENTRE of its
// [0,0] block sits on the holder home point, and printed [c,r] is firmware
// [c,r]. Half of that block hangs back past the switches - that is expected.
//
// PHYSICAL RR REGISTRATION (both axes, positive away from the home switch):
//
//    home
//      0        1.9        3.8                 7.6        (cm, either axis)
//      |         |          |                   |
//   [--- vertical [0,0], 6.0 cm centred on 0 ---]        (along its long axis)
//   |<--2.2-->|<---1.6--->|<---2.2--->| ...
//      ^         ^
//      |         h [0,0] centre = 1.9   (the +1.9 GRID_TRIM_{X,Y}_CM)
//      v vertical [0,0] centre = 0 = the feeder / pick-up point
//
// So RR only latches the mode; the next B picks the block up standing at home,
// moves +1.9 cm along BOTH X and Y, rotates 90 degrees CW, then places.
// B 0 0 remains a no-op in both modes.
//
// Targets are computed as absolute physical cell centres and rounded only
// once, so sub-step rounding error never accumulates between cells.
//
// ------------------------------------------------------------
//   WHICH MODE IS THE BOARD IN?
// ------------------------------------------------------------
//   VERTICAL, at every power-on and after every reset.  There is no EEPROM
//   and opening the USB port resets the board, so vertical is simply what the
//   machine is unless something has said otherwise since.  RR latches to
//   horizontal, R latches back; see the mode latch further down.
//
//   NOTHING SENSES THE CLAW'S PHYSICAL ANGLE.  The operator is trusted to
//   start with the claw physically neutral (its 6.0 cm jaw axis along Y).
//   If it is not, every placement in this session is turned 90 degrees and no
//   amount of software can tell.
//
// ------------------------------------------------------------
//   HOW MANY CELLS FIT?
// ------------------------------------------------------------
//   Counts are limited by block-plus-gap pitch, by reachable HOLDER centres,
//   and by each mode's block-edge overhang budget (below).  Command S can
//   choose a smaller centred grid for the ACTIVE mode but cannot squeeze
//   cells or change their footprint.

const uint8_t GRID_MODE_VERTICAL = 0;   // block standing: 6.0 cm along Y
const uint8_t GRID_MODE_HORIZONTAL = 1; // block lying:    6.0 cm along X
const uint8_t GRID_MODE_COUNT = 2;

// The live mode. Compiled default is vertical and every reset returns here.
uint8_t gridMode = GRID_MODE_VERTICAL;

//                                          { vertical, horizontal }
float GRID_BLOCK_X_CM[GRID_MODE_COUNT] = {2.2, 6.0};
float GRID_BLOCK_Y_CM[GRID_MODE_COUNT] = {6.0, 2.2};
float GRID_GAP_X_CM[GRID_MODE_COUNT] = {1.6, 1.6};
float GRID_GAP_Y_CM[GRID_MODE_COUNT] = {1.6, 1.6};

// ------------------------------------------------------------
//   THE FOUR OFFSET FAMILIES, AND WHAT EACH ONE IS FOR
// ------------------------------------------------------------
//   These used to overlap - the horizontal registration was split between a
//   TRIM and a TOOL OFFSET, so tuning either one moved the grid twice. Each
//   name now has exactly one job:
//
//     GRID_BLOCK_* / GRID_GAP_*   the physical lattice. Stated per mode.
//     GRID_TRIM_*                 moves the WHOLE grid against the home
//                                 switches. Vertical is 0.0 on both axes;
//                                 horizontal carries its pickup-cell
//                                 registration here - see below.
//     GRID_ERROR_OFFSET_*         the calibration knob. A CONSTANT per-mode
//                                 nudge; it cannot fix an error that grows
//                                 with distance (that is a steps/cm or pitch
//                                 problem). Start at 0.
//     TOOL_OFFSET_*               purely mechanical: how far the claw's grip
//                                 centre sits from the holder centre in each
//                                 rotation. Nothing to do with the grid.
//
//   THE HORIZONTAL REGISTRATION LIVES IN GRID_TRIM_{X,Y}_CM, +1.9 cm on BOTH
//   axes. The rotated 6.0 cm face overhangs the 2.2 cm vertical footprint by
//   6.0/2 - 2.2/2 = 1.9 cm per side, and trimming +1.9 on each axis seats
//   horizontal [0,0] flush against the vertical [0,0] block edge (near edge in
//   X, far edge in Y). It is applied exactly once, through cellCentreCmOf();
//   nothing adds it structurally.
//
//   TWO CAVEATS, because this constant has been derived two different ways.
//   (a) This block used to say "half the vertical pitch (3.8 / 2)". That
//       agrees numerically only because 3.8 happens to equal 6.0 - 2.2; it is
//       an accident of these dimensions, not a second proof. The overhang
//       derivation above is the real one.
//   (b) The overhang is an EXTENT, and +1.9 is a TRANSLATION. A 90-degree turn
//       about the grip moves the block's centre by zero however far its face
//       overhangs, so the rotation does not by itself justify any trim. What
//       justifies +1.9 is the LAYOUT CHOICE on the line above: horizontal
//       [0,0] is defined edge-flush with vertical [0,0] rather than
//       centre-coincident. The rotation's real, non-zero contribution is the
//       grip-to-rotation-axis swing, and that lives in TOOL_OFFSET_CW_*.

// Signed whole-allocation shift, per mode. Not copied between modes. Vertical
// is anchored on the home corner (0.0 / 0.0); horizontal carries the +1.9 cm
// pickup-cell registration on both axes (see the block above).
float GRID_TRIM_X_CM[GRID_MODE_COUNT] = {0.0, 1.9};
float GRID_TRIM_Y_CM[GRID_MODE_COUNT] = {0.0, 1.9};

// AI AGENT NOTE: For any user-marked "error" offsetting, use these variables.
// They apply exactly like GRID_TRIM_* and shift every grid centre from home.
// Keep these paired with config/rig.json and start new error calibration at 0.
//
// VERTICAL stays 0.0 / 0.0 - the grid was re-anchored on the printed sheet and
// the old 0.15 / 0.05 were measured against the previous CENTRED allocation.
//
// HORIZONTAL IS NOW 0.0 / 0.0 TOO, AND USED NOT TO BE.  It carried +0.5 cm X
// and +0.3 cm Y to absorb the placement error of the 90-degree pickup-rotate.
// That was the wrong knob, and the wrong knob hid a sign error:
//
//   The claw does close on the block's middle.  But that middle does not sit
//   on the AUX STEPPER'S ROTATION AXIS - it is offset by roughly
//   (-0.3, +0.6) cm - so a 90-degree CW turn swings the block centre AROUND
//   that axis instead of spinning it in place.  The swing is a constant
//   X +0.9 (AWAY from home) and Y -0.3 (toward home).  Y's shipped +0.3
//   happened to cancel its half.  X's shipped +0.5 pushed the SAME WAY as the
//   swing, so the two added and placed blocks landed 1.4 cm too far from the
//   X home switch.  The comment that used to sit here said blocks were
//   "landing toward home on each axis": true of Y, backwards for X.
//
// The swing depends on WHICH WAY the claw turns, so the correction belongs in
// TOOL_OFFSET_CW_* - which has a slot per rotation - and not here, which is
// one rotation-blind number per mode and so could not follow when the build
// rotation settled on CW.  See the TOOL_OFFSET_* block below.
//
// Moving it there also returns the LATTICE to trim-only (horizontal X centres
// 1.9 / 9.5 / 17.1), which is where blocks physically land and therefore what
// MachineGrid, the camera overlay and the Studio should draw.  An error offset
// moves cell centres; a tool offset moves only the holder.
float GRID_ERROR_OFFSET_X_CM[GRID_MODE_COUNT] = {0.0, 0.0};
float GRID_ERROR_OFFSET_Y_CM[GRID_MODE_COUNT] = {0.0, 0.0};

// The live GRID SHIFT, per mode. Set by the shiftX / shiftY serial commands,
// cleared to 0 by shiftX 0 / shiftY 0 and by every board reset. It is folded
// into gridTrimCmOf() and so rides through every lattice consumer EXACTLY like
// a trim - cellCentreCmOf(), gridGeometryFits(), gridCountMaxOf(),
// cellTargetPosition(), positionToIndex() - which is what makes the whole grid,
// [0,0] reference included, translate by <cm>.
//
// It is deliberately NOT the same knob as GRID_ERROR_OFFSET_*: that one is a
// calibration nudge that starts at 0 and stays paired with config/rig.json's
// error_offset_*; this one is an operator-driven registration shift the Pi
// pushes from config/rig.json's shift_x_cm / shift_y_cm after the mode latch
// and before S. Keep them separate so a shift never masquerades as calibration.
//
// THE PICK-UP DOES NOT SEE THIS. A build picks up with a plain home to raw
// [0,0] (goToFeeder -> goToOrigin), which touches no lattice math, so the shift
// only ever moves the PLACEMENT. See SECTION 6C header and applyGridShift().
float GRID_SHIFT_X_CM[GRID_MODE_COUNT] = {0.0, 0.0};
float GRID_SHIFT_Y_CM[GRID_MODE_COUNT] = {0.0, 0.0};

// How far past the travel limit this mode lets a placed block's own EDGE sit.
// This is NOT a trim: it moves nothing. It is the budget gridGeometryFits()
// measures the block edges against, and it exists because a centre-only check
// happily accepts a grid whose far block hangs off the machine.
//
// Vertical gets half a block on each axis (block_x/2 = 1.1, block_y/2 = 3.0),
// the overhang a full-travel grid would produce and a safe ceiling for the
// centred grid it ships as.  Horizontal gets zero, because any overhang there
// means the trims are wrong.
// Keep paired with config/rig.json -> grid.modes.*.max_edge_overhang_*_cm.
float GRID_MAX_EDGE_OVERHANG_X_CM[GRID_MODE_COUNT] = {1.1, 3.0};
float GRID_MAX_EDGE_OVERHANG_Y_CM[GRID_MODE_COUNT] = {3.0, 1.1};

// THE HIGHEST VALID INDEX, not a count: vertical addresses columns 0..6 and
// rows 0..5, horizontal columns 0..2 and rows 0..9. gridSlotsOf() adds the
// one. Per mode, so that S applies to the grid the operator is looking at and
// the other mode keeps whatever size it was given.
//
// This is the REQUESTED highest index. A non-zero GRID_SHIFT_* can push the
// far block past the travel cap; gridColsNow() / gridRowsNow() then report the
// clipped, actually-reachable highest index while these keep the request, so
// clearing the shift (shiftX/shiftY 0) restores the full grid with no re-S.
long GRID_COLS[GRID_MODE_COUNT] = {6, 2};
long GRID_ROWS[GRID_MODE_COUNT] = {5, 9};

// Read these rather than indexing the tables. Everything downstream of here
// is written against the ACTIVE mode and never mentions the other one.
//
// The returned value is min(requested, highest index that still fits under the
// live GRID_SHIFT_*). With no shift it is just GRID_COLS/GRID_ROWS[gridMode].
// It can be -1 if a shift leaves not even cell 0 on the machine, which makes
// gridReady() fail loudly rather than silently accepting a broken grid;
// applyGridShift() refuses such a shift up front so this is only transient.
long gridColsNow()
{
  long requested = GRID_COLS[gridMode];
  long fits = gridCountMaxOf(AXIS_X);
  return (fits < requested) ? fits : requested;
}

long gridRowsNow()
{
  long requested = GRID_ROWS[gridMode];
  long fits = gridCountMaxOf(AXIS_Y);
  return (fits < requested) ? fits : requested;
}

const char *gridModeName(uint8_t mode)
{
  return (mode == GRID_MODE_HORIZONTAL) ? "horizontal" : "vertical";
}

// The X/Y counters describe the GANTRY HOLDER, not necessarily the point where
// the claw places a block.  These vectors describe HOLDER -> block centre in
// physical centimetres.  Positive means farther from that axis' home switch.
//
// A cell names the desired block centre.  The firmware subtracts the selected
// vector before moving the holder, so the claw lands on the cell centre:
//
//     holder target = desired block centre - tool offset
//
// Keep these paired with config/rig.json -> tool_offsets.  CW/CCW apply after
// the requested 90-degree claw rotation, which can move an asymmetric tool
// centre.
//
// NEUTRAL IS GENUINELY ZERO: the claw closes on the middle of the block and
// places it without turning, so holder and block centre coincide.
//
// CW CARRIES THE PICKUP-ROTATE SWING, and it is the only rotation a build can
// ask for (buildRotationForMode: horizontal -> ROT_CW).  The grip point sits
// about (-0.3, +0.6) cm off the aux stepper's rotation axis, so the 90-degree
// turn carries the block centre round that axis by X +0.9 / Y -0.3 cm.
// Subtracting this vector sends the holder that far back, and the swing then
// delivers the block onto the cell centre.  Derived from a rig measurement of
// a horizontal placement landing 1.4 cm too far from the X home switch with
// Y dead on; the (0.9, -0.3) pair is the unique fit to those two readings.
//
// NOT to be confused with GRID_ERROR_OFFSET_* (a rotation-blind nudge to the
// cell centres themselves) or with the +1.9 cm GRID_TRIM_* registration (grid
// layout).  This one is claw geometry and nothing else - see D15 in
// docs/dual-orientation-grid.md.
//
// CCW stays zero: no grid or build route requests it, so it has never been
// measured.  The recorded (3.75, 1.40) CCW trial predates the centre-anchored
// lattice and must NOT be copied here.
float TOOL_OFFSET_NEUTRAL_X_CM = 0.0;
float TOOL_OFFSET_NEUTRAL_Y_CM = 0.0;
float TOOL_OFFSET_CW_X_CM = 0.9;
float TOOL_OFFSET_CW_Y_CM = -0.3;
float TOOL_OFFSET_CCW_X_CM = 0.0;
float TOOL_OFFSET_CCW_Y_CM = 0.0;

// The ASCII map is only drawn when the grid is small enough to be
// readable. Bigger grids print a numeric summary instead.
const long GRID_MAP_MAX_COLS = 48;
const long GRID_MAP_MAX_ROWS = 48;

// "Not on a cell at all" - in a gap, or off the grid. It is -1 and NOT 0,
// because 0 is a real cell now (the feeder). Every index that can come back
// from positionToIndex() has to be tested against this, never against 0.
const long GRID_INDEX_NONE = -1;

// Last commanded cell. GRID_INDEX_NONE = unknown / not on a cell.
long curCol = GRID_INDEX_NONE;
long curRow = GRID_INDEX_NONE;

// ============================================================
// SECTION 6D - HOMING CONFIGURATION
// ============================================================

// Steps per homing chunk. Between chunks the switch is re-checked
// anyway by moveSteps, so this mostly controls report granularity.
const long HOME_CHUNK_STEPS = 200;

// Safety stop: if an axis has travelled this far without finding its
// switch, something is wrong (broken switch, unplugged, wrong pin).
//
// Derived from the soft travel rather than hard-coded, so re-tuning a
// travel cap can never leave a stale homing cap behind. Two full
// lengths plus slack covers "we started at the far end and the axis
// has drifted", which is the worst honest case.
const long HOME_MAX_MULTIPLIER = 2;
const long HOME_MAX_SLACK_STEPS = 500;

// Used only when an axis has no usable soft travel to derive from.
const long HOME_MAX_STEPS_FALLBACK = 20000;

const bool HOME_VERBOSE = true;

// ============================================================
// SECTION 6E - Z HEIGHT / BLOCK LEVEL CALIBRATION     <<< NEW
// ============================================================
//
// Everything the BUILD command knows about height lives here. Change
// a number in this section and the whole build system rescales - no
// other code needs touching.
//
// ------------------------------------------------------------
//   THE TWO MEASUREMENTS THAT MATTER
// ------------------------------------------------------------
//   Both ends of Z travel are physical switches, so the travel is a
//   fixed property of the hardware. It is described twice - once in
//   steps, once in centimetres - and the ratio is the scale factor
//   the whole build system runs on:
//
//        bottom = the Z- switch, pin 28   (Z = 0 steps, GROUND)
//        top    = the Z+ switch, pin 29   (Z ~ Z_TRAVEL_STEPS)
//
//        steps per cm = Z_TRAVEL_STEPS / Z_TRAVEL_CM
//                     = 1350 / 26.5
//                     = 50.9434 steps per cm approximately
//
//   and one 1.5 cm block is approximately 76.42 steps. The maths
//   below rounds to the nearest step.
//
//   This is computed at RUN TIME by zStepsPerCm(), never hard-coded,
//   so re-measuring the rig is a one-line change. Send  Z  to print
//   the resulting table.
//
// ------------------------------------------------------------
//   YOU DO NOT HAVE TO GUESS Z_TRAVEL_STEPS
// ------------------------------------------------------------
//   Since pin 29 went in, the machine measures the step distance
//   itself: any run up into the top switch that STARTED from a true
//   zero records what it counted. Send 0+ (bottom, then top), then 5,
//   and the report prints the measured value beside this constant.
//   If they disagree, put the measured number here - Z_TRAVEL_CM is
//   still yours to tape-measure.
//
//   Getting it wrong no longer risks a crash, because the switch
//   stops the axis either way. It only skews the cm <-> step scale,
//   which shows up as blocks landing slightly high or low.

// Steps between the two Z switches. CALIBRATION ONLY - the pin 29
// switch is what actually stops the axis at the top.
long Z_TRAVEL_STEPS = 1350;

// What the rig last measured between the switches, 0 = not measured
// yet this session. Recorded by applyLimitReference().
long zTravelMeasured = 0;

// Real-world height of the full Z travel, in centimetres.
float Z_TRAVEL_CM = 26.5;

// Height of one block, in centimetres. Levels are multiples of this:
//   level 0 = GROUND (drive into the physical switch)
//   level 1 = 1.5 cm, level 2 = 3.0 cm, level 3 = 4.5 cm ...
float BLOCK_HEIGHT_CM = 1.5;

// ------------------------------------------------------------
//   FEEDER-BELT PICKUP HEIGHT  (build phase 5 only)
// ------------------------------------------------------------
//   A feeder belt sits at the [0,0] pickup point, ABOVE the table
//   GROUND. Build phase 5 no longer drops the claw onto the bottom Z
//   switch to grab its block - it would ram the belt. It descends a
//   FIXED distance below the TOP switch and grips there.
//
//   SIGN EXCEPTION - the one Z knob NOT measured up from GROUND. It is
//   measured DOWN from the pin 29 TOP switch. zGoPickup() SEEKS the top
//   switch itself, then steps `drop` below where it physically stopped -
//   so the descent is exact even if Z_TRAVEL_STEPS is off, and identical
//   on every block. Z_TRAVEL_STEPS only converts cm to the drop step
//   count. Larger = deeper = LOWER pickup.
//
//   Nominal at the shipped calibration (Z_TRAVEL_CM 26.5, STEPS 1350),
//   as the `Z` report prints it:
//        13.3 cm below top == ~13.2 cm above GROUND == ~672 steps.
//
//   The build no longer re-zeroes Z at GROUND; phase 1's top-switch seek
//   references it every build, and `0+` still gives a true GROUND zero.
//   The bottom Z switch stays required as a physical backstop. Keep this
//   in step with arduino/build_test_v1 (test_grid.py pairs the fill
//   sketches to the rig sketch).
float Z_PICKUP_DROP_FROM_TOP_CM = 13.3;

// ------------------------------------------------------------
//   MARGIN OF ERROR  (all three may be POSITIVE or NEGATIVE)
// ------------------------------------------------------------
//   Reality never matches the arithmetic exactly. If a placed block
//   ends up 1.52 cm high instead of 1.50, the error is PER LEVEL and
//   it accumulates up the stack - trim it with the PER_LEVEL margin.
//   If every level is uniformly a bit low or high (claw geometry, the
//   switch tripping early, block lip), that is a CONSTANT error -
//   trim it with the FIXED margin.
//
//        target_cm = level * (BLOCK_HEIGHT_CM + Z_MARGIN_PER_LEVEL_CM)
//                    + Z_MARGIN_FIXED_CM
//        target_steps = round(target_cm * stepsPerCm) + Z_MARGIN_FIXED_STEPS
//
//   Examples:
//     blocks land 0.02 cm too HIGH each level  ->  PER_LEVEL = -0.02
//     blocks land 0.02 cm too LOW  each level  ->  PER_LEVEL = +0.02
//     everything sits 0.10 cm too low          ->  FIXED     = +0.10
//
//   Level 0 ignores all of these on purpose: ground is the physical
//   switch, not a computed number, so it cannot drift.

float Z_MARGIN_PER_LEVEL_CM = 0.0; // cm added to EACH level (cumulative)
float Z_MARGIN_FIXED_CM = 0.48;    // cm added ONCE to any level >= 1
                                  // (was 0.12; raised to 0.48 - placed block
                                  //  pressed too hard on the one below)
long Z_MARGIN_FIXED_STEPS = 0;     // raw step trim, applied last

// ------------------------------------------------------------
//   HOW HIGH ARE WE ALLOWED TO BUILD?
// ------------------------------------------------------------
//   The claw can physically reach Z_TRAVEL_CM (26.5 cm), but building
//   that high leaves no room to fly a block over the stack. Cap the
//   BUILD height lower than the travel and keep the difference as
//   headroom: carry height is always the full software limit, so
//   (Z_TRAVEL_CM - MAX_BUILD_HEIGHT_CM) is the clearance over the
//   tallest possible tower.
//
//   The highest usable level is floor(MAX_BUILD_HEIGHT_CM /
//   BLOCK_HEIGHT_CM) - it does NOT have to come out even.
//     25.0 / 1.5 = 16.67  ->  level 16  (24.0 cm), 3.0 cm of headroom

float MAX_BUILD_HEIGHT_CM = 25.0;

// Rounding slack so a cap that is an exact multiple of the block
// height (e.g. 24.0 / 1.5 = 16) is not lost to float error.
const float LEVEL_EPSILON = 0.001;

// ------------------------------------------------------------
//   BUILD BEHAVIOUR
// ------------------------------------------------------------

// Pause after each phase of the build, so the rig settles (and so a
// human can follow along / hit reset). 0 disables.
unsigned int BUILD_PHASE_PAUSE_MS = 250;

// After the block is released, PARK the rig: lift Z clear of what was
// just placed, walk X/Y back to the origin, and un-rotate the claw.
//
// This leaves the machine in exactly the state a build expects to
// start from, so the rig is never left hanging over a stack with an
// open claw - and the next B command finds everything already where
// it wants it (its first two phases become no-ops).
//
// Set false only if you want the claw to stay put over the block it
// just placed, e.g. while eyeballing placement accuracy by hand.
bool BUILD_PARK_AFTER_PLACE = true;

// How many phases a full build prints. Purely cosmetic - it only
// feeds the "[BUILD n/N]" progress lines.
const uint8_t BUILD_STEP_COUNT = 14;

const bool BUILD_VERBOSE = true;

// ============================================================
// SECTION 6F - CLAW ROTATION STATE                    <<< NEW
// ============================================================
//
// The claw is assumed to START neutral. A manual `A <degrees>` jog is tracked
// relative to that assumed position; there is no sensor that can prove it.
//
// A horizontal build turns its block 90 CW. That leaves the claw turned too,
// which would be wrong for the NEXT pick-up. So the build sequence always
// returns to neutral while it is over the feeder at 0,0 - before it descends -
// and only then applies THIS grid's placement rotation at the target.
//
//   last build did CW  ->  next build rotates CCW at home (back to 0)
//   last build did CCW ->  next build rotates CW at home  (back to 0)
//   last build did NR  ->  nothing to undo

const int8_t ROT_NONE = 0;
const int8_t ROT_CW = +1;
const int8_t ROT_CCW = -1;

// Where the claw is RIGHT NOW, relative to neutral. A manual angle that is
// not exactly 0/+90/-90 has no calibrated tool offset, so it is marked
// unknown until a build returns it to neutral.
int8_t clawRotation = ROT_NONE;
bool clawRotationKnown = true;

// ============================================================
// SECTION 7 - STEP COUNTER / POSITION CONFIGURATION
// ============================================================

unsigned long stepCounts[MOVE_COUNT] = {0, 0, 0, 0, 0, 0};

long axisPos[AXIS_COUNT] = {0, 0, 0};

// True only after a successful home. Grid moves and builds refuse to
// run before this, because both are nonsense without a real origin.
// (Z is set true the moment its physical switch trips, same as X/Y.)
bool axisHomed[AXIS_COUNT] = {false, false, false};

// Where that position came from: true = the axis' HOME switch set it,
// which is the only reference precise enough to measure against.
//
// Z can also be positioned by its TOP switch, which is a guess taken
// from Z_TRAVEL_STEPS rather than something counted - good enough to
// work with, not good enough to calibrate from. Keeping the two
// apart is what stops a top-switch guess being reported back as a
// measurement of itself. See applyLimitReference().
bool axisRefAtHome[AXIS_COUNT] = {false, false, false};

const bool SHOW_DISTANCE = false;
const float STEPS_PER_UNIT = 200.0;
const char *DISTANCE_UNIT = "mm";

// ============================================================
// SECTION 7B - STATISTICS                             <<< NEW
// ============================================================
//
// Everything the machine has done since power-on (or since the last
// stats reset with command 6). Command 5 prints all of it.
//
// These are diagnostics, not control state - nothing here ever
// changes what the machine does. That means a reset is always safe.

// --- when the current stats window started ---
unsigned long statsSinceMs = 0;

// --- commands accepted, by kind ---
unsigned long statJogs = 0;          // 1-4, D, U
unsigned long statGotos = 0;         // G
unsigned long statHomeCommands = 0;  // 0
unsigned long statBuildCommands = 0; // B (parsed OK, whether or not it ran)
unsigned long statBadCommands = 0;   // unparseable / unknown lines

// --- per axis ---
unsigned long statHomeRuns[AXIS_COUNT] = {0, 0, 0};
unsigned long statHomeFails[AXIS_COUNT] = {0, 0, 0};
unsigned long statSoftBlocks[AXIS_COUNT] = {0, 0, 0}; // soft limit refusals
unsigned long statShortMoves[AXIS_COUNT] = {0, 0, 0}; // moves that stopped early

// --- per SWITCH, not per axis ---
//
// Z has two of them, and "the Z switch was hit" would be an ambiguous
// thing to count. Per-axis totals are summed on demand by
// axisSwitchTrips() for the axis table.
unsigned long statSwitchTrips[LIMIT_COUNT] = {0, 0, 0, 0};

// Edge detection, so one physical trip counts once instead of once
// per step spent sitting on the switch.
bool limitWasActive[LIMIT_COUNT] = {false, false, false, false};
bool softWasActive[AXIS_COUNT] = {false, false, false};

// --- gripper + rotation ---
unsigned long statServoOpens = 0;
unsigned long statServoCloses = 0;
unsigned long statRotCW = 0;
unsigned long statRotCCW = 0;

// --- builds ---
unsigned long statBuildsAttempted = 0;
unsigned long statBuildsCompleted = 0;
unsigned long statBuildsRejected = 0; // failed validation, never moved
unsigned long statBuildsAborted = 0;  // started moving, then failed
unsigned long statBuildTotalMs = 0;   // completed builds only
unsigned long statBuildLastMs = 0;
unsigned long statBuildFastestMs = 0; // 0 = none yet
unsigned long statBuildSlowestMs = 0;

// Last build, whatever happened to it.
long statLastCol = 0;
long statLastRow = 0;
long statLastLevel = -1; // -1 = no build yet
int8_t statLastRot = ROT_NONE;
bool statLastOk = false;
const char *statLastFailure = NULL; // NULL = it succeeded

// Blocks actually placed, per level. Sized generously so a re-tune of
// BLOCK_HEIGHT_CM cannot overflow it; levels past the end are still
// counted in the total, just not in the histogram.
const uint8_t LEVEL_HISTOGRAM_SIZE = 40;
uint16_t statBlocksAtLevel[LEVEL_HISTOGRAM_SIZE];
unsigned long statBlocksPlaced = 0;

// ============================================================
// SECTION 7C - MACHINE ACKNOWLEDGEMENTS
// ============================================================
//
// Everything else this sketch prints is written for a human. These
// lines are written for the Raspberry Pi. One per outcome, always
// starting with '@' - a character no other line in this sketch begins
// with, so the Pi filters them out with a single test and a human
// reading the Serial Monitor can ignore them by eye.
//
//     @<seq> <KIND> [reason text | key=value ...]
//
// The human text is NEVER removed. An ack is printed BESIDE it, so a
// Serial Monitor session reads exactly as it always did.
//
// The kinds:
//     OK    finished, block placed, rig parked - safe
//     ERR   refused before anything moved (bad command)
//     SAFE  failed before anything moved
//     HELD  failed PART WAY THROUGH. The claw may still be gripping a
//           block and the position is unknown. NEEDS A HUMAN.
//
// SAFE and HELD are separate KINDS rather than a flag on one kind on
// purpose: it means code on the Pi cannot lump them together with a
// generic "if not ok: retry". The retry is what breaks the rig.
//
// The sequence number is assigned HERE, not by the Pi, so that the
// command grammar stays type-able by hand in a Serial Monitor. The rig
// runs one command at a time, so "the ack after my command" is never
// ambiguous. Seq 0 means nobody asked - BOOT and READY.
//
// F() everywhere, as always - see the note at the top of the file.

uint16_t ackSeq = 0;

void ackStart(const __FlashStringHelper *kind)
{
  Serial.print('@');
  Serial.print(ackSeq);
  Serial.print(' ');
  Serial.print(kind);
}

void ackField(const __FlashStringHelper *name, long value)
{
  Serial.print(' ');
  Serial.print(name);
  Serial.print('=');
  Serial.print(value);
}

// A key=value pair whose value is a WORD rather than a number.
//
// Deliberately not an ackField() overload: an integer literal 0 is also a
// null pointer constant, so ackField(F("level"), 0) would become ambiguous
// and every existing numeric call site is one edit away from that trap.
void ackWord(const __FlashStringHelper *name, const __FlashStringHelper *value)
{
  Serial.print(' ');
  Serial.print(name);
  Serial.print('=');
  Serial.print(value);
}

// ---- STEP: real-time build progress, one line per PHASE ----
//
// A build is ~40 seconds of motion during which the sketch never reads
// serial, so without these the Pi learns nothing between "B sent" and
// the terminal ack. One line per phase - FOURTEEN lines per build, not
// one per motor step. At 9600 baud fourteen lines is about 0.3 s of
// airtime inside a 40 s build; one line per step would be minutes and
// would starve the terminal ack that actually matters.
//
//     @12 STEP step=8 total=14 phase=move_to_target action=move
//         text=Move_XY_to_target status=begin
//
// STEP is NOT terminal. It carries the same ackSeq as the B command it
// belongs to, so the Pi can attribute every phase to one command.
//
//   step    1..BUILD_STEP_COUNT
//   total   BUILD_STEP_COUNT, so the Pi never hard-codes 14
//   phase   a STABLE identifier - the thing UIs switch on. Never
//           reword one of these without changing the Pi with it.
//   action  what the phase is expected to do: move / grip / release /
//           rotate / park. Coarse on purpose; the twin needs to know
//           whether a block is being carried, not which motor turns.
//   text    the human label, underscored so it stays one token
//   status  'begin' before the phase runs. The single 'done' is
//           phase 11, which is the moment the block leaves the claw -
//           see the note at its call site.
//
// Emitted whatever BUILD_VERBOSE says: the prose is for the human and
// may be turned off, but the machine channel is not a debug aid.
void ackStep(uint8_t n,
             const __FlashStringHelper *phase,
             const __FlashStringHelper *action,
             const __FlashStringHelper *label,
             const __FlashStringHelper *status,
             long etaMs)
{
  ackStart(F("STEP"));
  ackField(F("step"), (long)n);
  ackField(F("total"), (long)BUILD_STEP_COUNT);
  ackWord(F("phase"), phase);
  ackWord(F("action"), action);
  ackWord(F("text"), label);
  ackWord(F("status"), status);
  // Omitted rather than sent as zero when this phase has no predictable
  // duration. Absent means "no idea"; 0 would mean "instant", and a UI
  // cannot tell those apart from a number alone.
  if (etaMs > 0)
  {
    ackField(F("ms"), etaMs);
  }
  Serial.println();
}

// One complete ack with a trailing reason. The const char* overload
// takes the SAME pointer the prose above it already printed, so it
// costs no extra SRAM.
void ackReason(const __FlashStringHelper *kind, const char *why)
{
  ackStart(kind);
  Serial.print(' ');
  Serial.println(why);
}

void ackReason(const __FlashStringHelper *kind, const __FlashStringHelper *why)
{
  ackStart(kind);
  Serial.print(' ');
  Serial.println(why);
}

// The first machine line after a reset. Opening the serial port
// reboots the board, so the Pi sees this on every connect - and an
// unexpected one mid-command means the board reset under us.
void ackBoot()
{
  Serial.println(F("@0 BOOT fw=build_test_v1"));
}

// The LAST line of setup(). This is the Pi's sync marker: everything
// before it is banner, everything after it is a response. Matching the
// banner by its wording is what this replaces.
void ackReady()
{
  Serial.print(F("@0 READY grid="));
  Serial.print(gridColsNow());
  Serial.print('x');
  Serial.print(gridRowsNow());
  // The mode is on this line because a reset silently returns the board to
  // vertical. A Pi that believes otherwise would send every coordinate to the
  // wrong grid, so it has to be told on every connect, not asked for later.
  Serial.print(F(" mode="));
  Serial.print(gridModeName(gridMode));
  Serial.println();
}

// ============================================================
// SECTION 8 - COMMAND CHARACTERS
// ============================================================

const char CMD_MOVE_FIRST = '1';
const char CMD_MOVE_LAST = '4';
const char CMD_SHOW_COUNTS = '5';
const char CMD_RESET_COUNTS = '6';
const char CMD_MOTORS_OFF = '7';
const char CMD_ZERO_POSITION = '8';
const char CMD_SHOW_GRID = '9';
const char CMD_GO_ORIGIN = '0';

const char CMD_MOVE_Z_NEG = 'D'; // Z-  (bottom limit switch, pin 28)
const char CMD_MOVE_Z_POS = 'U'; // Z+  (top limit switch, pin 29)

const char CMD_SERVO_OPEN = 'O';
const char CMD_SERVO_CLOSE = 'C';
const char CMD_SERVO_ANGLE = 'V'; // V <angle> (0..180 degrees)
const char CMD_AUX_STEPPER_ANGLE = 'A'; // A <degrees> (-360..360, relative)

// R and RR are the GRID MODE LATCH, not a claw jog. R selects the vertical
// grid, RR the horizontal one; neither moves the aux stepper. RR is handled in
// handleLine because it is two characters.
const char CMD_GRID_MODE_VERTICAL = 'R';

const char CMD_BUILD = 'B';   // B <col> <row> <level>
const char CMD_Z_TABLE = 'Z'; // print the Z / build calibration

// ============================================================
// BLOCK REASONS
// ============================================================

const uint8_t BLOCK_NONE = 0;
const uint8_t BLOCK_PHYSICAL = 1;
const uint8_t BLOCK_SOFTWARE = 2;

// ============================================================
// SERIAL LINE BUFFER
// ============================================================

const uint8_t LINE_BUF_SIZE = 32;
char lineBuf[LINE_BUF_SIZE];
uint8_t lineLen = 0;

// When the last character landed - used only to decide that a lone
// "0" / "0+" has stopped growing and can be run. See
// flushPendingZeroCommand(). A whole line arrives from the Serial
// Monitor in one burst, so this only ever expires between commands.
unsigned long lastCharAtMs = 0;
const unsigned long ZERO_CMD_IDLE_MS = 50;

// ============================================================
// SETUP
// ============================================================

void buildTestV1Setup()
{
  pinMode(DIR_PIN1, OUTPUT);
  pinMode(STEP_PIN1, OUTPUT);
  pinMode(EN_PIN1, OUTPUT);

  pinMode(DIR_PIN2, OUTPUT);
  pinMode(STEP_PIN2, OUTPUT);
  pinMode(EN_PIN2, OUTPUT);

  pinMode(DIR_PIN3, OUTPUT);
  pinMode(STEP_PIN3, OUTPUT);

  // Every switch in the table, however many there are.
  for (uint8_t i = 0; i < LIMIT_COUNT; i++)
  {
    pinMode(LIMITS[i].pin, INPUT_PULLUP);
  }

  digitalWrite(STEP_PIN1, LOW);
  digitalWrite(STEP_PIN2, LOW);
  digitalWrite(STEP_PIN3, LOW);

  disableMotors();

  gripperServo.attach(SERVO_PIN);
  gripperServo.write(SERVO_CLOSE_ANGLE);
  servoIsOpen = false;

  auxStepper.setSpeed(AUX_STEPPER_SPEED_RPM);

  // The claw is assumed to be physically neutral at power-on.
  auxStepperPos = 0;
  auxAngleSteps = 0;
  clawRotation = ROT_NONE;
  clawRotationKnown = true;

  // Start the statistics window with the machine.
  statsSinceMs = millis();

  Serial.begin(9600);
  delay(1000);

  ackBoot();

  printInstructions();
  printLimitStatus();
  printSoftLimitStatus();
  printGridConfig();
  printServoStatus();
  printAuxStepperStatus();
  printBuildConfig();

  Serial.println();
  Serial.println(F(">> Position is UNKNOWN until you home. Send 0 to home."));
  Serial.println(F(">> B homes everything itself, including Z."));
  Serial.println(F(">> Z+ is a HARDWARE end stop (pin 29), not a soft limit."));

  ackReady();
}

// ============================================================
// MAIN LOOP
// ============================================================

void buildTestV1Loop()
{
  checkSerial();
}

// ============================================================
// SERIAL PARSING
// ============================================================
//
// Single digits execute immediately (works with "No line ending").
// Anything else accumulates until newline, then gets parsed.

void checkSerial()
{
  while (Serial.available() > 0)
  {
    char c = Serial.read();

    if (c == '\n' || c == '\r')
    {
      if (lineLen > 0)
      {
        lineBuf[lineLen] = '\0';
        handleLine(lineBuf);
        lineLen = 0;
      }
      continue;
    }

    // Fast path: a lone digit with nothing buffered is a command.
    //
    // '0' is the ONE exception. It might be the start of "0+", so it
    // has to wait and see what follows. Everything below - the
    // not-a-plus flush and the idle flush - exists to make that wait
    // invisible: a plain 0 still behaves exactly as it always did.
    if (lineLen == 0 && c >= '1' && c <= '9')
    {
      handleSingleChar(c);
      continue;
    }

    if (c == ' ' && lineLen == 0)
    {
      continue; // ignore leading spaces
    }

    // A buffered '0' followed by anything that is NOT '+' was just a
    // plain home. Run it now, then deal with c as a fresh command.
    if (lineLen == 1 && lineBuf[0] == CMD_GO_ORIGIN && c != '+')
    {
      lineLen = 0;
      handleSingleChar(CMD_GO_ORIGIN);

      if (c >= '1' && c <= '9')
      {
        handleSingleChar(c);
        continue;
      }
    }

    if (lineLen < LINE_BUF_SIZE - 1)
    {
      lineBuf[lineLen++] = c;
      lastCharAtMs = millis();
    }
    else
    {
      lineLen = 0; // overflow: drop the garbage line
      Serial.println(F("  ERROR - command too long, ignored."));
    }
  }

  flushPendingZeroCommand();
}

// "0" and "0+" are the only commands that can sit in the buffer with
// nothing following them, because they are the only ones that had to
// wait for a possible '+'. Without this they would be lost whenever
// the Serial Monitor is set to "No line ending" - so once the line
// has gone quiet, run what we have.
//
// Nothing else is flushed this way: every other multi-character
// command still needs its newline, exactly as documented.
void flushPendingZeroCommand()
{
  bool isPendingZero =
      (lineLen == 1 && lineBuf[0] == CMD_GO_ORIGIN) ||
      (lineLen == 2 && lineBuf[0] == CMD_GO_ORIGIN && lineBuf[1] == '+');

  if (!isPendingZero)
  {
    return;
  }
  if ((millis() - lastCharAtMs) < ZERO_CMD_IDLE_MS)
  {
    return;
  }

  lineBuf[lineLen] = '\0';
  handleLine(lineBuf);
  lineLen = 0;
}

void handleLine(char *line)
{
  char head = toUpperChar(line[0]);

  // A single character on its own line behaves like the fast path.
  if (line[1] == '\0')
  {
    if (head == '?')
    {
      printInstructions();
      return;
    }
    handleSingleChar(head);
    return;
  }

  // shiftX / shiftY are routed here, BEFORE the switch on head, so the leading
  // 'S' never has to be shared with 'S <cols> <rows>'. Two-letter "sh" prefix.
  if ((line[0] == 's' || line[0] == 'S') && (line[1] == 'h' || line[1] == 'H'))
  {
    handleShiftCommand(line);
    return;
  }

  long a = 0, b = 0;

  switch (head)
  {
  case CMD_GO_ORIGIN:
    if (line[1] == '+' && line[2] == '\0')
    {
      statHomeCommands++;
      goToOriginWithZ();
    }
    else
    {
      statBadCommands++;
      Serial.println();
      Serial.println(F("  ERROR - use:  0 (home X/Y) or 0+ (reset Z too)"));
    }
    break;

  case 'G':
    if (parseTwoNumbers(line + 1, &a, &b))
    {
      statGotos++;
      gotoCell(a, b);
    }
    else
    {
      statBadCommands++;
      Serial.println();
      Serial.println(F("  ERROR - use:  G <col> <row>   e.g.  G 3 5"));
    }
    break;

  case 'S':
    if (parseTwoNumbers(line + 1, &a, &b))
    {
      setGridSize(a, b);
    }
    else
    {
      statBadCommands++;
      Serial.println();
      Serial.println(F("  ERROR - use:  S <cols> <rows>   e.g.  S 20 4"));
    }
    break;

  case CMD_SERVO_ANGLE:
    if (parseNumbers(line + 1, &a, 1, NULL) == 1 && a >= 0 && a <= 180)
    {
      setServoAngle((int)a);
    }
    else
    {
      statBadCommands++;
      Serial.println();
      Serial.println(F("  ERROR - use:  V <angle>   where angle is 0..180 degrees"));
    }
    break;

  case CMD_AUX_STEPPER_ANGLE:
    if (parseSignedDegree(line + 1, &a)
        && a >= -AUX_STEPPER_MAX_MANUAL_DEGREES
        && a <= AUX_STEPPER_MAX_MANUAL_DEGREES)
    {
      rotateAuxStepperDegrees(a);
    }
    else
    {
      statBadCommands++;
      Serial.println();
      Serial.println(F("  ERROR - use:  A <degrees>   where degrees is -360..360"));
      Serial.println(F("  Positive is CW; negative is CCW; this is relative, not absolute."));
    }
    break;

  case CMD_BUILD:
    handleBuildCommand(line + 1);
    break;

  case 'R':
    if (toUpperChar(line[1]) == 'R' && line[2] == '\0')
    {
      // RR: latch the HORIZONTAL grid. Moves nothing - see setGridMode().
      if (!setGridMode(GRID_MODE_HORIZONTAL))
      {
        statBadCommands++;
      }
    }
    else
    {
      statBadCommands++;
      Serial.println();
      Serial.println(F("  ERROR - use:  R (vertical grid) or RR (horizontal grid)"));
    }
    break;

  default:
    statBadCommands++;
    Serial.println();
    Serial.print(F("  Unknown command: "));
    Serial.println(line);
    break;
  }
}

void handleSingleChar(char command)
{
  if (command >= CMD_MOVE_FIRST && command <= CMD_MOVE_LAST)
  {
    uint8_t index = command - CMD_MOVE_FIRST;
    executeMove(index);
    return;
  }

  switch (command)
  {
  case CMD_SHOW_COUNTS:
    printFullReport();
    break;

  case CMD_RESET_COUNTS:
    resetStatistics();
    break;

  case CMD_MOTORS_OFF:
    disableMotors();
    Serial.println();
    Serial.println(F("MOTORS OFF (holding torque released)"));
    break;

  case CMD_ZERO_POSITION:
    zeroPosition();
    break;

  case CMD_SHOW_GRID:
    printGrid();
    break;

  case CMD_GO_ORIGIN:
    statHomeCommands++;
    goToOrigin();
    break;

  case CMD_MOVE_Z_NEG:
  {
    int8_t idx = findMoveIndex(AXIS_Z, DIR_NEG);
    if (idx >= 0)
    {
      executeMove((uint8_t)idx);
    }
    break;
  }

  case CMD_MOVE_Z_POS:
  {
    int8_t idx = findMoveIndex(AXIS_Z, DIR_POS);
    if (idx >= 0)
    {
      executeMove((uint8_t)idx);
    }
    break;
  }

  case CMD_SERVO_OPEN:
    openServo();
    break;

  case CMD_SERVO_CLOSE:
    closeServo();
    break;

  case CMD_GRID_MODE_VERTICAL:
    // R: latch the VERTICAL grid. Moves nothing - see setGridMode().
    if (!setGridMode(GRID_MODE_VERTICAL))
    {
      statBadCommands++;
    }
    break;

  case CMD_Z_TABLE:
    printBuildConfig();
    printLevelTable();
    break;

  case CMD_BUILD:
    printBuildUsage();
    break;

  default:
    break;
  }
}

char toUpperChar(char c)
{
  if (c >= 'a' && c <= 'z')
  {
    return c - 'a' + 'A';
  }
  return c;
}

// Pulls up to maxCount integers out of a string, ignoring any
// separators (space, comma, colon, etc). Reports how many it found
// and where it stopped, so a trailing keyword can be parsed after it.
uint8_t parseNumbers(const char *s, long *out, uint8_t maxCount, uint8_t *endIndex)
{
  uint8_t found = 0;
  uint8_t i = 0;

  while (s[i] != '\0' && found < maxCount)
  {
    if (s[i] >= '0' && s[i] <= '9')
    {
      long v = 0;
      while (s[i] >= '0' && s[i] <= '9')
      {
        v = v * 10 + (s[i] - '0');
        i++;
      }
      out[found++] = v;
    }
    else if (s[i] >= 'A' && s[i] <= 'Z')
    {
      break; // a keyword started - stop, do not eat it
    }
    else if (s[i] >= 'a' && s[i] <= 'z')
    {
      break;
    }
    else
    {
      i++;
    }
  }

  if (endIndex != NULL)
  {
    *endIndex = i;
  }
  return found;
}

// `parseNumbers()` deliberately treats '-' as a separator because G/S/B use
// non-negative coordinates. The manual aux-stepper command is the one place
// a signed value is meaningful, so keep its stricter parser separate.
bool parseSignedDegree(const char *s, long *out)
{
  uint8_t i = 0;
  while (s[i] == ' ' || s[i] == '\t')
  {
    i++;
  }

  bool negative = false;
  if (s[i] == '+' || s[i] == '-')
  {
    negative = (s[i] == '-');
    i++;
  }
  if (s[i] < '0' || s[i] > '9')
  {
    return false;
  }

  long value = 0;
  while (s[i] >= '0' && s[i] <= '9')
  {
    value = value * 10 + (s[i] - '0');
    i++;
  }
  while (s[i] == ' ' || s[i] == '\t')
  {
    i++;
  }
  if (s[i] != '\0')
  {
    return false;
  }

  *out = negative ? -value : value;
  return true;
}

// Kept for G and S, which want exactly two numbers.
bool parseTwoNumbers(const char *s, long *outA, long *outB)
{
  long values[2] = {0, 0};

  if (parseNumbers(s, values, 2, NULL) < 2)
  {
    return false;
  }

  *outA = values[0];
  *outB = values[1];
  return true;
}

// ============================================================
// MANUAL JOG MOVEMENT (commands 1-4)
// ============================================================

// ------------------------------------------------------------
// Per-axis motion tuning. Z is independent of the X/Y pair in BOTH
// pulse rate and jog size - every Z move reads these, so there is
// one place to change and no way for the two to drift apart.
// ------------------------------------------------------------

unsigned int stepDelayOf(uint8_t axis)
{
  return (axis == AXIS_Z) ? STEP_DELAY_Z : STEP_DELAY;
}

int jogStepsOf(uint8_t axis)
{
  return (axis == AXIS_Z) ? stepsPerMoveZ : stepsPerMove;
}

void executeMove(uint8_t index)
{
  const MoveDef &m = MOVES[index];

  Serial.println();
  Serial.print(F("COMMAND: "));
  Serial.println(m.label);

  statJogs++;

  uint8_t blocked = blockReason(m.axis, m.sign);
  if (blocked != BLOCK_NONE)
  {
    printBlockMessage(blocked, m.axis, m.sign);
    return;
  }

  setDirection(m.dir1, m.dir2, m.dir3);

  int jog = jogStepsOf(m.axis);

  unsigned long moved = moveSteps(jog, m.axis, m.sign);
  stepCounts[index] += moved;

  // A manual jog invalidates the "we are sitting on cell N" idea.
  // Z is not part of the X/Y grid, so a Z jog leaves the cell alone.
  if (m.axis != AXIS_Z)
  {
    curCol = GRID_INDEX_NONE;
    curRow = GRID_INDEX_NONE;
  }

  Serial.print(F("  Moved "));
  Serial.print(moved);
  Serial.print(F(" of "));
  Serial.print(jog);
  Serial.print(F(" steps  ["));
  Serial.print(m.label);
  Serial.print(F("]  pos "));
  Serial.print(axisName(m.axis));
  Serial.print(F(" = "));
  Serial.println(axisPos[m.axis]);

  if (moved < (unsigned long)jog)
  {
    statShortMoves[m.axis]++;
    uint8_t why = blockReason(m.axis, m.sign);
    Serial.print(F("  STOPPED EARLY - "));
    Serial.print(axisName(m.axis));
    if (why == BLOCK_SOFTWARE)
    {
      Serial.println(F(" SOFTWARE limit reached during the move."));
    }
    else
    {
      Serial.println(F(" limit switch tripped during the move."));
    }
  }
}

// Sends step pulses, checking limits as it goes.
// Z is an independent motor, so it pulses STEP_PIN3 alone; X/Y stay
// a coupled pair and pulse STEP_PIN1+STEP_PIN2 together.
// Returns the number of pulses actually sent.
unsigned long moveSteps(long steps, uint8_t axis, int8_t sign)
{
  enableMotors();

  unsigned long done = 0;
  uint8_t counter = 0;
  bool isZ = (axis == AXIS_Z);

  // Read the axis' own pulse rate ONCE, not per step. Because every
  // move funnels through here, this is what gives Z its own speed
  // during homing and the build sequence, not just manual jogs.
  unsigned int pulseDelay = stepDelayOf(axis);

  for (long i = 0; i < steps; i++)
  {
    if (counter == 0)
    {
      if (blockReason(axis, sign) != BLOCK_NONE)
      {
        break;
      }
    }
    counter++;
    if (counter >= LIMIT_CHECK_EVERY_N_STEPS)
    {
      counter = 0;
    }

    if (isZ)
    {
      digitalWrite(STEP_PIN3, HIGH);
    }
    else
    {
      digitalWrite(STEP_PIN1, HIGH);
      digitalWrite(STEP_PIN2, HIGH);
    }
    delayMicroseconds(pulseDelay);

    if (isZ)
    {
      digitalWrite(STEP_PIN3, LOW);
    }
    else
    {
      digitalWrite(STEP_PIN1, LOW);
      digitalWrite(STEP_PIN2, LOW);
    }
    delayMicroseconds(pulseDelay);

    axisPos[axis] += sign;
    done++;
  }

  return done;
}

// Finds the MOVES row that drives the given axis in the given
// direction, so direction pins and counters stay in one place.
int8_t findMoveIndex(uint8_t axis, int8_t sign)
{
  for (uint8_t i = 0; i < MOVE_COUNT; i++)
  {
    if (MOVES[i].axis == axis && MOVES[i].sign == sign)
    {
      return (int8_t)i;
    }
  }
  return -1;
}

// Moves one axis by a signed number of steps, using the right
// direction pins and updating the right counter.
// Returns steps actually sent.
unsigned long moveAxisSteps(uint8_t axis, long deltaSteps)
{
  if (deltaSteps == 0)
  {
    return 0;
  }

  int8_t sign = (deltaSteps > 0) ? DIR_POS : DIR_NEG;
  long count = (deltaSteps > 0) ? deltaSteps : -deltaSteps;

  int8_t idx = findMoveIndex(axis, sign);
  if (idx < 0)
  {
    return 0;
  }

  setDirection(MOVES[idx].dir1, MOVES[idx].dir2, MOVES[idx].dir3);
  unsigned long moved = moveSteps(count, axis, sign);
  stepCounts[idx] += moved;
  return moved;
}

// Drives an axis to an absolute machine position.
bool moveAxisTo(uint8_t axis, long target)
{
  long delta = target - axisPos[axis];
  long want = (delta > 0) ? delta : -delta;

  unsigned long moved = moveAxisSteps(axis, delta);

  if (moved < (unsigned long)want)
  {
    statShortMoves[axis]++;
    Serial.print(F("  !! "));
    Serial.print(axisName(axis));
    Serial.print(F(" stopped early at "));
    Serial.print(axisPos[axis]);
    Serial.print(F(" (wanted "));
    Serial.print(target);
    Serial.println(F(")"));
    return false;
  }
  return true;
}

void setDirection(bool dir1, bool dir2, bool dir3)
{
  digitalWrite(DIR_PIN1, dir1);
  digitalWrite(DIR_PIN2, dir2);
  digitalWrite(DIR_PIN3, dir3);
  delay(DIR_SETTLE_MS);
}

void enableMotors()
{
  digitalWrite(EN_PIN1, EN_ACTIVE_LEVEL);
  digitalWrite(EN_PIN2, EN_ACTIVE_LEVEL);
}

void disableMotors()
{
  digitalWrite(STEP_PIN1, LOW);
  digitalWrite(STEP_PIN2, LOW);

  digitalWrite(EN_PIN1, EN_INACTIVE_LEVEL);
  digitalWrite(EN_PIN2, EN_INACTIVE_LEVEL);
}

// ============================================================
// GRIPPER SERVO
// ============================================================

void openServo()
{
  const bool atFeederHome = isLimitHitAt(homeLimitIndexOf(AXIS_X)) &&
                            isLimitHitAt(homeLimitIndexOf(AXIS_Y));
  const int openAngle = atFeederHome ? SERVO_HOME_OPEN_ANGLE : SERVO_OPEN_ANGLE;

  gripperServo.write(openAngle);
  servoIsOpen = true;
  statServoOpens++;

  Serial.println();
  Serial.print(F("SERVO: OPEN ("));
  Serial.print(openAngle);
  Serial.println(F(" deg)"));
}

void closeServo()
{
  gripperServo.write(SERVO_CLOSE_ANGLE);
  servoIsOpen = false;
  statServoCloses++;

  Serial.println();
  Serial.print(F("SERVO: CLOSE ("));
  Serial.print(SERVO_CLOSE_ANGLE);
  Serial.println(F(" deg)"));
}

void setServoAngle(int angle)
{
  gripperServo.write(angle);
  servoIsOpen = (angle == SERVO_HOME_OPEN_ANGLE || angle == SERVO_OPEN_ANGLE);

  Serial.println();
  Serial.print(F("SERVO: ANGLE ("));
  Serial.print(angle);
  Serial.println(F(" deg)"));
}

// Same as above, but waits for the jaws to actually get there.
// The build sequence must never move Z on top of a moving servo.
void openServoAndWait()
{
  openServo();
  delay(SERVO_SETTLE_MS);
}

void closeServoAndWait()
{
  closeServo();
  delay(SERVO_SETTLE_MS);
}

// ============================================================
// AUXILIARY STEPPER (28BYJ-48)
// ============================================================

// Keep the physical angle in (-half turn, +half turn]. The motor has no
// sensor, so this is only as true as the assumed neutral at power-on and the
// steps that have successfully been commanded since then.
long normaliseAuxAngleSteps(long steps)
{
  const long halfTurn = AUX_STEPPER_STEPS_PER_REV / 2;
  while (steps > halfTurn)
  {
    steps -= AUX_STEPPER_STEPS_PER_REV;
  }
  while (steps <= -halfTurn)
  {
    steps += AUX_STEPPER_STEPS_PER_REV;
  }
  return steps;
}

void updateClawRotationKnowledge()
{
  if (auxAngleSteps == 0)
  {
    clawRotation = ROT_NONE;
    clawRotationKnown = true;
  }
  else if (auxAngleSteps == AUX_STEPPER_QUARTER_TURN)
  {
    clawRotation = ROT_CW;
    clawRotationKnown = true;
  }
  else if (auxAngleSteps == -AUX_STEPPER_QUARTER_TURN)
  {
    clawRotation = ROT_CCW;
    clawRotationKnown = true;
  }
  else
  {
    clawRotationKnown = false;
  }
}

void stepAuxStepper(long steps)
{
  if (steps == 0)
  {
    return;
  }
  auxStepper.step(steps);
  auxStepperPos += steps;
  auxAngleSteps = normaliseAuxAngleSteps(auxAngleSteps + steps);
  updateClawRotationKnowledge();
}

long auxStepsForDegrees(long degrees)
{
  long magnitude = degrees < 0 ? -degrees : degrees;
  // Round to the nearest available motor step rather than always making a
  // small requested angle short. 2048 steps/rev gives ~0.176 degrees/step.
  long steps = (magnitude * AUX_STEPPER_STEPS_PER_REV + 180) / 360;
  return degrees < 0 ? -steps : steps;
}

void rotateAuxStepperDegrees(long degrees)
{
  long steps = auxStepsForDegrees(degrees);

  Serial.println();
  Serial.print(F("AUX STEPPER: rotating "));
  Serial.print(degrees);
  Serial.print(F(" deg relative ("));
  Serial.print(steps);
  Serial.print(F(" steps) "));
  Serial.println(degrees < 0 ? F("CCW...") : F("CW..."));

  stepAuxStepper(steps);

  Serial.print(F("AUX STEPPER: done. Tracked angle from power-on neutral: "));
  Serial.print((float)auxAngleSteps * 360.0 / (float)AUX_STEPPER_STEPS_PER_REV, 1);
  Serial.println(F(" deg."));
  if (!clawRotationKnown)
  {
    Serial.println(F("  Grid moves/latches are refused until a B returns the claw to neutral."));
  }
}

void rotateAuxStepperCW()
{
  Serial.println();
  Serial.println(F("AUX STEPPER: rotating ~90 deg CW..."));
  stepAuxStepper(AUX_STEPPER_QUARTER_TURN);
  statRotCW++;
  Serial.println(F("AUX STEPPER: done."));
}

void rotateAuxStepperCCW()
{
  Serial.println();
  Serial.println(F("AUX STEPPER: rotating ~90 deg CCW..."));
  stepAuxStepper(-AUX_STEPPER_QUARTER_TURN);
  statRotCCW++;
  Serial.println(F("AUX STEPPER: done."));
}

// ------------------------------------------------------------
// Rotation as a TRACKED STATE, not a blind jog.        <<< NEW
// ------------------------------------------------------------
// Build rotation is a target angle, not a blind jog. A manual A command may
// leave the claw at an arbitrary tracked angle, so return from that actual
// angle rather than assuming only the three old quarter-turn states exist.

const char *rotationName(int8_t rot)
{
  if (rot == ROT_CW)
  {
    return "CW (+90)";
  }
  if (rot == ROT_CCW)
  {
    return "CCW (-90)";
  }
  return "NR (neutral)";
}

// Turns the claw so it ends up at `target` (ROT_NONE / CW / CCW), whatever it
// is doing now, including a tracked arbitrary manual A angle.
void rotateClawTo(int8_t target)
{
  long targetSteps = (long)target * AUX_STEPPER_QUARTER_TURN;
  long delta = targetSteps - auxAngleSteps;
  if (delta == 0)
  {
    if (BUILD_VERBOSE)
    {
      Serial.print(F("  Claw already at "));
      Serial.print(rotationName(target));
      Serial.println(F(" - no rotation needed."));
    }
    return;
  }

  Serial.print(F("  Rotating claw: "));
  if (clawRotationKnown)
  {
    Serial.print(rotationName(clawRotation));
  }
  else
  {
    Serial.print(F("manual angle"));
  }
  Serial.print(F("  ->  "));
  Serial.println(rotationName(target));

  // One direct correction handles e.g. a manual 45-degree jog. Ordinary
  // quarter-turn build moves keep their existing statistics and diagnostics.
  if ((delta % AUX_STEPPER_QUARTER_TURN) == 0)
  {
    while (delta > 0)
    {
      rotateAuxStepperCW();
      delta -= AUX_STEPPER_QUARTER_TURN;
    }
    while (delta < 0)
    {
      rotateAuxStepperCCW();
      delta += AUX_STEPPER_QUARTER_TURN;
    }
  }
  else
  {
    Serial.print(F("  AUX STEPPER: correcting "));
    Serial.print(delta);
    Serial.println(F(" steps to a calibrated grid angle..."));
    stepAuxStepper(delta);
  }

  clawRotation = target;
  clawRotationKnown = true;
}

// ============================================================
// HOMING / ORIGIN
// ============================================================

long homeMaxStepsOf(uint8_t axis)
{
  long travel = axisTravelOf(axis);

  if (travel <= 0)
  {
    return HOME_MAX_STEPS_FALLBACK; // nothing configured to scale from
  }
  return travel * HOME_MAX_MULTIPLIER + HOME_MAX_SLACK_STEPS;
}

// ------------------------------------------------------------
// Drives toward the switch at ONE END of an axis until it trips.
// ------------------------------------------------------------
// This used to be homeAxis() and could only ever run toward the home
// switch, because that was the only switch an axis had. Z+ on pin 29
// changed that: "go to the top of Z" is now the same operation as
// "home Z", just aimed at the other end, so both go through here.
//
// isPhysicalBlocked() is what notices the contact, and
// applyLimitReference() is what the contact means for the position -
// this function only walks until one of them says stop.
bool seekLimit(uint8_t axis, int8_t end)
{
  int8_t idx = findLimitIndex(axis, end);
  bool isHomeSeek = (idx >= 0) && LIMITS[idx].isHome;

  statHomeRuns[axis]++;

  if (idx < 0 || !LIMITS[idx].enabled)
  {
    Serial.print(F("  CANNOT SEEK "));
    Serial.print(axisName(axis));
    Serial.print(signName(end));
    Serial.println(F(" - no enabled limit switch at that end."));
    if (isHomeSeek)
    {
      axisHomed[axis] = false;
    }
    statHomeFails[axis]++;
    return false;
  }

  long travelled = 0;
  long maxSteps = homeMaxStepsOf(axis);

  if (HOME_VERBOSE)
  {
    if (isHomeSeek)
    {
      Serial.print(F("  Homing "));
    }
    else
    {
      Serial.print(F("  Seeking "));
    }
    Serial.print(axisName(axis));
    Serial.print(signName(end));
    Serial.print(F(" (pin "));
    Serial.print(LIMITS[idx].pin);
    Serial.print(F(") ..."));
  }

  while (travelled < maxSteps)
  {
    if (isPhysicalBlocked(axis, end))
    {
      if (HOME_VERBOSE)
      {
        Serial.print(F(" switch found after "));
        Serial.print(travelled);
        Serial.print(F(" steps. "));
        if (isHomeSeek)
        {
          Serial.println(F("Axis zeroed."));
        }
        else
        {
          Serial.println(F("At the end stop."));
        }
      }
      return true;
    }

    unsigned long moved = moveAxisSteps(axis, (long)end * HOME_CHUNK_STEPS);
    travelled += (long)moved;

    if (moved == 0)
    {
      break; // something is blocking and it is not this switch
    }
  }

  // Fell out without finding the switch.
  if (isPhysicalBlocked(axis, end))
  {
    if (HOME_VERBOSE)
    {
      if (isHomeSeek)
      {
        Serial.println(F(" switch found. Axis zeroed."));
      }
      else
      {
        Serial.println(F(" switch found. At the end stop."));
      }
    }
    return true;
  }

  Serial.println();
  Serial.print(F("  SEEK FAILED on "));
  Serial.print(axisName(axis));
  Serial.print(signName(end));
  Serial.print(F(" after "));
  Serial.print(travelled);
  Serial.println(F(" steps - switch never tripped."));
  Serial.println(F("  Check wiring, pin number, and NC/NO setting."));
  if (isHomeSeek)
  {
    axisHomed[axis] = false;
  }
  statHomeFails[axis]++;
  return false;
}

// Drives toward the axis' HOME switch until it trips.
// The switch itself sets axisPos to 0 via isPhysicalBlocked().
bool homeAxis(uint8_t axis)
{
  return seekLimit(axis, homeEndOf(axis));
}

// ------------------------------------------------------------
// 0+  -  the "reset everything" homing.
// ------------------------------------------------------------
// Plain 0 homes X/Y and deliberately leaves Z alone. 0+ resets the
// Z axis as well, which takes two moves rather than one:
//
//   Z DOWN into its BOTTOM switch    - the axis' true zero, and the
//     GROUND the block levels are measured from. Both ends are
//     switches now, so this run is no longer needed to find the top -
//     but it is still needed to know what any height MEANS.
//
//   Z UP into its TOP switch         - where the claw wants to sit
//     between jobs: clear of the bed, clear of anything built, and
//     exactly where a build expects to start from. Doing it in this
//     order also measures the switch-to-switch distance for free.
//
// Z is done BEFORE X/Y so the gantry never drags a low claw across
// the bed - by the time X/Y move, the claw is parked at the top.
bool goToOriginWithZ()
{
  Serial.println();
  Serial.println(F("=== FULL RESET - Z, then X/Y ==="));

  // ---- 1. give Z a real zero ----
  Serial.println(F("  [1/3] Z down into its BOTTOM switch (true zero)..."));
  if (!homeAxis(AXIS_Z))
  {
    Serial.println(F("  ABORTED - Z never found its bottom switch."));
    Serial.println(F("  X/Y were NOT homed: moving now could drag the claw."));
    return false;
  }

  // ---- 2. park it at the top ----
  Serial.println(F("  [2/3] Z up into its TOP switch (pin 29)..."));

  bool okZ = zGoTop();
  if (!okZ)
  {
    // Z has a valid zero and stopped somewhere known, so homing X/Y
    // is still safe and still worth doing. Say so and carry on.
    Serial.println(F("  WARNING - Z never reached the top switch."));
  }
  else
  {
    printZTravelMeasurement();
  }

  // ---- 3. now the claw is high, walk the gantry home ----
  Serial.println(F("  [3/3] Homing X/Y..."));
  bool okXY = goToOrigin();

  Serial.println();
  if (okXY && okZ)
  {
    Serial.println(F("FULL RESET COMPLETE - X/Y at origin, Z on its top switch."));
    return true;
  }

  Serial.println(F("FULL RESET INCOMPLETE - see the warnings above."));
  return false;
}

// Y first, then X - same order as the go-to sequence.
bool goToOrigin()
{
  Serial.println();
  Serial.println(F("=== GO TO ORIGIN (homing both axes) ==="));

  bool okY = homeAxis(AXIS_Y);
  bool okX = homeAxis(AXIS_X);

  if (okX && okY)
  {
    // Home is (0,0) cm, which is the outer EDGE of cell [0,0] - and therefore
    // inside its footprint, so [0,0] is the honest answer here. Not a sentinel.
    curCol = 0;
    curRow = 0;
    Serial.println(F("  AT ORIGIN. Position = X 0 / Y 0"));
    return true;
  }

  Serial.println(F("  ORIGIN NOT REACHED - position is NOT trustworthy."));
  return false;
}

// ============================================================
// GRID MATH
// ============================================================

// Software-safe envelope size and direction of travel for an axis. The grid
// only ever covers X and Y, whose far ends are software limits, so this is
// still the soft cap - taken through axisTravelOf so the two can never drift
// apart.
long gridTravelOf(uint8_t axis)
{
  return axisTravelOf(axis);
}

int8_t gridDirOf(uint8_t axis)
{
  return travelEndOf(axis);
}

// Convert only at the boundary between the distance-from-home calibration
// space and the motor's signed position space. X is negative away from home;
// Y is positive, so build corrections must never be added to a signed target.
long axisPosFromHomeSteps(uint8_t axis, long stepsFromHome)
{
  return stepsFromHome * (long)gridDirOf(axis);
}

long axisStepsFromHome(uint8_t axis, long signedPos)
{
  return signedPos * (long)gridDirOf(axis);
}

long gridCountOf(uint8_t axis)
{
  return (axis == AXIS_X) ? gridColsNow() : gridRowsNow();
}

float xyTravelCmOf(uint8_t axis)
{
  return (axis == AXIS_X) ? X_TRAVEL_CM : Y_TRAVEL_CM;
}

float gridBlockCmOf(uint8_t axis)
{
  return (axis == AXIS_X) ? GRID_BLOCK_X_CM[gridMode] : GRID_BLOCK_Y_CM[gridMode];
}

float gridGapCmOf(uint8_t axis)
{
  return (axis == AXIS_X) ? GRID_GAP_X_CM[gridMode] : GRID_GAP_Y_CM[gridMode];
}

float gridPitchCmOf(uint8_t axis)
{
  return gridBlockCmOf(axis) + gridGapCmOf(axis);
}

// Trim + error offset + live shift, all three of which move the lattice against
// the home switches by exactly the same rule. Folding the shift in here is what
// makes shiftX/shiftY translate every centre, every block edge and the [0,0]
// reference together. gridTrimCmZeroShiftOf() is the same sum with the shift
// left out - used where the PHYSICAL grid size has to be judged (S, mode latch)
// independent of whatever shift happens to be applied right now.
float gridTrimCmZeroShiftOf(uint8_t axis)
{
  return (axis == AXIS_X)
             ? GRID_TRIM_X_CM[gridMode] + GRID_ERROR_OFFSET_X_CM[gridMode]
             : GRID_TRIM_Y_CM[gridMode] + GRID_ERROR_OFFSET_Y_CM[gridMode];
}

float gridShiftCmOf(uint8_t axis)
{
  return (axis == AXIS_X) ? GRID_SHIFT_X_CM[gridMode] : GRID_SHIFT_Y_CM[gridMode];
}

float gridTrimCmOf(uint8_t axis)
{
  return gridTrimCmZeroShiftOf(axis) + gridShiftCmOf(axis);
}

// The ACTIVE mode's block-edge overhang budget. See SECTION 6C for why this is
// per mode and why it is not a trim.
float gridMaxEdgeOverhangCmOf(uint8_t axis)
{
  return (axis == AXIS_X) ? GRID_MAX_EDGE_OVERHANG_X_CM[gridMode]
                          : GRID_MAX_EDGE_OVERHANG_Y_CM[gridMode];
}

float xyStepsPerCmOf(uint8_t axis)
{
  float travelCm = xyTravelCmOf(axis);
  return (travelCm > 0.0) ? (float)gridTravelOf(axis) / travelCm : 0.0;
}

// ------------------------------------------------------------
//   THE LATTICE
// ------------------------------------------------------------
//   Every axis is a run of evenly spaced block CENTRES. The centre of cell 0
//   sits on the home corner itself - not its edge - so a full-travel grid has
//   its last centre exactly on the software limit, and cell 0's block hangs
//   half a block past the home switches. That half block is what
//   GRID_MAX_EDGE_OVERHANG_* budgets for.
//
//       centre(i) = trim + errorOffset + i * pitch
//
//   That is the whole model. There is no leading gap, no trailing gap and no
//   centring: the trim IS the only thing that moves a grid, which is how the
//   horizontal pickup-cell registration (+1.9 cm on both axes) is expressed.
//
//   THE GAPS ARE UNIFORM. A vertical block reads 2.2 + 1.6 + 2.2 along its
//   6.0 cm length, and consecutive blocks are also 1.6 cm apart, so the 2.2 cm
//   sub-cells repeat at one unbroken 3.8 cm pitch. An earlier revision had a
//   0.8 cm block gap, which made the horizontal Y lattice alternate 0.8/1.6;
//   measuring the printed sheet (tiles 6.00 cm, gaps 1.56 cm, identical on
//   both axes) showed the gap is 1.6 everywhere and the alternation was an
//   artefact of the wrong number. Do not reintroduce it without re-measuring.

// Highest index + 1. GRID_COLS/GRID_ROWS hold the highest INDEX.
long gridSlotsOf(uint8_t axis)
{
  return gridCountOf(axis) + 1;
}

// Where the first centre sits: the trim, and nothing else.
float gridLatticeStartCmOf(uint8_t axis)
{
  return gridTrimCmOf(axis);
}

// Near edge of the block on cell `index`, measured from the home switch.
// NEGATIVE for cell 0 on an untrimmed axis - the block overhangs home by half
// its own width, which is exactly the point of a centre-anchored lattice.
float gridSlotBottomCmOf(uint8_t axis, long index)
{
  return cellCentreCmOf(axis, index) - gridBlockCmOf(axis) * 0.5;
}

// The gap between cell `index - 1` and cell `index`. Uniform on every axis.
float gridGapBeforeSlotCmOf(uint8_t axis, long index)
{
  return (index < 1) ? 0.0 : gridGapCmOf(axis);
}

// Home corner to the FAR edge of the last block. Vertical 23.9 x 41.0 cm,
// horizontal 18.2 x 36.9 - both wider than the holder travel, by the half
// block that hangs off each end.
float gridBlockEndCmOf(uint8_t axis, long count)
{
  if (count < 0)
  {
    return gridLatticeStartCmOf(axis);
  }
  return cellCentreCmOf(axis, count) + gridBlockCmOf(axis) * 0.5;
}

// Near edge of cell 0.
float gridBlockStartCmOf(uint8_t axis, long count)
{
  (void)count;
  return gridSlotBottomCmOf(axis, 0);
}

// Blocks plus the gaps between them.
float gridBlockFootprintCmOf(uint8_t axis, long count)
{
  if (count < 0)
  {
    return 0.0;
  }
  return gridBlockEndCmOf(axis, count) - gridBlockStartCmOf(axis, count);
}

// Kept as the name the reports use.
float gridAllocationCmOf(uint8_t axis, long count)
{
  return gridBlockEndCmOf(axis, count);
}

float gridAllocationStartCmOf(uint8_t axis, long count)
{
  (void)count;
  return gridLatticeStartCmOf(axis);
}

// `count` is the HIGHEST INDEX the grid uses, so 0 is a legal one-slot axis.
bool gridGeometryFitsRaw(uint8_t axis, long count)
{
  if (count < 0 || xyStepsPerCmOf(axis) <= 0.0
      || gridBlockCmOf(axis) <= 0.0 || gridGapCmOf(axis) < 0.0)
  {
    return false;
  }
  const float slack = 0.0001;
  float travelCm = xyTravelCmOf(axis);
  float firstCentre = gridSlotBottomCmOf(axis, 0) + gridBlockCmOf(axis) * 0.5;
  float lastCentre = gridSlotBottomCmOf(axis, count) + gridBlockCmOf(axis) * 0.5;

  // Half one: the holder must be able to reach every placement centre.
  if (firstCentre < -slack || lastCentre > travelCm + slack)
  {
    return false;
  }

  // Half two: and the BLOCKS those centres carry must land on the machine.
  // The centre test alone is not enough. A held block naturally extends past
  // the holder-centre envelope, so "the centre is legal" accepts a grid whose
  // far block hangs off the end - which is what a positive X trim on the
  // horizontal grid would produce, pushing its last column edge past the X
  // limit from a perfectly legal centre.
  // Each mode therefore declares how much edge overhang it will tolerate.
  float overhang = gridMaxEdgeOverhangCmOf(axis);
  if (overhang < 0.0)
  {
    return false;
  }
  float nearEdge = gridBlockStartCmOf(axis, count);
  float farEdge = gridBlockEndCmOf(axis, count);
  return nearEdge >= -overhang - slack && farEdge <= travelCm + overhang + slack;
}

// Error offsets correct placement, but must not resize or reject the grid.
// Check the requested lattice against its physical geometry without the
// calibration nudge; cellTargetPosition() still applies the nudge to B/G.
bool gridGeometryFits(uint8_t axis, long count)
{
  float *error = (axis == AXIS_X) ? &GRID_ERROR_OFFSET_X_CM[gridMode]
                                  : &GRID_ERROR_OFFSET_Y_CM[gridMode];
  float saved = *error;
  *error = 0.0;
  bool result = gridGeometryFitsRaw(axis, count);
  *error = saved;
  return result;
}

// The highest INDEX this axis can carry. -1 means not even slot 0 fits.
long gridCountMaxOf(uint8_t axis)
{
  float pitch = gridPitchCmOf(axis);
  if (xyTravelCmOf(axis) <= 0.0 || pitch <= 0.0)
  {
    return -1;
  }
  long plausible = (long)ceil((xyTravelCmOf(axis)
                              + 2.0 * fabs(gridTrimCmOf(axis))
                              + 2.0 * pitch) / pitch);
  long maximum = -1;
  for (long index = 0; index <= plausible; index++)
  {
    if (gridGeometryFits(axis, index))
      maximum = index;
  }
  return maximum;
}

// gridGeometryFits / gridCountMaxOf evaluated with this mode's GRID_SHIFT_*
// momentarily removed. S and the R/RR mode latch judge the PHYSICAL grid -
// "does the size the operator asked for fit the travel at all" - and must not
// be blocked or unblocked by whatever shift is applied at the moment; the live
// shift then clips the usable range in gridColsNow()/gridRowsNow(). The value
// is restored on every path (including the false branch), so this reads the
// geometry without leaving the shift disturbed.
bool physicalGridGeometryFits(uint8_t axis, long count)
{
  float *slot = (axis == AXIS_X) ? &GRID_SHIFT_X_CM[gridMode]
                                 : &GRID_SHIFT_Y_CM[gridMode];
  float saved = *slot;
  *slot = 0.0;
  bool result = gridGeometryFits(axis, count);
  *slot = saved;
  return result;
}

long physicalGridCountMaxOf(uint8_t axis)
{
  float *slot = (axis == AXIS_X) ? &GRID_SHIFT_X_CM[gridMode]
                                 : &GRID_SHIFT_Y_CM[gridMode];
  float saved = *slot;
  *slot = 0.0;
  long result = gridCountMaxOf(axis);
  *slot = saved;
  return result;
}

// Centre of cell `index` (0-based), measured from the home switch corner.
// Cell 0's CENTRE is the home corner itself, so the whole model is one line.
//   vertical   X: 0, 3.8, 7.6, 11.4, 15.2, 19.0, 22.8   (22.8 = the X cap)
//   vertical   Y: 0, 7.6, 15.2, 22.8, 30.4, 38.0        (38.0 = the Y cap)
//   horizontal X: 1.9, 9.5, 17.1                        (the +1.9 registration)
//   horizontal Y: 1.9, 5.7, 9.5 ... 36.1                (the +1.9 registration)
float cellCentreCmOf(uint8_t axis, long index)
{
  return gridTrimCmOf(axis) + (float)index * gridPitchCmOf(axis);
}

float toolOffsetCmOf(uint8_t axis, int8_t rotation)
{
  if (rotation == ROT_CW)
  {
    return (axis == AXIS_X) ? TOOL_OFFSET_CW_X_CM : TOOL_OFFSET_CW_Y_CM;
  }
  if (rotation == ROT_CCW)
  {
    return (axis == AXIS_X) ? TOOL_OFFSET_CCW_X_CM : TOOL_OFFSET_CCW_Y_CM;
  }
  return (axis == AXIS_X) ? TOOL_OFFSET_NEUTRAL_X_CM
                          : TOOL_OFFSET_NEUTRAL_Y_CM;
}

// Convert a desired block centre to a holder position.  The target is refused
// rather than clipped if the calibrated tool offset would put the holder out
// of travel: clipping would silently place a block in the wrong cell.
bool cellTargetPosition(uint8_t axis, long index, int8_t rotation,
                        long *targetPosition)
{
  float holderCm = cellCentreCmOf(axis, index) - toolOffsetCmOf(axis, rotation);
  float travelCm = xyTravelCmOf(axis);
  float scale = xyStepsPerCmOf(axis);
  const float slack = 0.0001;

  if (holderCm < -slack || holderCm > travelCm + slack || scale <= 0.0)
  {
    return false;
  }

  long mag = lround(holderCm * scale);
  long travel = gridTravelOf(axis);
  if (mag < 0 || mag > travel)
  {
    return false;
  }

  *targetPosition = axisPosFromHomeSteps(axis, mag);
  return true;
}

// Centre-to-centre pitch in steps. One number per axis: every lattice here is
// uniform.
float gridPitchStepsOf(uint8_t axis)
{
  return gridPitchCmOf(axis) * xyStepsPerCmOf(axis);
}

// Which physical block footprint the HOLDER/tool position falls in. Adding the
// active tool offset converts the holder counter back into the actual
// placement-centre frame.
//
// Returns GRID_INDEX_NONE for a position in a gap or off the grid entirely.
// That sentinel is -1 rather than 0, because 0 is a REAL cell now - the feeder
// - and reporting "in a gap" as "on the feeder" would be a lie the operator
// could act on.
//
// A scan, not a division: the horizontal Y lattice has no single pitch to
// divide by. Eleven float compares on a MEGA is nothing, and it is the same
// code for both the uniform and the alternating axes.
long positionToIndex(uint8_t axis, long pos, int8_t rotation)
{
  long count = gridCountOf(axis);
  long mag = axisStepsFromHome(axis, pos); // distance from home
  float scale = xyStepsPerCmOf(axis);

  if (mag < 0 || mag > gridTravelOf(axis) || scale <= 0.0)
  {
    return GRID_INDEX_NONE;
  }

  float cm = (float)mag / scale + toolOffsetCmOf(axis, rotation);
  float halfStepCm = 0.5 / scale;
  float block = gridBlockCmOf(axis);

  for (long index = 0; index <= count; index++)
  {
    float bottom = gridSlotBottomCmOf(axis, index);
    if (cm < bottom - halfStepCm)
    {
      return GRID_INDEX_NONE; // past it already: we are in the gap below
    }
    if (cm <= bottom + block + halfStepCm)
    {
      return index;
    }
  }
  return GRID_INDEX_NONE;
}

bool gridReady()
{
  if (!softEnabledOn(AXIS_X) || !softEnabledOn(AXIS_Y))
  {
    Serial.println(F("  ERROR - grid needs BOTH software limits enabled"));
    Serial.println(F("  and non-zero. Check SECTION 6B."));
    return false;
  }
  if (!gridGeometryFits(AXIS_X, gridColsNow())
      || !gridGeometryFits(AXIS_Y, gridRowsNow()))
  {
    Serial.println(F("  ERROR - grid placement centres/trim do not fit the X/Y holder travel."));
    Serial.println(F("  Check SECTION 6B/6C and send 5 for the calculated geometry."));
    return false;
  }
  return true;
}

// ============================================================
// THE FEEDER
// ============================================================
//
// The feeder does not rotate. A block is always presented STANDING, on the
// VERTICAL [0,0] footprint, whichever grid is latched.
//
// And because the lattice is CENTRE-anchored, vertical [0,0]'s centre IS the
// home corner: picking up is a plain home, with no move out to a cell centre
// afterwards. (An edge-anchored draft of this file walked out to (1.1, 3.0)
// after homing - that was wrong, and it would have gripped every block 1.1 cm
// off along X and 3.0 cm off along Y.)
//
// The claw closes on the middle of the block, which is its centre, so the
// neutral tool offset is genuinely zero rather than merely unmeasured.

bool goToFeeder()
{
  return goToOrigin();
}

// [0,0] is the FEEDER in both modes and is never built on; every other cell,
// including the rest of row 0 and column 0, is a real placement.
bool cellIsFeeder(long col, long row)
{
  return col == 0 && row == 0;
}

// 0 is a real coordinate AND a real block footprint. It no longer means
// "leave that axis alone" - B 0 3 and B 4 0 are ordinary placements now.
bool cellInRange(long col, long row)
{
  if (col < 0 || col > gridColsNow() || row < 0 || row > gridRowsNow())
  {
    Serial.print(F("  ERROR - out of range. Valid: col 0.."));
    Serial.print(gridColsNow());
    Serial.print(F(", row 0.."));
    Serial.println(gridRowsNow());
    return false;
  }
  return true;
}

void setGridSize(long cols, long rows)
{
  Serial.println();

  if (!clawRotationKnown)
  {
    Serial.println(F("  ERROR - claw is at an arbitrary manual A angle."));
    Serial.println(F("  S needs a calibrated 0/+90/-90 angle; run B first."));
    return;
  }

  // These are HIGHEST INDEX, not counts, so 0 is a legal (single-cell) axis.
  // Judged against the PHYSICAL grid (shift removed): S stores the requested
  // size and a live shiftX/shiftY clips what gridColsNow()/gridRowsNow() report,
  // so a shift must not be able to reject a size that genuinely fits the rig.
  if (cols < 0 || rows < 0 ||
      cols > physicalGridCountMaxOf(AXIS_X) || rows > physicalGridCountMaxOf(AXIS_Y) ||
      !physicalGridGeometryFits(AXIS_X, cols) || !physicalGridGeometryFits(AXIS_Y, rows))
  {
    Serial.print(F("  ERROR - highest col index must be 0.."));
    Serial.print(physicalGridCountMaxOf(AXIS_X));
    Serial.print(F(" and highest row index 0.."));
    Serial.print(physicalGridCountMaxOf(AXIS_Y));
    Serial.println(F("."));
    return;
  }

  // Scoped to the ACTIVE mode: the other orientation keeps whatever count it
  // was last given, so latching back and forth does not quietly resize it.
  GRID_COLS[gridMode] = cols;
  GRID_ROWS[gridMode] = rows;

  // Old cell numbers no longer mean the same thing.
  curCol = positionToIndex(AXIS_X, axisPos[AXIS_X], clawRotation);
  curRow = positionToIndex(AXIS_Y, axisPos[AXIS_Y], clawRotation);

  Serial.println(F("GRID RESIZED"));
  printGridConfig();
}

// ============================================================
// GRID MODE LATCH                                      <<< NEW
// ============================================================
//
//   RR  latches vertical -> horizontal
//   R   latches horizontal -> vertical
//
// THIS IS A LATCH, NOT A MOTION. Neither command moves the aux stepper.
// They used to: R and RR were a free 90-degree jog of the claw. That jog is
// gone, because the build cycle already owns claw rotation completely - step 3
// returns to neutral before the pick, step 9 applies the placement rotation,
// step 14 returns to neutral again. Anything a latch did to the claw would be
// undone by the very next build's step 3, so it could only ever look like a
// bug. What these commands change is which GRID the coordinates refer to.
//
// Each command is refused when it is already true: RR in horizontal and R in
// vertical are errors, not no-ops. A latch that silently accepts the state it
// is already in cannot tell a confirmation apart from a mistake.
//
// A mode switch redefines what every coordinate means, so it is also refused
// unless X and Y are homed - curCol/curRow would otherwise be re-read from a
// position whose meaning nobody knows.
//
// NOTHING SENSES THE CLAW'S PHYSICAL ANGLE. The operator is trusted to have
// started with the claw neutral; see SECTION 6C.

bool setGridMode(uint8_t mode)
{
  Serial.println();

  if (mode >= GRID_MODE_COUNT)
  {
    Serial.println(F("  ERROR - unknown grid mode."));
    return false;
  }

  if (mode == gridMode)
  {
    Serial.print(F("  ERROR - already in "));
    Serial.print(gridModeName(gridMode));
    Serial.println(F(" mode."));
    Serial.println(F("  RR selects horizontal, R selects vertical."));
    return false;
  }

  if (!axisHomed[AXIS_X] || !axisHomed[AXIS_Y])
  {
    Serial.println(F("  ERROR - home X/Y first (send 0)."));
    Serial.println(F("  A mode switch redefines every coordinate, so the"));
    Serial.println(F("  current cell has to mean something before it is re-read."));
    return false;
  }

  if (!clawRotationKnown)
  {
    Serial.println(F("  ERROR - claw is at an arbitrary manual A angle."));
    Serial.println(F("  Latching a grid needs a calibrated 0/+90/-90 angle; run B first."));
    return false;
  }

  uint8_t previous = gridMode;
  gridMode = mode;

  // The other mode's counts and trims are now live. If its REQUESTED size does
  // not physically fit (judged with that mode's shift removed), say so and stay
  // where we were rather than latching into an unusable grid. A shift that only
  // clips the far column/row is fine - gridColsNow()/gridRowsNow() absorb it.
  if (!physicalGridGeometryFits(AXIS_X, GRID_COLS[gridMode])
      || !physicalGridGeometryFits(AXIS_Y, GRID_ROWS[gridMode]))
  {
    gridMode = previous;
    Serial.print(F("  ERROR - the "));
    Serial.print(gridModeName(mode));
    Serial.println(F(" grid does not fit the X/Y travel."));
    Serial.println(F("  Staying in the current mode. Check SECTION 6C, send 5."));
    return false;
  }

  // Every old cell number was measured against the other grid's pitch.
  curCol = positionToIndex(AXIS_X, axisPos[AXIS_X], clawRotation);
  curRow = positionToIndex(AXIS_Y, axisPos[AXIS_Y], clawRotation);

  Serial.print(F("GRID MODE: "));
  Serial.print(gridModeName(previous));
  Serial.print(F("  ->  "));
  Serial.println(gridModeName(gridMode));
  Serial.println(F("  The claw did NOT move. The next B turns it at the feeder."));
  printGridConfig();
  return true;
}

// ============================================================
// GRID SHIFT LATCH                                    <<< NEW
// ============================================================
//
//   shiftX <cm> / shiftY <cm>  translate the ACTIVE mode's whole placement
//   lattice - every cell centre, every block edge, and the [0,0] reference the
//   lattice is anchored on - by <cm> along that axis. + is away from the home
//   switch, the same sense as the trims. It is per mode and it is stored in
//   GRID_SHIFT_*_CM, which gridTrimCmOf() folds into the lattice.
//
//   IT MOVES NOTHING and it does NOT touch the pick-up. A build picks up with a
//   plain home to raw [0,0] (goToFeeder -> goToOrigin), which runs no lattice
//   math, so phases 1-7 happen on the un-shifted grid and only the PLACEMENT
//   (phase 8 onward, via cellTargetPosition -> cellCentreCmOf) rides the shift.
//   [0,0] stays the feeder and the inert B 0 0 no-op in both modes.
//
//   The reachable range is recomputed: gridColsNow()/gridRowsNow() clip the
//   requested GRID_COLS/GRID_ROWS to whatever still fits the X/Y travel under
//   the shift, so a shift that pushes the far column/row past the cap simply
//   drops it (shiftX/shiftY 0 brings it back). A shift that leaves not even
//   cell 0 on the machine is refused and the previous value restored.

// A signed decimal number of centimetres: optional +/-, digits, optional
// fractional part. Leading separators are tolerated (the caller passes the
// slice right after the axis letter); a trailing non-space is an error.
bool parseSignedCm(const char *s, float *out)
{
  uint8_t i = 0;
  while (s[i] == ' ' || s[i] == '\t' || s[i] == ',' || s[i] == ':' || s[i] == '=')
  {
    i++;
  }

  bool negative = false;
  if (s[i] == '+' || s[i] == '-')
  {
    negative = (s[i] == '-');
    i++;
  }

  bool sawDigit = false;
  float value = 0.0;
  while (s[i] >= '0' && s[i] <= '9')
  {
    value = value * 10.0 + (float)(s[i] - '0');
    sawDigit = true;
    i++;
  }
  if (s[i] == '.')
  {
    i++;
    float place = 0.1;
    while (s[i] >= '0' && s[i] <= '9')
    {
      value += (float)(s[i] - '0') * place;
      place *= 0.1;
      sawDigit = true;
      i++;
    }
  }

  if (!sawDigit)
  {
    return false;
  }
  while (s[i] == ' ' || s[i] == '\t')
  {
    i++;
  }
  if (s[i] != '\0')
  {
    return false;
  }

  *out = negative ? -value : value;
  return true;
}

// Set the ACTIVE mode's shift on `axis` to `cm` absolute (cm == 0 clears it).
// Refuses - and restores the previous value - if the result leaves no cell on
// the X/Y travel. Never moves the machine.
void applyGridShift(uint8_t axis, float cm)
{
  Serial.println();
  ackSeq++;

  if (!clawRotationKnown)
  {
    Serial.println(F("  ERROR - claw is at an arbitrary manual A angle."));
    Serial.println(F("  shiftX/shiftY needs a calibrated 0/+90/-90 angle; run B first."));
    ackReason(F("ERR"), F("claw angle uncalibrated"));
    return;
  }

  float *slot = (axis == AXIS_X) ? &GRID_SHIFT_X_CM[gridMode]
                                 : &GRID_SHIFT_Y_CM[gridMode];
  float previous = *slot;
  *slot = cm;

  if (gridCountMaxOf(AXIS_X) < 0 || gridCountMaxOf(AXIS_Y) < 0)
  {
    *slot = previous;
    Serial.print(F("  ERROR - a "));
    Serial.print(cm, 3);
    Serial.print(F(" cm "));
    Serial.print((axis == AXIS_X) ? F("X") : F("Y"));
    Serial.println(F(" shift leaves no cell on the X/Y travel. Reverted."));
    ackReason(F("SAFE"), F("shift makes the grid unusable"));
    return;
  }

  // Old cell numbers were measured against the un-shifted lattice.
  curCol = positionToIndex(AXIS_X, axisPos[AXIS_X], clawRotation);
  curRow = positionToIndex(AXIS_Y, axisPos[AXIS_Y], clawRotation);

  Serial.print(F("GRID SHIFT ["));
  Serial.print(gridModeName(gridMode));
  Serial.print(F("] "));
  Serial.print((axis == AXIS_X) ? F("X") : F("Y"));
  Serial.print(F("  "));
  Serial.print(previous, 3);
  Serial.print(F(" -> "));
  Serial.print(cm, 3);
  Serial.println(F(" cm   (pick-up NOT shifted; applied from [0,0])"));

  long req = (axis == AXIS_X) ? GRID_COLS[gridMode] : GRID_ROWS[gridMode];
  long eff = (axis == AXIS_X) ? gridColsNow() : gridRowsNow();
  if (eff < req)
  {
    Serial.print(F("  highest "));
    Serial.print((axis == AXIS_X) ? F("col") : F("row"));
    Serial.print(F(" index clipped to "));
    Serial.print(eff);
    Serial.print(F(" of "));
    Serial.print(req);
    Serial.print(F(" requested  (shift"));
    Serial.print((axis == AXIS_X) ? F("X") : F("Y"));
    Serial.println(F(" 0 restores it)"));
  }

  printGridConfig();
  ackReason(F("OK"), F("grid shifted"));
}

// Parse "shiftX <cm>" / "shiftY <cm>" (any case) and apply it. `line` is the
// whole command line; the caller has already checked it begins "sh".
void handleShiftCommand(const char *line)
{
  const char *tag = "SHIFT";
  for (uint8_t i = 0; i < 5; i++)
  {
    if (toUpperChar(line[i]) != tag[i])
    {
      statBadCommands++;
      Serial.println();
      Serial.println(F("  ERROR - use:  shiftX <cm>   or   shiftY <cm>"));
      return;
    }
  }

  char axisChar = toUpperChar(line[5]);
  uint8_t axis;
  if (axisChar == 'X')
  {
    axis = AXIS_X;
  }
  else if (axisChar == 'Y')
  {
    axis = AXIS_Y;
  }
  else
  {
    statBadCommands++;
    Serial.println();
    Serial.println(F("  ERROR - use:  shiftX <cm>   or   shiftY <cm>   (axis must be X or Y)"));
    return;
  }

  float cm = 0.0;
  if (!parseSignedCm(line + 6, &cm))
  {
    statBadCommands++;
    Serial.println();
    Serial.println(F("  ERROR - use:  shiftX <cm>   e.g.  shiftX 1.6   shiftY -0.8   shiftX 0"));
    return;
  }

  applyGridShift(axis, cm);
}

// ============================================================
// GO TO CELL
// ============================================================
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
void loop()
{
  buildTestV1Loop();
}
