ahmedjk34/hardware-grad-project/python/vision/color_grid.py

#!/usr/bin/env python3
"""Find the printed two-colour calibration sheet and turn it into a grid.

Why this exists
---------------
Clicking four envelope corners by hand (``rig/workspace.py``) asks an operator
to guess where an invisible rectangle is, on a lens that still bows slightly
after correction. The printed sheet replaces the guess with something the
camera can measure: one alternating green/magenta block per grid cell, printed
at the rig's real ``2.2 x 7.5 cm`` block footprint with the real ``0.5 cm``
gap between neighbours. Every cell edge is then a measurement, and a hundred of
them are averaged into one homography instead of four clicks being trusted
absolutely.

The detector is deliberately independent of a camera, a window and the rig. It
takes a BGR frame and returns geometry. ``camera/color_grid_check.py`` drives
it live, the gridded feed and Rig Build V1 use it for their overlay and their
calibrate button, and the tests run it on still captures.

What "full cell" means, and why partials are dropped
----------------------------------------------------
The sheet is printed larger than the machine's grid, so the camera always sees
cells that run off the edge of the paper or the edge of the frame. Those are
**not** part of the project: their centres are wrong, their sizes are wrong,
and feeding them to the homography drags the whole map. So every detected
block is scored against the size the current lattice predicts for it, and only
blocks that are essentially whole (:data:`FULL_CELL_FILL`) are allowed to
define geometry. The outer white margin of the sheet is likewise never
measured — it is simply whatever lies beyond the last full cell.

How the lattice is found
------------------------
0. The frame is white balanced. This is not cosmetic — see :func:`white_balance`
   for the live frame where skipping it made every green cell invisible.
1. Two hue windows segment green and magenta. Their union is "some cell".
2. Each connected component becomes a rotated rectangle. Plausible cell shapes
   establish the median size and long-axis direction; scene-coloured rails and
   walls remain visible diagnostics but cannot steer the geometry.
3. Breadth-first walks are tried from every plausible seed. Each walk uses the
   current cell's own measured size and the known pitch/block ratio, then a
   provisional homography recovers physical cells beyond missed local hops.
   Hypotheses are ranked by coverage, colour parity and residual.
4. A homography is fitted from integer lattice indices to cell centres, every
   cell is re-scored against it, and the fit is repeated on the survivors.
   Parity, aspect and normalized residual gates refuse a plausible-looking but
   unsafe result.

Steps 3 and 4 are the whole trick. Residuals on the two supplied captures are
around one pixel at 2048 px wide, including the badly tilted one.

Which axis is X
---------------
Never from the image. The ``2.2 cm`` side and the ``7.5 cm`` side are 3.4:1
apart, so the axis with the shorter pitch is the machine's X and the other is
Y, whichever way round the sheet was photographed. That much is orientation
free and is what makes the module reusable when the camera is remounted.

The sheet may describe either calibrated machine layout.  In vertical mode the
machine X side is the short block side; in horizontal mode it is the long one.
The mode is an explicit input — the detector never guesses it from a partial
sheet — and the complete coordinate counts cross-check that the sheet and the
machine grid agree.  See ``docs/dual-orientation-grid.md`` D18.
"""

from __future__ import annotations

from dataclasses import dataclass, field, replace
import math

import cv2
import numpy as np

from rig.config import (GRID_MODES, active_grid_mode, grid_geometry,
                        load as load_rig_config)


# The sheet is printed at the rig's own block geometry, so the ratio between a
# block and its pitch is fixed and known. Everything below is expressed in
# those ratios rather than in centimetres, which keeps the detector working at
# any camera distance without a scale calibration.  These are machine layouts,
# not camera rotations: a quarter-turned photograph is valid in either mode.
SUPPORTED_LAYOUTS = {
    "vertical": "y-along-block-length",
    "horizontal": "x-along-block-length",
}
# Compatibility name for callers that only ever dealt with the original sheet.
SUPPORTED_LAYOUT = SUPPORTED_LAYOUTS["vertical"]

# Hue windows, in OpenCV's 0..179 space, applied AFTER the white balance below.
# The training captures put green at 80-88 and magenta at 150-162. A live rig
# frame under a heavy magenta cast puts the same inks at 101 and 155 once
# balanced, and at 120 and 153 if it is not — which is how a green cell ends up
# looking cyan and vanishing. The windows are sized for the balanced range with
# room to spare, and the two never touch.
GREEN_HUE = (58, 115)
MAGENTA_HUE = (130, 178)

# Saturation floor. The rig's own lighting can leave the green ink at 48 while
# white paper sits at 15, so the floor lives between those rather than at the
# 50 the studio captures allowed. Anything below it is paper, not ink.
MIN_SATURATION = 32
MIN_VALUE = 40

# Shadow fallback in raw, normalized BGR chromaticity.  Multiplying a patch by
# an illumination gain changes neither score, unlike an absolute Value cutoff.
# The thresholds are conservative because this mask is ORed with HSV: it exists
# to reconnect ink at a dark edge, while the lattice/shape gates reject rails
# and other similarly coloured scene objects.
GREEN_OPPONENT_MIN = 0.035
MAGENTA_OPPONENT_MIN = 0.055
GREEN_CHANNEL_SPREAD_MIN = 10
MAGENTA_CHANNEL_SPREAD_MIN = 12

# Channel-ordering classifier, for an uncorrected rig camera where the yellow
# cast has pulled the paper and the green ink to nearly the same hue AND left
# the paper more saturated than the ink, so neither a hue window nor a
# saturation floor can separate them. What still holds under any single global
# cast is the ORDER of the channels: the green ink is the only material whose
# green channel is the largest; magenta is the only one whose green channel is
# the smallest with both others clearly above it. Margins are in 8-bit counts.
CHANNEL_ORDER_GREEN_MARGIN = 4
CHANNEL_ORDER_MAGENTA_B_MARGIN = 6
CHANNEL_ORDER_MAGENTA_R_MARGIN = 4

# The bright quantile that :func:`white_balance` drives to neutral. High enough
# to land on the sheet's white paper, low enough not to chase one specular
# highlight. Estimated on a subsampled frame; the scaling is applied to all of it.
WHITE_PATCH_QUANTILE = 0.92
_BALANCE_STRIDE = 8
_BALANCE_DEADBAND = 0.02        # below this the cast is not worth a pass over the frame

# Illumination flattening: divide the frame by a heavily blurred copy of itself,
# per channel, then re-mean. This removes the low-frequency part of a colour
# cast AND lens vignetting in one pass, which is what lets ink survive on the
# rig camera, where an uncorrected yellow cast leaves the paper MORE saturated
# than the green ink and at nearly the same hue. It is a coarse stand-in for a
# real `colourcal` matrix, not a replacement for one.
_FLATTEN_BLUR_FRACTION = 0.18   # sigma as a fraction of the short frame side
_FLATTEN_MIN_SIGMA = 9.0

# A block whose observed area is at least this fraction of the area the lattice
# predicts for it is whole. The captures put real cells at 0.93-1.03 and every
# clipped one below 0.7, so the cutoff is nowhere near either population.
FULL_CELL_FILL = 0.80
MAX_FULL_CELL_FILL = 1.35

# Seeds for the lattice walk must be this close to the median cell size. Only
# used to pick cells that are allowed to *propagate*; the real full/partial
# decision is made later against the fitted lattice.
SEED_SIZE_TOLERANCE = 0.28

# Raw hue masks on the live rig also contain rails, cables and parts of the
# wall.  They remain useful diagnostics, but they must not vote on the grid's
# dominant direction or median cell size.  These deliberately broad limits are
# only a pre-lattice plausibility filter; perspective-aware footprint scoring
# below makes the final whole/partial decision.
LATTICE_ASPECT_RANGE = (1.65, 7.0)
LATTICE_AREA_RANGE = (0.35, 2.8)
MIN_COLOR_PURITY = 0.65

# How far from the predicted position a neighbour may sit, as a fraction of the
# smaller pitch. Generous enough for a tilted sheet, far below half a pitch so
# it can never grab the cell after next.
NEIGHBOUR_TOLERANCE = 0.40

# Once one connected patch establishes a homography, project every other
# plausible component back into lattice space.  This reconnects real cells
# beyond a locally missed hop without inventing covered cells: only physical
# colour components close to an integer site are admitted.
RECOVERY_TOLERANCE = 0.34
RECOVERY_FILL_RANGE = (0.55, 1.45)
RECOVERY_PASSES = 3

# A complete rectangle is necessary but not sufficient for a calibration.
# These gates keep a regular-looking collection of scene clutter, a badly bowed
# lens fit, or a broken chessboard parity from becoming a workspace map.
MIN_PARITY_AGREEMENT = 0.95
VALID_ASPECT_FACTOR = (0.58, 1.75)
MAX_MEAN_RESIDUAL_SHORT_SIDE = 0.12
MAX_RESIDUAL_SHORT_SIDE = 0.45

# Working width for detection. The homography is fitted over ~100 cells, so
# sub-pixel loss from the downscale averages out, and this keeps a live overlay
# affordable on the Pi. Pass ``process_width=0`` to work at full resolution.
DEFAULT_PROCESS_WIDTH = 1024

# How much clear space a whole cell must keep between its own projected edge and
# the frame border, as a fraction of that cell's own projected size. A cell that
# comes closer than this - or crosses the border - is treated as clipped and can
# neither anchor the fit nor count toward a window's coverage. The default is
# deliberately aggressive: a sheet photographed to the frame edge loses its
# outermost ring rather than calibrating off half-visible blocks. Pass
# ``edge_margin=0`` to keep only the hard "contour actually overruns" test.
DEFAULT_EDGE_MARGIN = 0.5

# Upper bound on how many overlapping mode-sized windows a single detection
# offers the operator to cycle through. They are ranked bottom-left-first, so
# the cut only drops the farthest, least likely alternatives.
MAX_WINDOWS = 16

# A single evidence frame is allowed to have gantry-shaped holes.  Twelve
# cells is enough to establish both lattice axes and reject scene clutter; it
# is deliberately *not* enough to save a workspace map on its own.  That
# decision belongs to PaperGridEvidence, which combines accepted frames and
# applies coverage gates before a map can be written.
MIN_EVIDENCE_FRAME_FRACTION = 0.20


def min_evidence_frame_cells(spec) -> int:
    """Whole cells needed to fit one evidence frame for this sheet layout."""
    return math.ceil(MIN_EVIDENCE_FRAME_FRACTION * spec.cols * spec.rows)

# A mode-sized window may lose one or two cells to a lighting falloff at the
# edge of the sheet without losing its geometry: the homography is supported by
# the rest of the larger lattice.  This is deliberately much stricter than the
# evidence mode.  Every row and column must still contain observations, and
# nearly all of each.  ``_choose_windows`` returns every window that clears this
# on both axes; the frame-border ``edge_margin`` (below) is what stops a
# half-visible outer ring from anchoring one.
MIN_WINDOW_COVERAGE = 0.95

# A cell can remain plainly visible while a fixed colour threshold captures
# only part of its ink.  This happens in the live rig capture on the dim side
# of the sheet: magenta fills remain near 100%, while valid green fills fall as
# low as 24% (and to roughly 2% in the deliberately severe shadow regression).
# Such a fragment must not steer the homography (its contour centre can be
# biased), but pixels of the expected chessboard colour inside a
# homography-predicted footprint are still evidence that the physical cell
# exists.  This is only a coverage vote inside an already fitted lattice: the
# window still needs 95% support and paper/gantry occlusions contribute zero.
MIN_PREDICTED_INK_COVERAGE = 0.015

# How far a blob's long/short ratio may sit from the printed 3.41 and still be
# treated as a cell. Only used when sampling colour, where there is no lattice
# to fall back on and a mis-sampled wall would silently poison a calibration.
SHEET_ASPECT_RANGE = (2.2, 5.2)

MIN_COMPONENT_AREA = 250
_OPEN_KERNEL = np.ones((3, 3), np.uint8)


class ColorGridError(Exception):
    """The sheet could not be turned into a usable grid.

    Carries whatever geometry the failed attempt did produce. A tool that shows
    nothing at all when detection fails is the hardest possible thing to debug —
    "no overlay" looks identical whether the sheet is out of frame, the colours
    are wrong, or the code never ran. ``candidates`` lets the checker draw the
    colour blobs it did find, and ``stage`` says how far it got.
    """

    def __init__(self, message, *, stage="detect", candidates=(), lattice=(),
                 calibration=None):
        super().__init__(message)
        self.stage = stage
        self.candidates = tuple(candidates)   # Nx4x2 boxes, input-frame pixels
        self.lattice = tuple(lattice)         # the subset that joined a lattice
        # Orientation can fail only *after* a sound geometric calibration and
        # all internal stripes have been decoded.  Keeping that non-authorized
        # calibration on the exception lets diagnostic tools annotate the
        # conflicting signatures without accidentally returning it as usable.
        self.calibration = calibration


@dataclass(frozen=True)
class ColorGridSpec:
    """The printed sheet's geometry, which is the rig's block geometry.

    ``cols``/``rows`` are the *complete* coordinate map including zero — 7 x 6
    in vertical mode and 3 x 10 in horizontal — because the sheet prints a real
    block at every coordinate, coordinate zero included. The machine counts the
    same cells; the two differ only over which part of cell [0,0] the home
    corner sits on, which is why the mapping back onto the machine envelope is
    an explicit convention rather than an assumption.
    See :meth:`ColorGridCalibration.workspace_corners`.

    The gaps are a uniform 1.6 cm on both axes: a vertical block reads
    2.2 + 1.6 + 2.2 along its 6.0 cm length and consecutive blocks are also
    1.6 apart, so the 2.2 cm sub-cells repeat at one unbroken 3.8 cm pitch.
    Measured off the printed sheet - tiles 6.00 cm, gaps 1.56 cm, identical on
    both axes. Keep paired with config/rig.json.
    """

    cols: int = 7
    rows: int = 6
    block_x_cm: float = 2.2
    block_y_cm: float = 6.0
    gap_x_cm: float = 1.6
    gap_y_cm: float = 1.6
    mode: str = "vertical"

    @classmethod
    def from_config(cls, cfg: dict | None = None, mode: str | None = None) -> "ColorGridSpec":
        """Build one mode's printed map from ``config/rig.json``.

        ``mode`` is deliberately explicit at this seam.  A partial sheet does
        not contain enough information to infer a layout safely, while a UI
        already knows which machine grid it is calibrating.
        """
        cfg = cfg if cfg is not None else load_rig_config()
        name = active_grid_mode(cfg) if mode is None else str(mode)
        grid = grid_geometry(cfg, name)
        return cls(
            # No +1: the machine grid counts a real block at coordinate zero,
            # exactly as the sheet prints one, so the two counts agree outright.
            cols=int(grid["cols"]),
            rows=int(grid["rows"]),
            block_x_cm=float(grid["block_x_cm"]),
            block_y_cm=float(grid["block_y_cm"]),
            gap_x_cm=float(grid["gap_x_cm"]),
            gap_y_cm=float(grid["gap_y_cm"]),
            mode=name,
        )

    def __post_init__(self):
        values = (self.block_x_cm, self.block_y_cm, self.gap_x_cm, self.gap_y_cm)
        if not all(math.isfinite(v) and v > 0 for v in values[:2]):
            raise ValueError("printed block dimensions must be positive")
        if not all(math.isfinite(v) and v >= 0 for v in values[2:]):
            raise ValueError("printed gaps must be finite and non-negative")
        if self.cols < 2 or self.rows < 2:
            raise ValueError("the printed grid needs at least 2x2 coordinates")
        if self.mode not in GRID_MODES:
            raise ValueError(
                f"printed grid mode must be one of {', '.join(GRID_MODES)}, "
                f"not {self.mode!r}")
        if abs(self.block_x_cm - self.block_y_cm) < 1e-9:
            raise ValueError(
                "square cells give no way to tell the X side from the Y side"
            )

    @property
    def pitch_x_cm(self) -> float:
        return self.block_x_cm + self.gap_x_cm

    @property
    def pitch_y_cm(self) -> float:
        return self.block_y_cm + self.gap_y_cm

    @property
    def fill_x(self) -> float:
        """Block as a fraction of pitch along X: 2.2 / 3.8 (vertical)."""
        return self.block_x_cm / self.pitch_x_cm

    @property
    def fill_y(self) -> float:
        """Block as a fraction of pitch along Y: 6.0 / 6.8 (vertical)."""
        return self.block_y_cm / self.pitch_y_cm

    @property
    def short_is_x(self) -> bool:
        return self.block_x_cm < self.block_y_cm

    @property
    def layout(self) -> str:
        return SUPPORTED_LAYOUTS[self.mode]

    @property
    def lattice_counts(self) -> tuple[int, int]:
        """Required cells along the physical short and long block sides."""
        return ((self.cols, self.rows) if self.short_is_x
                else (self.rows, self.cols))

    def matches_grid(self, grid) -> bool:
        """Whether this sheet was made for exactly this machine layout."""
        return (
            self.mode == grid.mode
            and (self.cols, self.rows) == (grid.cols, grid.rows)
            and self.block_x_cm == grid.block_x_cm
            and self.block_y_cm == grid.block_y_cm
            and self.gap_x_cm == grid.gap_x_cm
            and self.gap_y_cm == grid.gap_y_cm
        )

    def describe(self) -> str:
        return (f"{self.mode} {self.cols}x{self.rows} printed coordinates, "
                f"{self.block_x_cm:g}x{self.block_y_cm:g} cm cells, "
                f"{self.gap_x_cm:g}x{self.gap_y_cm:g} cm inner margins, "
                f"pitch {self.pitch_x_cm:g}x{self.pitch_y_cm:g} cm")


@dataclass
class PrintedCell:
    """One block found on the sheet, in pixels of the frame that was passed in."""

    lattice: tuple[int, int]
    center: tuple[float, float]
    quad: np.ndarray                    # observed rotated rectangle, 4x2
    color: str                          # "green" or "magenta"
    area: float
    fill: float                         # observed area / lattice-predicted area
    full: bool
    cell: tuple[int, int] | None = None  # [col,row] once a window is chosen
    edge_clipped: bool = False           # too close to the frame border to trust


@dataclass
class ColorGridMetrics:
    input_size: tuple[int, int] = (0, 0)
    processing_size: tuple[int, int] = (0, 0)
    components: int = 0
    assigned: int = 0
    full_cells: int = 0
    lattice_shape: tuple[int, int] = (0, 0)
    residual_px: float = 0.0
    max_residual_px: float = 0.0
    parity_agreement: float = 0.0
    measured_aspect: float = 0.0
    window_candidates: int = 1
    window_index: int = 0
    window_observed: int = 0


# Where the machine's origin sits on the printed sheet. The sheet prints a real
# block at coordinate zero; the firmware treats coordinate zero as a bare point
# with only a 0.5 cm gap before cell 1. The two therefore cannot both be right,
# and picking one is a decision about the physical rig, not about the picture.
#
#   "firmware"  cells [1,1]..[9,5] on the paper land exactly on the firmware's
#               own cells. The machine envelope runs from the far corner of
#               printed [0,0] to the far corner of printed [9,5]. The printed
#               row/column-zero blocks are then only an anchor: they are not
#               where the firmware draws its axis-only lanes.
#
#   "printed"   the machine origin is the centre of printed cell [0,0], and
#               every printed cell is taken at face value. Positive cells then
#               sit half a block plus a gap further from home than the firmware
#               puts them: 1.1 cm on X and 3.75 cm on Y.
HOME_CONVENTIONS = ("firmware", "printed")
DEFAULT_HOME_CONVENTION = "firmware"


@dataclass
class ColorGridCalibration:
    """A fitted printed grid: ``[col,row]`` in, image pixels out.

    ``[0,0]`` is the cell nearest the bottom-left of the image, columns run
    along the short (X) cell side and rows along the long (Y) side. Everything
    is in pixels of the frame handed to :func:`detect_color_grid`.
    """

    spec: ColorGridSpec
    homography: np.ndarray              # [col,row,1] -> pixel, 3x3
    cells: list[PrintedCell]
    metrics: ColorGridMetrics = field(default_factory=ColorGridMetrics)
    layout: str | None = None

    def __post_init__(self):
        self.homography = np.asarray(self.homography, dtype=np.float64)
        if self.homography.shape != (3, 3):
            raise ValueError("homography must be 3x3")
        try:
            self._inverse = np.linalg.inv(self.homography)
        except np.linalg.LinAlgError as exc:
            # Degenerate rather than merely inaccurate: the cells the fit was
            # built from are collinear. Say that instead of leaking a linear
            # algebra message into an operator's status line.
            raise ColorGridError(
                "the detected cells are degenerate; the sheet is edge-on or "
                "only one row of it is in view") from exc
        if self.layout is None:
            self.layout = self.spec.layout
        elif self.layout != self.spec.layout:
            raise ValueError(
                f"printed grid layout {self.layout!r} disagrees with "
                f"the {self.spec.mode!r} sheet")

    # --- forward geometry -------------------------------------------------

    def point_at(self, col: float, row: float) -> tuple[float, float]:
        """Project continuous grid coordinates, cell centres at integers."""
        out = self.homography @ np.array([col, row, 1.0])
        if abs(out[2]) < 1e-12:
            raise ColorGridError("the printed grid mapping reaches infinity")
        return float(out[0] / out[2]), float(out[1] / out[2])

    def cell_center(self, col: int, row: int) -> tuple[float, float]:
        self._check(col, row)
        return self.point_at(col, row)

    def cell_quad(self, col: int, row: int) -> np.ndarray:
        """The printed block's four image corners, gaps excluded."""
        self._check(col, row)
        hx, hy = self.spec.fill_x / 2, self.spec.fill_y / 2
        corners = ((col - hx, row - hy), (col + hx, row - hy),
                   (col + hx, row + hy), (col - hx, row + hy))
        return np.array([self.point_at(u, v) for u, v in corners], dtype=np.float32)

    def outline(self) -> np.ndarray:
        """The four outer corners of the whole grid, no outer margin included.

        Deliberately the outer edges of the corner *blocks*, not a pitch-sized
        border: the sheet has no outer margin that belongs to the project, so
        the grid ends where the last block ends.
        """
        hx, hy = self.spec.fill_x / 2, self.spec.fill_y / 2
        c, r = self.spec.cols - 1, self.spec.rows - 1
        corners = ((-hx, -hy), (c + hx, -hy), (c + hx, r + hy), (-hx, r + hy))
        return np.array([self.point_at(u, v) for u, v in corners], dtype=np.float32)

    # --- inverse geometry -------------------------------------------------

    def grid_at(self, point) -> tuple[float, float]:
        """Pixel -> continuous grid coordinates."""
        out = self._inverse @ np.array([point[0], point[1], 1.0])
        if abs(out[2]) < 1e-12:
            raise ColorGridError("the printed grid mapping reaches infinity")
        return float(out[0] / out[2]), float(out[1] / out[2])

    def cell_at(self, point) -> tuple[int, int] | None:
        """Which printed block a pixel is on, or None for a gap/outside.

        Returns None inside the 0.5 cm inner margins on purpose: they are real
        white paper, not a rounding artefact, and reporting the nearer cell
        would quietly widen every block by a quarter of a gap.
        """
        u, v = self.grid_at(point)
        col, row = round(u), round(v)
        if not (0 <= col < self.spec.cols and 0 <= row < self.spec.rows):
            return None
        if abs(u - col) > self.spec.fill_x / 2 or abs(v - row) > self.spec.fill_y / 2:
            return None
        return col, row

    # --- mapping back onto the machine envelope ---------------------------

    def workspace_corners(self, grid, convention: str = DEFAULT_HOME_CONVENTION):
        """The four holder-envelope corners, in ``rig.workspace.CORNER_NAMES`` order.

        ``grid`` is a physically scaled :class:`rig.grid.MachineGrid`. The result
        is exactly what ``WorkspaceMap.from_grid`` wants, so a detected sheet can
        replace four clicked points without any other part of the pipeline
        learning that the sheet exists.

        See :data:`HOME_CONVENTIONS` for what the two conventions mean; they
        differ by one block plus one gap on each axis, which is the disagreement
        between a sheet that prints a block at coordinate zero and firmware that
        does not.
        """
        if convention not in HOME_CONVENTIONS:
            raise ValueError(
                f"convention must be one of {HOME_CONVENTIONS}, not {convention!r}")
        if not grid.has_physical_scale:
            raise ColorGridError("mapping to the envelope needs a scaled MachineGrid")
        self._check_geometry_matches(grid)

        # Printed-sheet centimetres, measured from the outer corner of printed
        # cell [0,0]: block `c` spans [c*pitch, c*pitch + block].
        if convention == "firmware":
            # Printed cell c coincides with firmware cell c, for every c
            # INCLUDING zero: the machine's coordinate 0 is a real block whose
            # outer edge sits on the home corner, exactly as the sheet prints
            # it. With the shipped zero trims this puts home on the outer
            # corner of printed [0,0] and the two conventions collapse to one
            # block-half apart, rather than the block-plus-gap they used to be.
            x0 = -grid.x_start_cm
            y0 = -grid.y_start_cm
        else:
            x0 = self.spec.block_x_cm / 2
            y0 = self.spec.block_y_cm / 2
        x1 = x0 + grid.workspace_width_cm
        y1 = y0 + grid.workspace_height_cm

        def to_grid(x_cm, y_cm):
            return ((x_cm - self.spec.block_x_cm / 2) / self.spec.pitch_x_cm,
                    (y_cm - self.spec.block_y_cm / 2) / self.spec.pitch_y_cm)

        corners_cm = ((x0, y0), (x1, y0), (x1, y1), (x0, y1))
        return [self.point_at(*to_grid(x, y)) for x, y in corners_cm]

    def _check_geometry_matches(self, grid):
        if self.spec.mode != grid.mode:
            raise ColorGridError(
                f"the {self.spec.mode} printed sheet cannot calibrate the "
                f"{grid.mode} machine grid; select the {grid.mode} sheet")
        # No +1 any more: the machine grid counts a real block at coordinate
        # zero, exactly as the sheet prints it, so the two agree outright.
        expected_counts = (grid.cols, grid.rows)
        if (self.spec.cols, self.spec.rows) != expected_counts:
            raise ColorGridError(
                f"the {self.spec.mode} printed sheet maps "
                f"{self.spec.cols}x{self.spec.rows} coordinates, but the "
                f"{grid.mode} machine grid requires {expected_counts[0]}x"
                f"{expected_counts[1]}")
        pairs = ((self.spec.block_x_cm, grid.block_x_cm, "block X"),
                 (self.spec.block_y_cm, grid.block_y_cm, "block Y"),
                 (self.spec.gap_x_cm, grid.gap_x_cm, "gap X"),
                 (self.spec.gap_y_cm, grid.gap_y_cm, "gap Y"))
        for printed, machine, name in pairs:
            if abs(printed - machine) > 1e-6:
                raise ColorGridError(
                    f"the sheet was detected as {name} {printed:g} cm but the rig "
                    f"config says {machine:g} cm; reprint the sheet or fix rig.json")
        if (self.spec.cols, self.spec.rows) != (grid.cols, grid.rows):
            raise ColorGridError(
                f"the sheet grid is {self.spec.cols}x{self.spec.rows} coordinates "
                f"but the rig config asks for {grid.cols}x{grid.rows}")

    # --- reporting --------------------------------------------------------

    def _check(self, col, row):
        if not (0 <= col < self.spec.cols and 0 <= row < self.spec.rows):
            raise ValueError(
                f"[{col},{row}] is outside the printed "
                f"{self.spec.cols}x{self.spec.rows} grid")

    @property
    def found_cells(self) -> dict[tuple[int, int], PrintedCell]:
        return {cell.cell: cell for cell in self.cells if cell.cell is not None}

    def describe(self) -> str:
        m = self.metrics
        return (f"{self.spec.cols}x{self.spec.rows} printed grid from "
                f"{m.window_observed or m.full_cells}/{self.spec.cols * self.spec.rows} "
                f"window cells ({m.full_cells} lattice cells, {m.components} blobs), "
                f"candidate {m.window_index + 1}/{m.window_candidates}, residual "
                f"{m.residual_px:.2f} px (max {m.max_residual_px:.2f}), "
                f"parity {m.parity_agreement * 100:.0f}%")


# ---------------------------------------------------------------------------
# measuring the sheet's colours
# ---------------------------------------------------------------------------


def sample_ink_colors(frame: np.ndarray, *, min_saturation: int = MIN_SATURATION,
                      min_value: int = MIN_VALUE, min_pixels: int = 200):
    """Mean colour of the green ink, the magenta ink and the sheet's white paper.

    Returned as a :class:`vision.color_correction.ColorSamples`, which is what a
    colour calibration is fitted from.

    Deliberately independent of :func:`detect_color_grid`. Colour needs three
    materials measured, not a grid solved, and demanding a complete 10x6 fit
    first would refuse exactly the badly-framed, badly-tinted frames a colour
    calibration exists to fix. Any view with some of the sheet in it is enough.

    The masks are found on a white-balanced frame, because a cast bad enough to
    need correcting is bad enough to hide the ink from a fixed hue window; the
    *colours* are then read from the original, because the whole point is to
    measure the cast rather than to remove it twice.

    Paper is read from the ring immediately around the ink — the printed inner
    margins. That ring is the one white surface guaranteed to be lit exactly
    like the ink beside it, which a sheet corner, the bench or the wall behind
    the rig emphatically are not.
    """
    from vision.color_correction import ColorSamples

    if frame is None or frame.ndim != 3 or frame.shape[2] != 3:
        raise ColorGridError("a three-channel BGR frame is required")
    height, width = frame.shape[:2]
    balanced = white_balance(frame)

    def cell_blobs(**mask_kwargs):
        """Cell-shaped green/magenta blobs, filtered to one modal area."""
        g, m = color_masks(balanced, min_value=min_value, balance=False,
                           **mask_kwargs)
        # Only sample things shaped like a printed cell. Under a bad enough cast
        # the wall behind the rig lands inside the magenta window, far larger
        # than every real cell put together — averaging it in would measure the
        # wall and call it ink. Shape is what tells them apart.
        blobs = [rect for rect in _components(g, m, MIN_COMPONENT_AREA,
                                              (width, height))
                 if SHEET_ASPECT_RANGE[0]
                 <= rect["long_len"] / max(rect["short_len"], 1e-6)
                 <= SHEET_ASPECT_RANGE[1]]
        # Reject outliers against each ink's OWN modal area, not a shared one:
        # under a cast one ink often fragments into smaller pieces than the
        # other, and a shared median would then drop every blob of the weaker
        # colour and leave the sampler with two of the three materials.
        kept = []
        for colour in ("green", "magenta"):
            same = [rect for rect in blobs if rect["color"] == colour]
            if not same:
                continue
            median = float(np.median([rect["area"] for rect in same]))
            kept += [rect for rect in same
                     if 0.5 * median <= rect["area"] <= 1.8 * median]
        return kept

    # First the plain hue window. If a strong camera cast has hidden one ink -
    # which is exactly the frame `colourcal` exists to fix, so it cannot just be
    # refused - ADD (never replace) blobs of the missing colour from the
    # cast-invariant channel-order classifier at a low saturation floor.
    keep = cell_blobs(min_saturation=min_saturation)
    missing_inks = {"green", "magenta"} - {rect["color"] for rect in keep}
    if missing_inks:
        extra = cell_blobs(min_saturation=max(6, min_saturation // 4),
                           channel_order=True)
        keep += [rect for rect in extra if rect["color"] in missing_inks]
    if not keep:
        raise ColorGridError(
            "nothing on the sheet is shaped like a printed cell; is the sheet "
            "in frame, roughly in focus, and filling most of the view? A "
            "strong uncorrected camera cast can also hide it — try `wb` first, "
            "or point the camera at a few big solid green/magenta swatches")

    cores = {}
    for name in ("green", "magenta"):
        mask = np.zeros((height, width), np.uint8)
        boxes = [rect["box"] for rect in keep if rect["color"] == name]
        if boxes:
            cv2.fillPoly(mask, [box.astype(np.int32) for box in boxes], 255)
        # Erode well inside the blocks: the ink's printed edge is soft and the
        # lens leaves a halo on it, and both drag the mean toward the paper.
        cores[name] = cv2.erode(mask, np.ones((5, 5), np.uint8),
                                iterations=2).astype(bool)

    ink = np.zeros((height, width), np.uint8)
    cv2.fillPoly(ink, [rect["box"].astype(np.int32) for rect in keep], 255)
    ink_bool = ink.astype(bool)

    # Grid-structure recovery. When one ink is so badly cast that it reads as
    # neutral grey — the rig camera turns the olive green to (b>g=r), invisible
    # to every hue window AND to the channel-order test — the OTHER ink's cells
    # still lay out the grid. The missing ink's cells are then "inside the sheet
    # the visible ink defines, not that ink, and darker than the paper". This is
    # deliberately the last resort: it locates the cells by structure and reads
    # whatever colour is physically there, which is the whole point for a
    # calibration that has to learn `grey -> green`.
    hsv0 = cv2.cvtColor(balanced, cv2.COLOR_BGR2HSV)
    sat0, val0 = hsv0[:, :, 1], hsv0[:, :, 2]
    for missing, present in (("green", "magenta"), ("magenta", "green")):
        if cores[missing].any() or not cores[present].any():
            continue
        span = int(round(1.4 * math.sqrt(max(1.0, float(np.median(
            [r["long_len"] * r["short_len"]
             for r in keep if r["color"] == present]))))))
        span = max(9, span | 1)
        sheet = cv2.dilate((cores[present] | ink_bool).astype(np.uint8),
                           np.ones((span, span), np.uint8), 1)
        sheet = cv2.erode(sheet, np.ones(((span // 2) | 1,) * 2, np.uint8), 1)
        inside = sheet.astype(bool)
        bright = inside & (sat0 < 25) & (val0 > 170)
        if bright.sum() < min_pixels:
            continue
        paper_val = float(np.median(val0[bright]))
        guess = (inside & ~ink_bool
                 & (val0 < paper_val - 20) & (sat0 < 70))
        guess = cv2.erode(guess.astype(np.uint8), np.ones((7, 7), np.uint8),
                          iterations=2).astype(bool)
        if guess.sum() < min_pixels:
            continue
        cand = frame[guess].astype(np.float64).mean(axis=0)
        paper_bgr = frame[inside & (sat0 < 18) & (val0 >= paper_val - 6)]
        other = frame[cores[present]].astype(np.float64).mean(axis=0)
        # Only accept a structural guess that is a genuinely distinct material:
        # clearly darker than paper and not just the visible ink again. If it is
        # not, leave the ink unsampled — an honest two-colour set drives a
        # constrained gain/affine fit, which is all a green-blind frame supports.
        if len(paper_bgr) >= min_pixels:
            if float(np.linalg.norm(cand - paper_bgr.mean(axis=0))) < 14.0:
                continue
        if float(np.linalg.norm(cand - other)) < 12.0:
            continue
        cores[missing] = guess
    # The margins: a ring around the ink that is itself not ink. A wider ring
    # than the paper needs, so the warm "beige" band that the combined target
    # prints between perpendicular fiducials falls inside it too.
    ring = cv2.dilate(ink, np.ones((15, 15), np.uint8), iterations=1).astype(bool)
    hsv = cv2.cvtColor(balanced, cv2.COLOR_BGR2HSV)
    sat, val = hsv[:, :, 1], hsv[:, :, 2]
    pale = (sat < min_saturation) & (val >= min_value)
    outside = ring & ~ink_bool & (val >= min_value)
    paper_core = outside & pale
    # Beige: pale but not neutral, and warm (red clearly the strongest channel
    # in BOTH the raw and the balanced frame, so a cast cannot fake it). The
    # combined sheet's off-white lanes; a distinct tone from true paper.
    b_raw, g_raw, r_raw = (frame[:, :, i].astype(np.int16) for i in range(3))
    b_bal, g_bal, r_bal = (balanced[:, :, i].astype(np.int16) for i in range(3))
    warm = ((r_raw - b_raw) >= 10) & (r_raw >= g_raw) & ((r_bal - b_bal) >= 4)
    beige_core = outside & warm & (sat < min_saturation + 12)
    green_core, magenta_core = cores["green"], cores["magenta"]

    colors, counts, spread = {}, {}, {}

    def take(name, mask, floor=min_pixels):
        pixels = frame[mask]
        if len(pixels) < floor:
            return
        values = pixels.astype(np.float64)
        mean = values.mean(axis=0)
        colors[name] = tuple(float(v) for v in mean)
        counts[name] = int(len(values))
        spread[name] = float(np.sqrt(np.mean(np.sum((values - mean) ** 2, axis=1))))

    take("paper", paper_core)
    for name, mask in (("green", green_core), ("magenta", magenta_core)):
        take(name, mask)
        # An ink sample that came out indistinguishable from the paper is not a
        # measurement of that ink - it is stray near-white pixels the cast
        # let through. Drop it rather than feed a false correspondence to the
        # fit; a genuine two-colour set is the honest input for that frame.
        if (name in colors and "paper" in colors
                and float(np.linalg.norm(np.array(colors[name])
                                         - np.array(colors["paper"]))) < 16.0):
            del colors[name], counts[name], spread[name]

    # Best-effort EXTRA correspondences. Each printed fiducial has a dark accent
    # third and two muted "off-white-ish" thirds blended toward the paper, and
    # the combined sheet prints a warm beige lane. More non-degenerate colour
    # pairs make the 3x3 fit a real least squares rather than an exactly
    # determined one. Only kept when they are meaningfully different from a
    # colour already sampled - a duplicate adds nothing and can rank-degrade the
    # matrix, and a flat solid swatch legitimately has no sub-tones.
    def take_distinct(name, mask, floor):
        take(name, mask, floor)
        if name not in colors:
            return
        here = np.array(colors[name])
        if any(float(np.linalg.norm(here - np.array(colors[other]))) < 8.0
               for other in colors if other != name):
            del colors[name], counts[name], spread[name]

    take_distinct("beige", beige_core, min_pixels)
    for base, core in (("green", green_core), ("magenta", magenta_core)):
        core_vals = val[core]
        if core_vals.size < 4 * min_pixels:
            continue
        dark_cut = float(np.percentile(core_vals, 35))
        muted_cut = float(np.percentile(core_vals, 60))
        take_distinct(f"{base}_dark", core & (val <= dark_cut), min_pixels // 2)
        take_distinct(f"{base}_muted", core & (val >= muted_cut), min_pixels // 2)

    if len({n for n in colors if n in ("green", "magenta", "paper")}) < 2:
        raise ColorGridError(
            f"only found {', '.join(colors) or 'nothing'} on the sheet; at least "
            f"two of green ink, magenta ink and paper have to be visible")
    return ColorSamples(colors=colors, counts=counts, spread=spread)


# ---------------------------------------------------------------------------
# detection
# ---------------------------------------------------------------------------


def white_balance(frame: np.ndarray,
                  quantile: float = WHITE_PATCH_QUANTILE) -> np.ndarray:
    """Scale each channel so the frame's bright quantile is neutral.

    Absolute hue windows cannot survive an arbitrary camera white balance, and
    the rig's camera does not have a good one: on a live frame the whole scene
    carried a magenta cast strong enough to move the green ink to hue 120 with
    saturation 49 — outside the green window *and* under the saturation floor,
    so half of every sheet disappeared and no lattice could form.

    White-patch rather than grey-world on purpose. The sheet's white paper is
    the brightest large thing in a frame that is mostly sheet, which makes the
    bright quantile a real white reference; grey-world would instead be dragged
    around by how much of the frame the pink inks happen to cover.
    """
    sample = frame[::_BALANCE_STRIDE, ::_BALANCE_STRIDE].reshape(-1, 3)
    references = np.percentile(sample, quantile * 100.0, axis=0)
    target = float(references.mean())
    if target <= 0:
        return frame
    scale = target / np.maximum(references, 1e-6)
    if np.allclose(scale, 1.0, atol=_BALANCE_DEADBAND):
        return frame
    # A lookup table, not a float multiply over the whole frame: this runs on
    # every analysed frame on a Pi, and the float round trip costs more than
    # the rest of the detector put together.
    ramp = np.arange(256, dtype=np.float32)
    table = np.clip(ramp[None, :] * scale[:, None], 0, 255).astype(np.uint8)
    return cv2.LUT(frame, np.ascontiguousarray(table.T.reshape(1, 256, 3)))


def flatten_illumination(frame: np.ndarray,
                         blur_fraction: float = _FLATTEN_BLUR_FRACTION) -> np.ndarray:
    """Divide out the low-frequency lighting/cast, per channel, and re-mean.

    ``blurred`` is a very soft Gaussian: everything slower than a cell. Dividing
    by it turns "ink on cast-tinted, unevenly lit paper" into "ink on flat
    neutral paper", which is the difference between the rig camera's green ink
    being findable and not. High-frequency detail (the ink itself, the printed
    gaps) is untouched because it is not in the blur.

    Cheap enough for a live Pi frame: one separable blur plus a divide on the
    working-resolution image.
    """
    if frame is None or frame.ndim != 3:
        return frame
    short_side = min(frame.shape[:2])
    sigma = max(_FLATTEN_MIN_SIGMA, blur_fraction * short_side)
    blurred = cv2.GaussianBlur(frame.astype(np.float32), (0, 0),
                               sigmaX=sigma, sigmaY=sigma)
    blurred = np.maximum(blurred, 1.0)
    ratio = frame.astype(np.float32) / blurred
    # Re-mean each channel to the frame's own mid so downstream Value floors and
    # the overlay still see a normally exposed image.
    target = float(np.mean(frame))
    flat = ratio * target
    return np.clip(flat, 0, 255).astype(np.uint8)


@dataclass(frozen=True)
class ColorRegionStats:
    """Robust colour measurements for one projected artwork subregion.

    The three representations are intentionally retained together. HSV
    saturation separates ink from neutral paper, Lab distance survives modest
    exposure changes, and normalized opponent channels remain useful in deep
    shadows where hue becomes noisy.
    """

    bgr: tuple[float, float, float]
    hsv: tuple[float, float, float]
    lab: tuple[float, float, float]
    green_opponent: float
    magenta_opponent: float
    strength: float
    pixels: int


def sample_color_region(frame: np.ndarray, polygon) -> ColorRegionStats:
    """Measure a projected polygon with channel, HSV and Lab robust medians."""
    points = np.asarray(polygon, dtype=np.float32).round().astype(np.int32)
    x, y, width, height = cv2.boundingRect(points)
    x0, y0 = max(0, x), max(0, y)
    x1, y1 = min(frame.shape[1], x + width), min(frame.shape[0], y + height)
    if x1 <= x0 or y1 <= y0:
        pixels = np.empty((0, 3), np.uint8)
    else:
        local = points - np.int32((x0, y0))
        mask = np.zeros((y1 - y0, x1 - x0), np.uint8)
        cv2.fillConvexPoly(mask, local, 255, cv2.LINE_AA)
        pixels = frame[y0:y1, x0:x1][mask >= 192]
    if len(pixels) < 9:
        raise ColorGridError(
            "an internal fiducial subregion projects to too few pixels; move "
            "the camera closer or use a higher-resolution frame",
            stage="orientation",
        )
    bgr = np.median(pixels.astype(np.float32), axis=0)
    hsv_pixels = cv2.cvtColor(pixels.reshape(-1, 1, 3), cv2.COLOR_BGR2HSV)
    lab_pixels = cv2.cvtColor(pixels.reshape(-1, 1, 3), cv2.COLOR_BGR2LAB)
    hsv = np.median(hsv_pixels.astype(np.float32), axis=0).reshape(3)
    lab = np.median(lab_pixels.astype(np.float32), axis=0).reshape(3)
    b, g, r = (float(value) for value in bgr)
    total = b + g + r + 12.0
    green_opponent = (g - (r + b) * 0.5) / total
    magenta_opponent = ((r + b) * 0.5 - g) / total
    spread = (max(b, g, r) - min(b, g, r)) / max(max(b, g, r), 12.0)
    lab_chroma = float(np.linalg.norm(lab[1:] - 128.0)) / 100.0
    strength = float(np.clip(
        0.45 * hsv[1] / 255.0 + 0.30 * spread + 0.25 * lab_chroma,
        0.0, 1.5,
    ))
    return ColorRegionStats(
        bgr=tuple(float(value) for value in bgr),
        hsv=tuple(float(value) for value in hsv),
        lab=tuple(float(value) for value in lab),
        green_opponent=green_opponent,
        magenta_opponent=magenta_opponent,
        strength=strength,
        pixels=int(len(pixels)),
    )


def lab_distance(first: ColorRegionStats, second: ColorRegionStats) -> float:
    """Euclidean OpenCV-Lab distance between two robust region samples."""
    return float(np.linalg.norm(
        np.asarray(first.lab, dtype=np.float32)
        - np.asarray(second.lab, dtype=np.float32)))


def channel_order_masks(frame: np.ndarray, min_value: int = MIN_VALUE
                        ) -> tuple[np.ndarray, np.ndarray]:
    """Cast-invariant green/magenta masks from the ORDER of the BGR channels.

    Green ink is the only sheet material whose green channel is the maximum;
    magenta is the only one whose green channel is the minimum with both blue
    and red clearly above it. Paper - even a strongly yellow-cast paper that a
    hue window and a saturation floor both mistake for green ink - has blue as
    its maximum and green above red, so it is neither. This survives any single
    global colour cast, which is exactly the failure mode of an uncalibrated
    rig camera.
    """
    b, g, r = (channel.astype(np.int16) for channel in cv2.split(frame))
    value = np.maximum.reduce((b, g, r))
    lit = value >= min_value
    other_max = np.maximum(b, r)
    green = (g >= b) & (g >= r) & ((g - other_max) >= CHANNEL_ORDER_GREEN_MARGIN) & lit
    magenta = (((b - g) >= CHANNEL_ORDER_MAGENTA_B_MARGIN)
               & ((r - g) >= CHANNEL_ORDER_MAGENTA_R_MARGIN) & lit)
    return green, magenta


def color_masks(frame: np.ndarray, *, min_saturation: int = MIN_SATURATION,
                min_value: int = MIN_VALUE, green_hue=GREEN_HUE,
                magenta_hue=MAGENTA_HUE,
                use_opponent: bool = True,
                balance: bool = True,
                flatten: bool = False,
                channel_order: bool = False) -> tuple[np.ndarray, np.ndarray]:
    """Return the (green, magenta) boolean masks for one BGR frame.

    Hue plus a saturation floor, not brightness: the two inks stay a long way
    apart in hue under any light, while their brightness does not. ``balance``
    neutralises the camera's colour cast first — see :func:`white_balance` for
    why that is not optional in practice. ``flatten`` additionally divides out
    the low-frequency lighting/cast (:func:`flatten_illumination`) first.
    ``channel_order`` unions in :func:`channel_order_masks`, the cast-invariant
    classifier for a camera that has not been colour-calibrated yet.
    """
    if flatten:
        frame = flatten_illumination(frame)
    raw = frame
    balanced = white_balance(frame) if balance else frame
    hsv = cv2.cvtColor(balanced, cv2.COLOR_BGR2HSV)
    hue, sat, val = cv2.split(hsv)
    strong = (sat >= min_saturation) & (val >= min_value)
    green = (hue >= green_hue[0]) & (hue <= green_hue[1]) & strong
    magenta = (hue >= magenta_hue[0]) & (hue <= magenta_hue[1]) & strong

    if channel_order:
        order_green, order_magenta = channel_order_masks(raw, min_value)
        green = green | order_green
        magenta = magenta | order_magenta

    # A second, illumination-invariant vote.  Use the raw frame so a global
    # white-patch estimate cannot amplify one shadow differently from another.
    # Adding a small denominator pedestal suppresses quantisation noise in very
    # dark near-black pixels.
    if use_opponent:
        b, g, r = np.moveaxis(raw.astype(np.float32), 2, 0)
        total = b + g + r + 12.0
        spread = np.maximum.reduce((b, g, r)) - np.minimum.reduce((b, g, r))
        weak_chroma = sat >= max(8, min_saturation // 2)
        green |= (((g - r) / total >= GREEN_OPPONENT_MIN)
                  & (spread >= GREEN_CHANNEL_SPREAD_MIN)
                  & weak_chroma & (hue >= green_hue[0] - 8)
                  & (hue <= green_hue[1] + 8))
        magenta |= ((((r + b) * 0.5 - g) / total >= MAGENTA_OPPONENT_MIN)
                    & (spread >= MAGENTA_CHANNEL_SPREAD_MIN)
                    & weak_chroma & (hue >= magenta_hue[0] - 8))
    return green, magenta
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
