ahmedjk34/hardware-grad-project/python/vision/color_correction.py

#!/usr/bin/env python3
"""Software colour correction: one affine BGR transform, saved with the camera.

Why this exists
---------------
The rig's camera does not agree with anyone's eyes. A live frame arrived with a
magenta cast strong enough to turn the printed sheet's green ink cyan, which
made half of it invisible to ``vision/color_grid.py`` and degrades
``vision/block_detector.py`` too, since that keys on red-minus-blue. The
detectors can defend themselves — ``color_grid`` white balances internally —
but defending each consumer separately is the wrong shape. Fix the picture once,
where the picture is defined, and every stage downstream inherits it.

So this is a small transform that lives in ``camera_settings.json`` next to the
lens block, is edited in ``camera_studio.py``'s COLOUR section, and is applied
by ``camera_feed.py`` and everything built on it.

The model
---------
One 3x4 affine matrix in **BGR**, then gamma, then saturation::

    out = clip(M[:, :3] @ bgr + M[:, 3])
    out = 255 * (out / 255) ** (1 / gamma)
    out = luma + saturation * (out - luma)

The matrix covers the two things a camera actually gets wrong: per-channel gain
(white balance) on the diagonal, and cross-channel bleed off it. A diagonal
matrix is the common case and is the default a calibration solves for, because
it is over-determined by the samples available and therefore stable. The full
3x3 is offered for when the diagonal visibly cannot get there, and is flagged
when solved, because three ink colours determine it exactly with nothing left
over to check it against.

Gamma and saturation are separate rather than folded in because they are not
linear, and because they are the two knobs a person reaches for after the
neutral is right.
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
