ahmedjk34/hardware-grad-project/(commit log)

2026-07-15 Add initial implementation of camera debugging tools with grid overlay functionality
2026-07-20 Add grid viewer test with real-world measurements for calibrated frame size
2026-07-20 Refine step command descriptions and limit switch details in step_counter.ino
2026-07-21 Enhance step counter functionality with software limits and live position tracking
    - Added software limits for X and Y axes to prevent over-travel.
    - Implemented live position tracking with axis position updates during movement.
    - Updated command descriptions for clarity regarding physical and software limits.
    - Introduced new commands for zeroing position and improved limit status reporting.
    - Enhanced limit checking logic to prioritize physical switches over software limits.
    - Refactored limit handling functions for better readability and maintainability.
    [position_test_with_always_origin.ino, step_counter.ino]
2026-07-29 Adjust motion tuning parameters and refine soft limit definitions for Z-axis
2026-07-29 Swap servo open and close angles for correct operation
    [position_test_with_servo.ino]
2026-07-29 Fix servo command descriptions and update limit switch logic for X-axis
    [position_test_with_always_origin.ino, position_test_with_servo.ino, position_test_with_z_axis.ino, step_counter.ino]
2026-07-30 Add important notes on motor driver pin configuration for clarity
2026-08-10 Swap X and Y axis commands and update related comments for clarity
    [position_test_with_always_origin.ino, position_test_with_servo.ino, position_test_with_z_axis.ino, step_counter.ino]
2026-08-10 Update motor direction commands and comments for clarity after hardware reconfiguration
2026-08-10 Update motor command descriptions and limit configurations for clarity after hardware adjustments
2026-08-11 Adjust step delay, steps per move, and X-axis soft limit to optimize performance
2026-08-11 Refactor motion tuning for independent Z axis control and update jog parameters for clarity
2026-08-11 Update Z-axis soft limit to reflect new hardware specifications
2026-08-11 Implement full reset command (0+) for Z axis and update handling in serial input
    [position_test_with_servo.ino, position_test_with_z_axis.ino]
2026-08-16 Add fisheye correction tools and update README with usage instructions
    [camera_source.py, undistorted_viewer.py]
2026-08-16 Add undistorted viewer and supporting modules for fisheye correction
    - Implemented `undistorted_viewer.py` for live fisheye-corrected preview.
    - Created `vision` package with modules for camera source, fisheye correction, and overlays.
    - Added `camera_source.py` to handle V4L2 and Picamera2 camera interfaces.
    - Introduced `devices.py` for enumerating and selecting V4L2 capture devices.
    - Developed `fisheye.py` for fisheye to rectilinear image correction.
    - Added `overlays.py` for shared OpenCV drawing helpers.
    - Removed obsolete `grid_viewer_35cm_vertical_20cm_horizontal.py` test file.
    [camera_source.py, camera_viewer.py, devices.py, fisheye.py, grid_viewer.py, measured_grid_viewer.py, overlays.py, undistorted_viewer.py]
2026-08-16 Refactor Z-axis limit switch handling: replace software limit with physical switches, update homing logic, and improve documentation.
    [build_test_v1_soft_z_backup.ino, position_test_with_servo.ino, position_test_with_z_axis.ino]
2026-08-18 Add Z_TRAVEL_CM constant for physical distance between Z-axis switches
2026-08-18 Update AUX stepper rotation commands to support +/-180 degrees
2026-08-19 Add support for high-quality capture and improve sharpness handling
    - Introduced `--hq` flag to capture full 2592x1944 sensor readout for sharper images in `undistorted_viewer.py`.
    - Updated README.md to document the new `--hq` option and its benefits for image quality.
    - Enhanced `camera_source.py` to handle image quality controls for Picamera2, including sharpness and denoise settings.
    - Improved `fisheye.py` to analyze sampling density and detail, providing better feedback on image sharpness.
    - Refactored undistortion logic to support mipmap levels for improved quality during downscaling.
    - Added detailed comments and documentation throughout the code to clarify the impact of various para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
2026-08-19 Add command engine and overlay enhancements for user feedback
    - Implemented a typed-command engine in `commands.py` to handle user inputs from various sources, providing feedback on command execution.
    - Added support for command aliases, error handling, and usage hints.
    - Introduced an `EditBuffer` class for managing user input with history navigation.
    - Enhanced `MessageLog` to track command feedback, allowing users to see command acceptance or rejection.
    - Updated `overlays.py` to include new colors for command feedback and added a `draw_text_panel` function for displaying colored messages.
    - Improved grid labeling and measurement display functions to enhance user experience.
    [commands.py, overlays.py, undistorted_grid_viewer.py]
2026-08-19 Add step counter functionality and configuration for CNC rig
    - Implemented a new Arduino sketch for step counter control with dual TB6600 drivers, including limit switches and software limits.
    - Created a configuration file (rig.json) to manage serial port settings, grid dimensions, and frame size for the rig.
    - Updated Python scripts to load frame dimensions from the new configuration file, ensuring consistency across viewers.
    - Refactored configuration handling in Python to centralize settings in rig/config.py, reducing redundancy and improving maintainability.
2026-08-19 Enhance documentation and add rig console for Arduino communication; update dependency management
2026-08-19 Update documentation to clarify Python version usage and virtual environment setup across devices
2026-08-19 Add measured and undistorted grid viewer tools
    - Implemented `measured_grid_viewer.py` for displaying a grid overlay in real-world centimeters, allowing users to visualize pixel bounds and real-world measurements.
    - Merged functionalities of `undistorted_viewer.py` and `measured_grid_viewer.py` into `undistorted_grid_viewer.py`, providing fisheye correction alongside a measurement grid for accurate readings on corrected images.
    - Enhanced user interaction with command-line inputs, mouse tracking, and real-time parameter adjustments through sliders and keyboard shortcuts.
    [camera_viewer.py, grid_viewer.py, measured_grid_viewer.py, undistorted_grid_viewer.py, undistorted_viewer.py]
2026-08-20 Implement serial link functionality for rig control
    - Added `link.py` to manage serial communication with the rig, including command sending and response handling.
    - Introduced `Rig` class to encapsulate connection management, command execution, and response parsing.
    - Implemented acknowledgment parsing for commands using `Ack` dataclass.
    - Created `BuildResult` class to represent outcomes of build commands with detailed reasons.
    - Added error handling for various rig states (e.g., busy, reset, timeout).
    - Updated `rig_console.py` to utilize the new `Rig` class for command input and output.
    - Developed `test_link.py` to provide unit tests for the new functionality, simulating a rig environme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
    [link.py, rig_console.py]
2026-08-20 Update Y-axis travel limits and related documentation to reflect new soft limits
2026-08-20 Add grid management and visualization features
    - Introduced a new `grid.py` module to manage the machine's grid, including cell mapping and configuration loading.
    - Updated `__init__.py` to include references to the new `grid` module.
    - Created a test suite in `test_grid.py` to validate grid functionality against firmware output.
    - Enhanced `camera_source.py` to support additional camera controls and settings management.
    - Modified `fisheye.py` to allow manual adjustments for lens distortion correction.
    - Implemented new overlay functions in `overlays.py` for drawing cell labels and axis labels on the camera feed.
    [camera_source.py, fisheye.py, grid.py, overlays.py, undistorted_grid_viewer.py]
2026-08-20 Enhance documentation for camera settings and add new features to camera_studio.py
2026-08-20 Add default camera settings configuration file
    This commit introduces a new JSON configuration file for camera settings,
    which defines default parameters for capturing, lens properties, correction
    settings, framing options, and sensor adjustments. The settings are designed
    to be used by the camera_studio.py script at startup, ensuring consistent
    rendering as seen in undistorted_viewer.py. Users can overwrite these
    defaults by saving new settings or reset to defaults by deleting the file
    or using the --fresh option.
2026-08-20 Implement four-corner workspace calibration and mapping
    - Added workspace mapping functionality to allow for click-to-build operations.
    - Introduced `WorkspaceMap` class to handle the mapping of normalized image coordinates to machine grid cells.
    - Updated `undistorted_grid_viewer.py` to support calibration commands, including starting calibration, connecting to the rig, and executing movements.
    - Enhanced user interaction by providing visual feedback during calibration and workspace selection.
    - Implemented error handling for invalid workspace configurations and added tests to ensure robustness of the mapping logic.
    - Updated documentation and command descriptions to reflect new features an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
    [undistorted_grid_viewer.py, workspace.py]
2026-08-20 Enhance camera studio interface with dropdowns for fixed-value fields and improve user interaction
2026-08-20 Add live fisheye-corrected preview tool with detailed usage instructions
    [undistorted_grid_viewer.py]
2026-08-20 Add main camera feed script and update documentation for camera settings
2026-08-20 Enhance block detection and visualization in camera feed
    - Implement block detection with color-coded overlays, contours, and metadata display.
    - Add functionality to save annotated frames and detection data.
    - Introduce a new test for block detection against captured images.
    - Create a dedicated block detection module for improved separation of concerns.
2026-08-20 Add gridded camera feed implementation and workspace calibration logic
2026-08-20 Implement rig build functionality with calibrated cell selection and confirmation for Arduino commands
2026-08-20 Refactor rig build functionality to support camera-grid cell selection and update related documentation
2026-08-20 Update documentation for aux stepper to reflect 90-degree rotation commands
2026-08-20 Add build job functionality to run firmware builds off the UI thread, ensuring camera feed remains active and enforcing safety rules
2026-08-22 Enhance camera handling to ensure UI responsiveness during firmware builds and add tests for frame pump functionality
2026-08-22 Fix frame rate calculation to improve performance metrics in main function
2026-08-22 Update GUIDE.md to clarify camera stall handling and selection behavior during builds
2026-08-22 Enhance calibration process with ordered corner clicks, preview lines, and undo functionality; update documentation for clarity
2026-08-22 Enhance calibration visualization with color-coded edges for horizontal, vertical, and diagonal lines; update tests to verify color assignments.
2026-08-23 Add initial 28BYJ-48 + ULN2003 motor test with serial control commands
2026-08-23 Update ULN2003 connection details and pin assignments for 28BYJ-48 stepper motor across multiple sketches
2026-08-23 Add support for zero coordinates in BUILD command for calibration; B 0 0 is a no-op
2026-08-23 Enhance build target handling to support zero coordinates for calibration; update related documentation and tests.
2026-08-23 Refactor camera viewer implementations to use TkCameraWindow for UI; enhance mouse event handling and status display across multiple scripts.
2026-08-23 Refactor camera-related scripts to enhance Tk status panel integration; update calibration and hover feedback mechanisms.
2026-08-23 Add calibration visualization to camera feed and rig build scripts; enhance user feedback during calibration process.
2026-08-23 Add regression tests for camera performance and introduce new analysis workers
    - Created `test_camera_performance.py` to validate camera processing and geometry handling, including checks for overlay functions and detection metrics.
    - Enhanced `test_gridded_feed.py` with additional checks for grid overlays in detail mode.
    - Introduced `test_latest_workers.py` to test the functionality of the latest-only analysis and snapshot workers, ensuring proper request handling and result validation.
    - Implemented `analysis_worker.py` for background analysis of camera frames, maintaining only the latest request for efficiency.
    - Added `latest_worker.py` to manage the latest value requests, ensuring that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
2026-08-23 Add block detection toggle to camera feed and rig build scripts; update UI and status messages accordingly.
2026-08-24 Update calibration details and software limits across documentation and firmware; verify Y axis travel cap adjustments.
2026-08-24 Update firmware software caps and calibration details; adjust X and Y step limits across documentation and code.
2026-08-24 Add color grid detection and overlay functionality
    - Introduced `color_grid.py` for detecting the printed two-colour calibration sheet and fitting a grid to it.
    - Added `color_grid_overlay.py` to handle drawing the fitted grid over camera frames, including visual feedback for detected and rejected cells.
    - Updated `__init__.py` to include new modules and their descriptions.
2026-08-24 Fix Y-axis step count and improve error handling in color grid detection
    - Updated Y-axis step count from 8275 to 7975 in multiple documentation files and code comments to reflect accurate calibration.
    - Enhanced the ColorGridError class to include candidates and stage information for better diagnostics during detection failures.
    - Implemented a draw_candidates function to visualize detected blobs during failures, aiding in troubleshooting.
    - Adjusted detection logic to provide clearer error messages regarding insufficient whole cells and occlusions.
    - Ensured white balance is applied before color detection to prevent issues with color casts affecting detection accuracy.
    [color_grid.py, color_grid_overlay.py]
2026-08-24 Enhance grid calibration and color correction functionality; update Y-axis trim and improve error handling in grid geometry checks
    [color_correction.py, color_grid.py, grid.py]
2026-08-24 Enhance color correction functionality and update grid calibration details; fix Y-axis step count and improve documentation across multiple files. Adjusted Y-axis limits to 8250 steps, refined grid g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
    [color_correction.py, grid.py]
2026-08-24 Refine grid dimensions and offsets in documentation and code
    - Updated README.md to clarify physical build footprint and tool offsets.
    - Adjusted build_test_v1.ino to reflect new X and Y grid shifts.
    - Modified rig.json to set correct X trim for grid alignment.
    - Revised plan-2-click-to-build.md to accurately describe column and row centers.
    - Enhanced GUIDE.md with updated grid pitch and footprint details.
    - Implemented color correction handling in camera_feed.py and related files.
    - Added comprehensive tests for color correction functionality in test_color_correction.py.
    - Updated grid tests in test_grid.py to validate new dimensions and offsets.
2026-08-24 Refactor motor control logic to support signed degree input; enhance command handling and improve user feedback
2026-08-24 Enhance camera color correction documentation and functionality; add detailed instructions for color calibration and update related tools in the guide
2026-08-24 Implement Evidence-Assisted Printed-Grid Calibration
    - Enhanced the calibration process by introducing Evidence-Assisted Printed-Grid Calibration to handle cases where the gantry occludes interior cells.
    - Updated GUIDE.md to include instructions for the new calibration method and its usage.
    - Modified gridded_camera_feed.py to support evidence collection and processing, including new key bindings for starting evidence sessions and accepting frames.
    - Added draw_paper_evidence function to visualize measured and inferred cells during evidence collection.
    - Created grid_evidence.py to manage pooling of observations from multiple frames, ensuring only valid cells are considered for calibration.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
    [color_grid.py, grid_evidence.py]
2026-08-25 Enhance color grid detection and calibration logic; improve handling of scene clutter and add robustness checks for color parity and aspect ratio
2026-08-26 Enhance advanced lens tuning capabilities in Camera Studio
    - Introduced new parameters for advanced lens distortion correction: k3, k4, focal_x_scale, focal_y_scale, skew, p1, and p2.
    - Updated the lens profile to accommodate new parameters and ensure they are clamped within valid ranges.
    - Modified the remapping logic to incorporate the new distortion parameters while preserving legacy behavior for existing profiles.
    - Added manual tuning commands and reset functionality to the Studio class for better user control over lens adjustments.
    - Implemented regression tests to validate the new tuning features and ensure compatibility with legacy functionality.
    - Enhanced documentation to clarify t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
    [fisheye.py]
2026-08-26 Add instructions for pushing camera captures to GitHub
2026-08-26 Add camera captures
2026-08-26 Enhance printed grid detection and selection functionality
    - Introduced support for multiple overlapping printed grid windows in the camera feed.
    - Updated `detect_color_grid` to `detect_color_grids` for detecting all valid grid windows.
    - Added cycling functionality to select previous/next detected grid windows using ',' and '.' keys.
    - Enhanced `PaperGridTracker` to manage multiple calibrations and selection states.
    - Updated UI messages and key bindings to reflect new grid selection capabilities.
    - Improved drawing functions to visualize all detected grids and highlight the selected one.
    - Added error handling for invalid grid selections.
    - Updated tests to validate new multi-window detec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
    [color_grid.py, color_grid_overlay.py, grid.py]
2026-08-26 Adjust error offset for Y-axis in grid configuration
2026-08-26 Add support for gripper servo angle control and update related documentation
2026-08-29 Refactor grid configuration to support dual orientation modes
    - Introduced a new grid mode system with vertical and horizontal configurations.
    - Updated legacy block keys to use `block_x_cm` and `block_y_cm` for clarity.
    - Modified `MachineGrid` and `WorkspaceMap` classes to accommodate the new block dimensions.
    - Adjusted tests to validate the new grid modes and ensure backward compatibility with legacy configurations.
    - Removed rotation parameter from build commands to simplify the interface.
    - Enhanced error handling for unknown grid modes and ensured readable exceptions.
    - Updated color grid specifications to align with the new block dimension naming.
    [build_controller.py, color_grid.py, config.py, grid.py, link.py]
2026-08-29 Refactor rig and workspace handling for dual-mode support
    - Introduced a mechanism to handle both vertical and horizontal modes in the Rig class, ensuring that resets are explicitly managed and require human authorization for recovery.
    - Updated WorkspaceMap to support dual-mode calibration, allowing for the preservation of both vertical and horizontal configurations in workspace maps.
    - Enhanced error handling to prevent mode mismatches during calibration and workspace loading.
    - Modified ColorGridSpec to explicitly require mode during initialization and validation, ensuring compatibility with the selected machine grid.
    - Adjusted evidence collection logic in PaperGridEvidence to accommodat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
    [color_grid.py, grid_evidence.py, link.py]
2026-08-29 Enhance rig mode handling to support explicit homing before horizontal configuration
2026-08-29 Enhance auxiliary stepper commands to support relative angle movements and add safety checks for manual jog limits
2026-08-29 Enhance auxiliary stepper functionality to support relative angle movements and update related documentation
2026-08-29 Refactor claw rotation handling to clarify manual angle errors and update related documentation
    [link.py]
2026-08-29 Update tool offsets for CCW calibration and document changes in related files
2026-08-30 Update tool offsets for improved calibration accuracy
2026-08-30 Remove obsolete JSON captures and image files; add comprehensive tests for combined grid detection
    - Deleted empty JSON files related to previous captures.
    - Removed unused image files: HOROZONTAL_GRID_BUG.png, RAW.png, and WITH_PAPER_GRID.png.
    - Introduced a new test suite (test_combined_grid.py) to validate the functionality of the combined grid detection.
    - Enhanced the color grid detection logic to accommodate combined grid specifications and improved error handling.
    - Updated the vision module to include combined grid detection capabilities and adjusted related functions for better configurability.
    [color_grid.py, color_grid_overlay.py, combined_grid.py]
2026-08-30 Enhance combined grid detection and reporting
    - Added orientation reporting in the calibration report for combined grids.
    - Updated drawing functions to use pattern labels for combined grids.
    - Enhanced test coverage for combined grid detection, including orientation validation and edge cases for color detection.
    - Introduced robust color measurement statistics for projected artwork subregions.
    - Improved the decoding of combined grid patterns, ensuring accurate orientation detection and handling of ambiguous cases.
    - Refined the rendering of target images to include new encoding options and visual cues for orientation.
2026-08-30 Refactor combined grid detection and decoding logic
    - Updated the docstring to clarify the purpose of the combined grid detection.
    - Enhanced the fiducial pattern structure to include orientation and confidence metrics.
    - Improved the orientation classification logic to handle mixed orientations and provide detailed confidence scores.
    - Refined the pattern decoding process to ensure accurate measurement of chromatic bars and bridges.
    - Introduced new scoring metrics for vertical and horizontal orientations, including thresholds for minimum visibility and contrast.
    - Adjusted error handling to provide clearer feedback on orientation detection failures.
    - Updated the PrintedGridEvidence class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
    [build_test_v1_soft_z_backup.ino, build_test_v2.ino, color_grid.py, color_grid_overlay.py, combined_grid.py, container_servo_test.ino, position_test_with_servo.ino]
2026-08-30 Refactor calibration logic to support distinct vertical and horizontal modes; update related documentation and tests
2026-08-30 Refactor color grid tests and configurations for updated dimensions
    - Adjusted test_color_grid.py to reflect new grid dimensions: horizontal grid now uses 3x11 and vertical grid uses 7x6.
    - Updated test_config_modes.py to align with new configurations, changing expected values for vertical and horizontal modes.
    - Modified test_grid.py to accommodate new block sizes and gaps, ensuring all checks reflect the updated grid specifications.
    - Altered block_detector.py to calculate default block dimensions based on the new aspect ratio.
    - Revised color_grid.py to set new block dimensions and gaps for the ColorGridSpec class.
    - Updated combined_grid.py to improve error handling during grid detection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
    [block_detector.py, color_grid.py, combined_grid.py]
2026-08-30 Enhance printed color grid specifications and detection logic
    - Updated printed color grid dimensions in documentation to reflect new sizes.
    - Adjusted edge margin handling in detection algorithms to improve accuracy.
    - Implemented support for multiple sub-grid selections from oversized sheets.
    - Enhanced user interface to display available grid options and selection feedback.
    - Updated tests to validate new edge margin functionality and sub-grid detection.
2026-08-30 Enhance color sampling logic and improve handling of camera casts in ink color detection
2026-08-30 Enhance color calibration logic to improve handling of strong camera casts and missing ink detection
    [color_grid.py]
2026-08-30 Update calibration parameters for vertical and horizontal modes, including error offsets and registration shifts
2026-08-30 Update error offsets and calibration parameters for vertical and horizontal modes
2026-08-30 Update calibration parameters and error offsets for vertical and horizontal modes
2026-08-30 Update vertical error offsets and calibration parameters for grid alignment
2026-08-30 Update error offsets for vertical and horizontal calibration, adjusting Y values and related test cases
2026-09-01 Add MockBoard for off-rig development and refactor Rig to support custom serial factories
    - Introduced MockBoard class to simulate Arduino behavior for testing without hardware.
    - Added FakeSerial class to provide a scripted pyserial-like interface for tests.
    - Refactored Rig class to accept a custom serial factory, allowing for easier testing and mock integration.
    - Updated tests to utilize MockBoard and validate protocol-level interactions.
    - Removed redundant FakeSerial implementation from test_link.py, leveraging the new MockBoard instead.
2026-09-01 Add mock camera implementation and update camera source to support mock backend
2026-09-01 Add ConsolePipeline implementation and corresponding tests for mock camera functionality
2026-09-01 feat: Implement FastAPI backend for rig operator console
    - Add web state management and command routes for operator console.
    - Create a mock camera settings utility for testing.
    - Implement cluster grid detection for bordered-cluster calibration sheets.
    - Introduce websocket support for real-time state updates.
    - Enhance state model to encapsulate operator console state.
    - Add tests for web state and event handling.
    - Update development requirements for FastAPI and related libraries.
2026-09-01 feat: initialize rig operator console with React, Vite, and TypeScript
    - Add package.json with dependencies for React, Vite, and testing libraries
    - Create main application structure with App component and routing
    - Implement API functions for rig operations
    - Develop UI components including CameraView, ControlPanel, and BuildButton
    - Integrate state management with a custom store
    - Add calibration functionality with user prompts
    - Implement WebSocket connection for real-time updates
    - Create tests for workspace projection and UI components
    - Style application with CSS for a modern look
2026-09-01 feat: enhance color tuning with shadow protection and add calibration artifacts
2026-09-01 fix: update servo close angle from 90° to 50° in firmware and documentation delete: remove unused image files from color correction captures
    [rig_console.py]
2026-09-01 fix: adjust STEP_DELAY for improved stepper motor performance
2026-09-01 fix: update STEP_DELAY for improved stepper motor speed
2026-09-01 Refactor workspace geometry and update horizontal grid dimensions
    - Removed unused geometry attributes related to the horizontal Y lattice in WorkspaceMap.
    - Updated tests and configurations to reflect the new horizontal grid dimensions of 3 x 10 instead of 3 x 11.
    - Adjusted related calculations and checks in test files to ensure consistency with the new geometry.
    - Modified ColorGridSpec to align with the updated horizontal grid configuration and clarified documentation regarding the printed sheet's geometry.
    - Ensured that all relevant tests pass with the new configurations, including adjustments to edge overhangs and trim values.
2026-09-01 Refactor grid handling to include shift parameters
    - Updated servo angles in container_servo_test.ino for better mechanical alignment.
    - Enhanced rig.json configuration to include shift_x_cm and shift_y_cm for grid translation.
    - Modified Python rig configuration to handle new shift parameters, ensuring they are pushed to the firmware correctly.
    - Adjusted MachineGrid class to incorporate shift_x_cm and shift_y_cm, affecting cell positioning and geometry validation.
    - Implemented tests for grid shifts in test_grid.py and test_link.py to ensure correct behavior and error handling.
    [config.py, container_servo_test.ino, grid.py, link.py, workspace.py]
2026-09-01 feat: add keyboard shortcuts component and integrate into status bar
    - Introduced a new `Shortcuts` component to display keyboard shortcuts with descriptions.
    - Enhanced `StatusBar` to include uptime tracking and additional state information.
    - Implemented a logging mechanism in the store to handle log messages efficiently.
    - Updated the styling to reflect a new design theme and improve UI consistency.
    - Added comprehensive tests for various components including `Shortcuts`, `CameraChip`, and `RigLog`.
    - Improved WebSocket connection handling to batch log messages for better performance.
    - Updated Vite configuration to include PWA support with appropriate manifest settings.
2026-09-01 feat(studio): coordinate and geometry foundation, tested against Python
    Plan 4 M0. web/src/studio/coords.ts is the TypeScript counterpart of
    python/rig/grid.py - the one place the Studio handles an axis - and
    geometry.ts holds the machine-space predicates that stand on it. Both are
    pure: no React, no three.js, no DOM.
    python/tools/dump_grid_fixtures.py dumps every cell centre, footprint and
    AABB out of MachineGrid for both modes across a spread of trims, error
    offsets and shifts (17 cases, 980 cells); coords.test.ts holds the port to
    them at 1e-6. clippedCells() mirrors the firmware's gridColsNow()/
    gridRowsNow(): the requested grid is kept, the reachable one is clipped.
    Geometry is read f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
2026-09-01 feat: implement 3D viewport and lattice visualization for machine workspace
    - Add Lattice.ts to manage cell states and geometry for the machine's grid.
    - Introduce Envelope.tsx to render the travel cap with rulers.
    - Create Lattice.tsx to visualize addressable cells, including feeder and clipped states.
    - Develop Viewport.tsx for the 3D canvas, integrating camera controls and scene elements.
    - Establish theme.ts for consistent color management across the Studio.
    - Implement view.ts for camera positioning and viewport framing logic.
    - Add view.test.ts to ensure camera poses and envelope dimensions are accurate.
    - Update style.css to enhance the Studio's visual design with a vignette effect.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
2026-09-01 feat: implement validation rules for model placement and diagnostics
    - Added a new validation module to enforce placement rules for machine models.
    - Introduced various diagnostic codes for errors and warnings related to model placement.
    - Implemented rules such as feeder cell checks, out-of-grid detection, clipping by shift, edge overhang, level ceiling, duplicate cell detection, collision checks, unsupported placements, claw clearance, geometry drift, and island detection.
    - Enhanced the view module with new camera movement features for an introductory animation.
    - Updated styles for side panels and diagnostic messages in the studio interface.
    - Added tests for new view functionalities and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
2026-09-01 feat: implement program compilation and visualization
    - Add compile.ts for compiling models into ordered programs with support graphs and operation emission.
    - Introduce ProgramView component to display the compiled program as a serial log, including build operations and mode latches.
    - Enhance diagnostics panel tests to ensure proper grouping of errors and warnings.
    - Create ProgramView tests to validate rendering of program lines, selection behavior, and clipboard functionality.
    - Extend settings panel to include block cycle and latch homing time settings, with corresponding tests for validation.
    - Update settings management to handle new timing fields and ensure backward compatibility wit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
2026-09-01 feat: implement twin functionality and tests for Plan 4 §9
    - Add twin.ts module to manage the twin's state and rendering logic.
    - Create twin.test.ts to validate the twin's behavior against various scenarios.
    - Introduce workspaceBoxScene function in view.ts to define the camera's framing rectangle.
    - Update view.test.ts to include tests for workspaceBoxScene.
    - Modify CSS styles to enhance the layout and appearance of the twin and camera interface.
2026-09-01 feat: implement runner reducer with comprehensive tests
    - Added a new runner reducer to manage the execution of a compiled program, ensuring safety and correctness in command execution.
    - Created extensive unit tests for the runner reducer to cover various scenarios including command selection, verification, building, and error handling.
    - Updated settings to reflect accurate timing values based on measurements.
    - Enhanced the UI with new styles for the program runner and feeder prompts, improving user experience during operation.
    - Adjusted validation tests to align with updated expectations and ensure consistency across the application.
    [grid.py]
2026-09-02 Use stable Arduino serial device path
2026-09-02 Refactor twin state management and improve phase handling
    - Updated twin.ts to enhance phase management by introducing a clear mapping of firmware reported phases to visual states.
    - Removed the descent timer and replaced it with a more accurate representation of the block's position based on firmware events.
    - Introduced new types and constants to better represent build phases and their statuses.
    - Enhanced the twinScene function to reflect the current phase and its properties, including carrying state and activity indicators.
    - Added CSS styles for visual representation of build phases and steps.
    - Created a test-state module to provide a baseline StateModel for testing.
    - Implemented comp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
    [link.py, mock_board.py]
2026-09-02 Refactor descent handling in twin module
    - Removed deprecated descentOffsetScene and related constants from twin module.
    - Introduced descentProgress function to calculate descent based on firmware's eta.
    - Updated TwinScene interface to include descent property for managing descent animation.
    - Modified twinScene function to conditionally provide descent data during lowering-to-level phase.
    - Enhanced tests in twin.test.ts to validate new descent behavior and ensure no descent timer is exported.
    - Updated StateModel and BuildStepEvent interfaces to include build_phase_eta_ms for tracking phase duration.
    - Adjusted test-state and ws.test.ts to accommodate changes in the state model and event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
2026-09-02 feat: enhance layout for laptop viewports and improve camera/log handling
2026-09-03 feat(calibration): implement placed-block calibration routes and logic
    - Added new endpoints for block calibration: start, step, undo, cancel, and save.
    - Introduced BlockCalibrationRun to manage the calibration process.
    - Implemented locking mechanism to prevent concurrent calibration actions.
    - Enhanced error handling for various calibration scenarios.
    - Updated app state to track calibration progress and results.
    fix(library): improve storage handling in LibraryDrawer
    - Added support for blocked storage scenarios in tests.
    - Adjusted storage prop handling to ensure proper fallback to localStorage.
    - Enhanced tests to verify behavior when storage is unavailable.
    [block_calibration.py, block_detector.py, block_grid.py, build_horizontal_grid.ino, build_log.py, build_vertical_grid.ino]
2026-09-03 feat(calibration): implement placed-block calibration for accurate workspace mapping
    - Added a new script `block_grid_calibrate.py` to facilitate placed-block calibration using the rig and camera.
    - Introduced skew compensation for Y-axis in the build motion to correct for X-rail misalignment.
    - Enhanced logging capabilities with detailed run logs for builds and serial communication.
    - Updated server documentation to include new logging features and troubleshooting steps.
    - Modified the web API to support block calibration operations, including starting, stepping, and saving calibration runs.
    - Created a new React component for managing the block calibration UI, providing feedback on placeme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
    [block_calibration.py, link.py]
2026-09-03 feat(skew compensation): implement X-rail skew compensation for Y-axis build motion and add server-side logging for build runs
2026-09-03 fix(skew compensation): update Y-axis skew values to reflect accurate measurements
2026-09-03 feat(buildmode): introduce building mode with toast notifications and build library
    - Added `BuildMode` component for the `#/build` route, featuring a live camera and twin display.
    - Implemented `BuildLibrary` for selecting builds, integrating with local storage for persistence.
    - Created `ToastStack` and `useBuildToasts` for managing toast notifications related to build status and actions.
    - Enhanced `RunnerPanel` to support toast notifications for various run phases.
    - Updated styles for building mode, including layout and toast notifications.
    - Refactored `TwinPanel` to share model state across console and building mode.
    - Established a shared `consoleStore` to maintain state consistency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
2026-09-03 feat: enhance block calibration and building mode functionality
    - Added `supply` field to `BlockStartRequest` for specifying available blocks.
    - Updated `_block_reply` to include detailed pitch information and warnings for dense filling.
    - Refactored `App` component to improve layout and accessibility of building mode controls.
    - Enhanced `RunnerPanel` to support compact mode, reducing clutter during builds.
    - Improved `TwinPanel` to always display the twin, regardless of model loading status.
    - Introduced floating controls in `BuildMode` for better user interaction.
    - Updated styles for floating controls and overall layout adjustments in build mode.
    - Added tests for new twin functionalitie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
2026-09-03 feat(calibration): implement placed-block calibration as the primary route and add workspace map error reporting
    [block_grid.py]
2026-09-03 feat(calibration): enhance workspace map saving and error reporting in Camera Studio
2026-09-03 Refactor block detection and workspace reloading functionality
    - Replace block detection method in gridded_camera_feed and rig_build_v1 with detect_aligned_blocks for improved grid alignment.
    - Introduce reload_workspace method in ConsolePipeline to allow reloading of workspace_map.json without restarting the application.
    - Add a new endpoint in routes_calibration to trigger workspace reloading from the web interface.
    - Implement UI button in Calibrate component to reload saved calibration from the server.
    - Create tests to ensure calibration parity between block and paper routes, and to verify workspace reloading functionality.
    - Introduce block_outline module for cleaner block outlines in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
    [block_outline.py, console_pipeline.py]
2026-09-03 Refactor block detection and visualization
    - Updated `detect_aligned_blocks` function to accept additional keyword arguments for enhanced flexibility in block detection.
    - Introduced a new test suite in `test_block_outline.py` to validate block detection accuracy and outline properties.
    - Improved edge handling in block detection by changing the margin to a pixel tolerance for better performance.
    - Enhanced the visual representation of blocks in the web interface by adjusting material properties and opacity settings.
    - Added `RigOrbitControls` for improved camera control in the 3D scene, ensuring consistent mouse wheel behavior for zooming.
    - Updated CSS variables for block colors to improve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
    [block_outline.py, console_pipeline.py]
2026-09-03 Refactor grid rotation handling and improve placement supervision
    - Updated documentation to reflect changes in horizontal grid rotation from 90° CCW to 90° CW across multiple files.
    - Adjusted servo close angle from 55° to 52° in build sketches for consistency.
    - Implemented a new placement supervision plan to verify block placements and detect human interference.
    - Introduced a PlacementLedger to track commanded placements and expected occupancy.
    - Enhanced the classification of occupancy states and added interlocks to ensure accurate assessments during idle periods.
    - Updated relevant plans and feature ideas to align with the new supervision capabilities and grid handling logic.
    [build_horizontal_grid.ino, build_vertical_grid.ino, link.py]
2026-09-04 fix(tests): update coordinate calculations and expectations in tests
    - Adjusted the expected output for horizontal cell coordinates in `coords.test.ts` to reflect changes in registration logic.
    - Updated edge overhang budget calculations in `geometry.test.ts` to correct the expected shift values for horizontal blocks.
    [build_horizontal_grid.ino, build_vertical_grid.ino]
2026-09-04 Update documentation references from plans to docs
    - Changed references in GUIDE.md, gridded_camera_feed.py, config.py, grid.py, link.py, workspace.py, rig_console.py, test_cluster_grid.py, test_config_modes.py, test_grid.py, test_link.py, cluster_grid.py, color_grid.py, combined_grid.py, app.py, and store.ts to point to the new docs directory instead of plans.
    - Ensured all links to calibration and configuration documents are updated for consistency and accuracy.
2026-09-04 Refactor documentation for printed grid calibration and feature ideas
    - Updated evidence-assisted printed grid calibration documentation to reflect changes in grid dimensions and calibration steps.
    - Revised feature ideas document to indicate completed features in the index redesign and their current implementation status.
    - Added detailed documentation for the Uno feeder controller, including hardware setup, serial protocol, and commissioning checklist.
    - Clarified grid capture calibration playbook with updated camera settings and resolution instructions.
    - Enhanced printed color grid documentation to specify workspace dimensions and grid specifications.
    - Resolved historical discrepancies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
2026-09-04 feat: Enhance feeder and gantry integration with new state management
    - Added feeder connection checks and state management to ensure both feeder and gantry are connected before initiating builds.
    - Introduced new state fields: gantry_connected, feeder_connected, hardware_ready, cell_phase, feeder_transaction_id, feeder_state, and feeder_error.
    - Updated tests to validate new feeder functionality and state transitions.
    - Modified API routes to handle stop commands for active feeds and ensure proper error handling.
    - Enhanced frontend components to reflect new state information and improve user feedback during operations.
    - Updated flash script to support separate compilation and uploading fo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
    [build_controller.py, build_job.py, build_log.py, link.py]
2026-09-05 Add front matter and Chapter 1 to project report
    - Implement title page with customizable fields for university, faculty, department, degree, and authors.
    - Create structured sections for acknowledgements, abstract, table of contents, list of figures, and list of tables.
    - Develop Chapter 1 with detailed introduction, background, problem statement, project objectives, scope, significance, and organization of the report.
    - Ensure proper formatting and alignment for all text elements using docx library.
    [build_report.py, docbuild.py, mkcharts.py, mkwiring.py, part_ch2.py, part_ch3.py, part_ch4.py, part_ch5.py]
2026-09-05 refactor: update dynamic X/Y skew compensation and add fixed placement offsets
    [build_horizontal_grid.ino, build_vertical_grid.ino]
2026-09-05 Add CLAUDE.md for calibration guidelines and update sign conventions in build_test_v1.ino
    - Introduced CLAUDE.md to provide essential calibration rules and guidelines for the rig setup, emphasizing the importance of sign conventions and checks after firmware edits.
    - Updated comments in build_test_v1.ino to clarify the sign conventions for calibration variables, ensuring consistency in how values are interpreted and applied.
    - Enhanced documentation on the relationship between magnitudes and signed positions, detailing the correct usage of calibration constants and their effects on machine behavior.
    - Improved clarity on the purpose and application of various calibration knobs, including GRI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
2026-09-06 feat: implement removed-block compensation feature design
    - Added a comprehensive design document for the removed-block compensation feature, detailing detection, compensation policies, and implementation milestones.
    - Updated feeder controller documentation to reflect changes in the feeding sequence and sensor logic.
    - Changed protocol version from 2 to 3 across various components, including feeder.py, mock_feeder.py, and tests.
    - Adjusted feeder test cases to align with the new protocol version and ensure compatibility with the updated feeder logic.
2026-09-06 Refactor Z pickup logic for feeder belt integration
    - Updated build phase 5 to lower Z to a fixed height below the top switch instead of seeking ground, preventing collisions with the feeder belt.
    - Introduced constant Z_PICKUP_DROP_FROM_TOP_CM to define the new pickup height.
    - Modified zGoPickup() and related functions to reflect the new pickup logic.
    - Adjusted documentation and comments throughout the codebase to clarify changes and ensure consistency.
    - Updated error messages and test cases to align with the new pickup height logic.
    [build_horizontal_grid.ino, build_vertical_grid.ino, link.py, part_ch6.py]
2026-09-06 fix: update Z_PICKUP_DROP_FROM_TOP_CM value to 10.75 cm across multiple files
    [build_horizontal_grid.ino, build_vertical_grid.ino]
2026-09-06 fix: update Z_PICKUP_DROP_FROM_TOP_CM value to 12.0 cm in multiple files
    [build_horizontal_grid.ino, build_vertical_grid.ino]
2026-09-06 feat: implement running-bond course shifts in model and rendering
    - Introduced `BondShifts` type to manage per-mode, per-level offsets for running-bond courses.
    - Added `resolveShift` function to calculate effective shifts combining live rig shifts and bond offsets.
    - Updated `Model` interface to include `bondShifts` for tracking running-bond offsets.
    - Enhanced `applyEdit` function to handle `setBond` edits, allowing for dynamic updates to bond shifts.
    - Modified rendering components to account for shifts in block positioning, ensuring accurate visual representation.
    - Updated tests to validate new shift functionality and ensure compatibility with existing features.
    - Adjusted settings to i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
    [link.py, mock_board.py]
2026-09-06 fix: update Z_PICKUP_DROP_FROM_TOP_CM value to 13.25 cm across multiple files
    [build_horizontal_grid.ino, build_vertical_grid.ino]
2026-09-06 feat: update Z_PICKUP_DROP_FROM_TOP_CM to 13.0 cm and implement belt-blocked cells in configuration
2026-09-06 feat: add blocked cell handling for feeder belt in vertical mode
    - Introduced `isBlocked` and `blockedCells` functions to determine if a cell is obstructed by the feeder belt.
    - Updated tests to verify blocked cell behavior in both vertical and horizontal modes.
    - Enhanced `latticeCells` to classify cells as "blocked" when obstructed.
    - Modified placement logic to reject placement on blocked cells.
    - Updated validation rules to include checks for blocked cells, ensuring proper feedback during model validation.
    - Adjusted UI to visually represent blocked cells with distinct styling.
2026-09-06 feat: enhance feeder and camera handling for blocked cells in workspace
2026-09-06 fix: update Z_PICKUP_DROP_FROM_TOP_CM to 13.3 cm across multiple files
    [build_horizontal_grid.ino, build_vertical_grid.ino]
2026-09-06 fix: update blocked cells and pickup drop height for vertical builds
    - Changed blocked cells in configuration and documentation from [[1, 0], [1, 1], [2, 1]] to [[0, 1], [1, 0], [1, 1]].
    - Updated Z_PICKUP_DROP_FROM_TOP_CM from 13.0 cm to 13.9 cm across multiple files including firmware and documentation.
    - Adjusted tests and validation to reflect new blocked cell coordinates and pickup height.
    - Enhanced UI to visually indicate blocked cells in the grid overlay.
    [build_horizontal_grid.ino, build_vertical_grid.ino]
2026-09-06 feat: implement virtual grid calibration to derive workspace maps between grid modes
2026-09-06 Update container servo angles and related documentation
    - Changed container servo angles from 20°/90°/160° to 23°/80°/150° across multiple files including:
    - FIGURE_PROMPTS.md
    - REPORT_INFORMATION_QUESTIONS.md
    - arduino/README.md
    - arduino/belt_v1/belt_v1.ino
    - docs/feeder-controller.md
    - report_src/mkwiring.py
    - report_src/part_ch2.py
    - report_src/part_ch4.py
    - report_src/part_ch6.py
    - Updated wiring diagram to reflect new angles.
2026-09-06 fix: update Z_PICKUP_DROP_FROM_TOP_CM to 13.55 cm across multiple files
    [build_horizontal_grid.ino, build_vertical_grid.ino]
2026-09-06 feat: add CLEAR button to RunnerPanel for resetting runs and update related documentation
2026-09-06 fix: update Z_PICKUP_DROP_FROM_TOP_CM to 13.7 cm across multiple files
    [build_horizontal_grid.ino, build_vertical_grid.ino]
2026-09-06 fix: stop the belt immediately on stage IR detection to ensure block remains in pickup area
2026-09-06 feat: enhance GridShift component with live preview and apply functionality fix: update container closing sequence to three stages for smoother operation fix: improve mock feeder to reflect updated s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
2026-09-06 feat: implement staged container closing and update documentation for bond shifts
2026-09-06 Refactor running-bond grid shift implementation for horizontal grid only
    - Updated documentation to clarify that the bond course applies exclusively to the horizontal grid.
    - Modified the feeder controller to streamline container opening and closing stages.
    - Adjusted mock feeder to reflect changes in state transitions during feeding.
    - Enhanced tests to validate the new horizontal-only bond shift behavior.
    - Updated UI components to ensure proper handling of bond shifts in the horizontal grid context.
    - Refactored rendering logic to account for shifted positions of blocks based on bond shifts.
2026-09-06 fix: update Z_PICKUP_DROP_FROM_TOP_CM value to 13.3 cm across multiple files
    [build_horizontal_grid.ino, build_vertical_grid.ino]
2026-09-06 fix: correct rotation direction for horizontal and vertical builds
    [build_horizontal_grid.ino, build_vertical_grid.ino]
2026-09-06 fix: update status and description for between-build error calibration; defer implementation in favor of stage checkers
2026-09-06 Update documentation for removed block compensation features
    - Clarified the description of 10 Hz detections off the live feed to specify that off-lattice detections are rejected.
    - Added a note that labelled detections with a cell do not exist due to the `_lattice_filter` discarding indices.
2026-09-07 Add tests for PlacementLedger and Supervisor functionality
    - Introduced `test_placement_ledger.py` to validate the behavior of the PlacementLedger class, including memory management, occupancy assertions, and interactions with the BuildController.
    - Added `test_supervisor.py` to test the Supervisor class, focusing on verdict classification, interlock behavior, and the handling of quiet frames.
    - Created `measure_quiet_window.py` to measure the quiet window for placement supervision, providing insights into detection stability and cell assignment consistency.
    [build_controller.py, build_log.py, placement_ledger.py, supervisor.py]
2026-09-07 fix: update Z movement logic for build phase 5 to use ground seek instead of fixed drop
2026-09-07 fix: update GRID_BLOCKED_COUNT and GRID_BLOCKED_COL/ROW for manual variant to reflect no feeder belt
    [build_test_v1_manual.ino]
2026-09-07 Refactor Supervisor and Observation classes for improved measurement handling
    - Updated Gate 0's output constants with measured values from 2026-09-07.
    - Introduced new `locate` function to accurately determine detection placements.
    - Enhanced `observe` function to differentiate between detections in gaps and off-board.
    - Modified `classify` function to utilize the new in_gap parameter instead of off_lattice.
    - Adjusted tests to reflect changes in the Supervisor and Observation classes, ensuring accurate assertions for detection placements and verdicts.
    - Added new tests to validate behavior when crossing the MIN_LATTICE_BLOCKS threshold.
    [gate0_hand.csv, gate0_parked.csv, gate0_program.csv, gate0_split.csv]
2026-09-07 Add gate0_split measurement data in CSV format
    This commit introduces a new CSV file containing measurement data for gate0, including various parameters such as time, sequence, stale status, calibrated state, mode, and detection metrics. The data spans multiple entries, providing insights into the performance and behavior of the system under test.
    [gate0_hand.csv, gate0_parked.csv, gate0_program.csv, gate0_split.csv]
2026-09-07 feat(supervision): P1/P2 refine the classifier, P3-P7 close the build record
    The P-decisions, taken before four UI surfaces render classify()'s output.
    P1, P2 and P5 were put to the user and answered; P3, P4, P6 and P7 done in
    passing. No wiring yet — the supervisor is still not constructed at runtime.
    P1 (yes; deviates from the approved design). D9 sent every change of more than
    one cell to DISAGREES. What DISAGREES protects against is the absence of
    IDENTITY, and identity only matters when there is something to pair with. Two
    cells emptied with NOTHING gained needs none: memory says both were ours, the
    camera says both are gone. So a one-sided change of any size is now named —
    REMOVED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
2026-09-07 feat(supervision): M2 wiring — the observer inside the driver loop
    The supervisor now runs. `_supervise` in web/app.py takes one frame per turn,
    sends the frame difference to the SAME single-threaded executor that owns
    process_once and encode_jpeg (AGENTS.md §7), and keeps the pixel->cell step and
    the set maths on the event loop. The lifespan owns a PlacementLedger and passes
    it to BuildController as `ledger=`, so the memory reaches the controller
    without the controller learning that a camera exists.
    Nothing is published to the client — that is M3b. The reading is held on
    app.state.supervision and every CHANGE (never every frame; 8.7 Hz would be half
    a million lines an hour) is written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
2026-09-07 feat(supervision): M3a — the per-build verdict, and the camera now asserts
    vision_verification is published on StateModel and in _SEMANTIC_FIELDS, so it
    goes out immediately rather than on the 5 Hz geometry throttle. Armed at
    _publish_build_result on the PLACED branch only, from the ledger entry that
    build just appended (controller.selected has already been cleared). Answered by
    _resolve_pending_check in the first quiet window after it.
    Two findings, both of which change what the design claimed.
    F17 — D8a wanted a frame difference against the pre-build frame. That needs a
    per-cell change threshold nobody has measured: Gate 0 measured the FULL-FRAME
    fraction, and one cell is ~1/42 of th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
2026-09-07 feat(supervision): M3b — the continuous verdict, on all four surfaces
    One server field, four readers. `SupervisionModel` is published whole and every
    surface renders it; no surface re-derives a verdict, so "appears everywhere and
    stays in sync" is structural rather than a discipline anyone has to keep — and
    DESIGN.md §8's no-client-side-safety-logic rule holds by construction.
    Server: SupervisionModel on StateModel, POST /api/supervision/ack. The ack also
    RESETS the hysteresis, so D12's "the cell is re-checked in the next quiet
    window" is built from fresh evidence rather than from frames taken while the
    operator's hands were over the board. It is available mid-build, unlike every
    other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
    [build_log.py]
2026-09-07 fix(tests): the three "pre-existing" failures were test bugs, not code bugs
    python/tests/ is fully green for the first time: 94 passed, 0 failed. None of
    these needed a behaviour change — each test was measuring something other than
    what its name claimed.
    web_state_test::test_events_send_initial_update_and_heartbeat (5/10 runs on a
    clean tree, F16). It forced a state message and demanded the VERY NEXT frame be
    a heartbeat. The pipeline driver is still publishing geometry snapshots at
    geometry_hz, and with heartbeat_s=0.02 one lands inside that 20 ms window about
    half the time. Correct server behaviour; the test now skips past state
    snapshots to find the heartbeat. 0/10 after.
    mock_camera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
2026-09-07 docs: fold placement supervision into every doc it makes stale
    Seventeen files. The work is built, so the docs that described it as unbuilt —
    and the docs whose own claims it disproved — are now wrong in ways a future
    reader would act on. Corrected in place rather than appended to.
    LIVING DOCS (what the system does)
    CAMERA.md — §0 was already rewritten in the M3a commit; §5 now opens "there is
    one now", §5c's gap table has every row closed with what filled it, §5a's
    module table marks the supervisor built, §6's "neither is built" is corrected,
    §3b documents the verdict marks on the overlay, §2 records the one extra frame
    reference supervision holds and why it is not a buffer,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
2026-09-07 feat(gripper): update servo angles for improved calibration
2026-09-07 feat(gripper): update servo angles for improved grip performance
2026-09-07 feat(manual-feed): implement manual build command with operator confirmation for claw closure
2026-09-07 Refactor placement supervision to remove D10 and MIN_LATTICE_BLOCKS threshold
    - Removed D10's suppression of FOREIGN and DISAGREES verdicts on sparse boards, as the rationale was invalidated with the holder's removal.
    - Updated documentation to reflect the removal of MIN_LATTICE_BLOCKS and its implications on verdicts.
    - Adjusted the classify function to eliminate the detections argument, ensuring that verdicts are no longer gated by detection count.
    - Enhanced the in_gap signal processing to incorporate D7's hysteresis, allowing for more robust handling of centroid jitter.
    - Updated tests to verify the new behavior of the classifier and ensure correct verdicts are produced even with fewer b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
    [supervisor.py]
2026-09-07 feat: implement operator correction action for MOVED and DISPLACED blocks
    - Added a correction control in the SupervisionBanner that allows operators to return blocks to their designated cells.
    - Introduced a confirmation step before executing the correction to ensure operator intent.
    - Updated the backend to assess corrections based on the current frame and verdict, ensuring server-authoritative behavior.
    - Enhanced the SupervisionState and SupervisionModel to include correction-related fields.
    - Updated tests to cover new correction functionality and ensure proper behavior under various scenarios.
    [link.py, mock_board.py, placement_check.py]
2026-09-07 feat(correction): implement correction control for MOVED and DISPLACED verdicts with confirmation flow
2026-09-07 Add geometry tests, enhance supervision model, and improve block detection
    - Introduced a new test suite for placement geometry, validating overlap and coverage calculations.
    - Enhanced the `observe` function to carry the block's own measured footprint, ensuring accurate size and angle reporting.
    - Updated the `SupervisionState` and `SupervisionModel` to include an advisory `residual_cm` attribute, indicating how far off a block is from its planned position.
    - Modified the block detection logic to preserve pre-rectification measurements, allowing supervision to assess misplaced blocks accurately.
    - Improved the `_rectify` function to maintain the original geometry of off-lattice detections f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
2026-09-07 feat(supervision): add advisory for maximum cell residual drift and update related structures
    [supervisor.py]
2026-09-08 Refactor ConsolePipeline and related components for improved analysis handling
    - Introduced FrameAnalysisContext to encapsulate non-detector inputs for submitted images.
    - Enhanced ProcessedFrame to include analysis result metadata such as map generation and completion timestamps.
    - Implemented thread safety in ConsolePipeline using RLock for state changes during workspace and grid mode updates.
    - Updated process_once to ensure coherent analysis results are returned without stale data interference.
    - Modified AnalysisWorker to support context tracking for submitted frames, ensuring provenance is maintained.
    - Adjusted web routes to handle workspace changes and frame validity checks, preventi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
    [analysis_worker.py, console_pipeline.py]
2026-09-08 feat(supervision): propagate detector failure and stale frames as NO_VISION
    A caught detector exception left AnalysisWorker with error set and its
    detections emptied, but ProcessedFrame dropped the error and _supervise
    fed the empty tuple into observe() -> supervisor.step(), settling a false
    REMOVED on a non-empty ledger. Stale results were handled but only as BUSY.
    - ProcessedFrame carries analysis_ok / analysis_error; _coherent_frame
    sets them from completed.error and forces detections=() on failure.
    - _supervise fails closed to a new NO_VISION state for both the
    detector-failure and stale-frame paths, before observe() runs. The
    one-result-consumed-once dedup still runs first.
    - NO_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
    [console_pipeline.py, supervisor.py]
2026-09-08 feat(supervision): per-identity gap history, symmetric reset and decay
    Section 8 item 7. `_gap_history` was one global `deque[bool]`: any "a gap
    exists" frame appended True regardless of where, the settled verdict was
    rendered from the current frame's `in_gap` count (so one gap-free frame
    cleared it), and `note_mode` plus the interlock and no-memory branches of
    `step()` reset `_CellHistory` but not the gap deque.
    - `_GapHistory` / `_GapTrack` replace the global deque. Each gap detection
    carries a spatial identity (map-frame cm anchor) and is associated frame
    to frame within `GAP_IDENTITY_MATCH_CM` (2.0 cm, PROVISIONAL — wants the
    same rig measurement as `PAIRING_BEYOND_CM`). A gap i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
    [supervisor.py]
2026-09-08 feat(supervision): scope placement memory by mode and board epoch
    Item 8 of the placement-supervision audit. `PlacementLedger.has_memory`
    was one global boolean — any PLACED, any mode, any board epoch — and
    `Supervisor.step` then judged the active grid against a possibly-empty
    expected set. Horizontal-only placements made vertical mode report
    "memory" and yield VERIFIED on an empty view or FOREIGN on a real
    vertical board; a settled verdict leaked across a gantry reboot onto the
    board that replaced it.
    - `Placement` gains `board_epoch`; `PlacementLedger` stamps every entry
    with the live epoch and gains `board_epoch` / `new_board_epoch()`.
    - `has_memory` is now `has_memory(mode=None, b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
    [placement_ledger.py, supervisor.py]
2026-09-08 docs: record item-8 mode/board-epoch memory work in the execution log
    Adds the item-8 agent section, marks item 8 complete in CURRENT RESUME
    STATE, and points the next required action at item 4.
2026-09-08 feat(supervision): Pi-side exact compensated-motion clamp preflight
    Section 8 item 4. The firmware's cellTargetPosition() validates only the
    uncompensated holder target; BUILD_PLACEMENT_OFFSET_*, SKEW_* and the P
    verb's (dx,dy) nudge are added afterwards in gotoBuildTargetOffset(),
    where an off-travel target is clamped onto the cap, warned about on the
    console, and driven anyway - so a far-edge correction descends off the
    block's centre and nothing on the Pi predicts it (audit s1 "Pi preflight
    absent").
    rig/motion_preflight.py mirrors gotoBuildTargetOffset()'s magnitude-space
    arithmetic exactly - C lround rounding, the three separately-rounded
    correction terms, the clamp that bites at 0 (ho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
    [link.py, motion_preflight.py, placement_check.py]
2026-09-08 feat(supervision): coherent quiet-window track for MOVED/DISPLACED corrections
    Audit Section 8 items 6 + 9, implemented together (one vision/tracking pipeline).
    Item 6 — preserve detection multiplicity and require ONE stable, block-consistent
    track. `observe()` now records every detection whole in
    `Observation.detections_detail` before the per-cell collapse, so a merged blob, a
    duplicate hypothesis or a decomposed compound on one cell is visible.
    `_TrackHistory` — a sibling of item 7's `_gap_history`, fed from the SAME
    observation on the SAME N-of-M quiet window in the SAME `step()`, cleared by the
    SAME `_reset_hysteresis()` primitive, not a second analysis path — associates
    every blo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
    [placement_check.py, supervisor.py]
2026-09-08 docs: record items 6 + 9 coherent-track work in the execution log
    CURRENT RESUME STATE advanced to item 3 (one-shot coherent correction ticket).
2026-09-08 feat(supervision): one-shot coherent correction ticket
    Section 8 audit item 3. The operator CORRECTION route re-ran
    assess_frame_correction on the current frame but took the verdict and the
    authority to move from app.state.supervision, a reading that could be
    several frames old, with no atomic check that a quiet, mode/map/epoch-
    coherent observation still existed.
    _supervise now mints a CorrectionTicket the first frame a correctable
    MOVED/DISPLACED verdict is published and re-affirms its whole coherence
    bundle (verdict signature, map generation, grid mode, board epoch, source
    sequence, fused track centre, the eight P args) on every later coherent
    quiet frame. /api/supervision/correct sends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
2026-09-08 feat(supervision): refuse diagonal correction, sweep both neighbours + corner
    Audit §1 P0 / shortlist item 5. The DISPLACED descent check took
    drift_axis() — the LARGER of the two displacement components — and put
    only that one neighbour's corridor through corridor_clear(). A block
    shoved into a corner gap drifts on both axes and closes two corridors
    plus the corner between them at once; if the dominant axis' neighbour was
    empty the correction was approved anyway.
    rig/placement_geometry.py:
    - drift_axes() (plural): every axis carrying a displacement over an
    explicit tolerance, larger first. One axis = a correctable slide, two =
    a diagonal, zero = within noise.
    - neighbourhood_clear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
    [placement_check.py, placement_geometry.py]
2026-09-08 docs: record item-5 diagonal-correction gate in the execution log
    Adds the Phase 1 item 5 section and updates CURRENT RESUME STATE to mark
    software implementation items 2-9 complete and ready for final
    verification, with item 10 (the on-rig measurement campaign) the only
    remaining out-of-scope work.
2026-09-08 fix: update BUILD_PLACEMENT_OFFSET_X_CM to reflect changes after 2026 arm re-seat
    [build_horizontal_grid.ino, build_vertical_grid.ino, motion_preflight.py]
2026-09-08 fix: update BUILD_PLACEMENT_OFFSET_X_CM to -1.0 for testing after 2026 arm re-seat adjustments
    [build_test_v1_manual.ino]
2026-09-08 fix: update BUILD_PLACEMENT_OFFSET_X_CM to zero for testing after 2026 arm re-seat adjustments
    [build_test_v1_manual.ino]
2026-09-08 fix: update BUILD_PLACEMENT_OFFSET_X_CM to +1.35 for testing after 2026 arm re-seat adjustments
    [build_test_v1_manual.ino]
2026-09-08 fix: update BUILD_PLACEMENT_OFFSET_X_CM to +1.35 for accuracy after 2026 arm re-seat adjustments
    [build_horizontal_grid.ino, build_test_v1_manual.ino, build_vertical_grid.ino, motion_preflight.py, part_ch4.py, part_ch6.py]
2026-09-08 fix: update BUILD_PLACEMENT_OFFSET_Y_CM to -0.3 for testing after 2026 arm re-seat adjustments
    [build_test_v1_manual.ino]
2026-09-08 fix: update SERVO_HOME_OPEN_ANGLE and SERVO_OPEN_ANGLE to 120 for manual build calibration
    [build_test_v1_manual.ino]
2026-09-08 fix: add servo angle details to printServoStatus for better diagnostics
    [build_test_v1_manual.ino]
2026-09-08 fix: update servo open angles to 90 degrees for consistent calibration across sketches
    [build_horizontal_grid.ino, build_test_v1_manual.ino, build_vertical_grid.ino]
2026-09-08 fix: update Z_MARGIN_FIXED_CM to 0.18 for improved calibration consistency across sketches
    [build_horizontal_grid.ino, build_test_v1_manual.ino, build_vertical_grid.ino]
2026-09-08 fix: adjust SERVO_OPEN_ANGLE to 100 for accurate release during manual build phases
    [build_test_v1_manual.ino]
2026-09-08 fix: update BUILD_PLACEMENT_OFFSET_X/Y_CM for improved placement accuracy during testing
    [build_test_v1_manual.ino]
2026-09-08 fix: refine gripper calibration angles for improved operation at feeder home and target cell
    [build_test_v1_manual.ino]
2026-09-08 fix: update gripper calibration angles for improved operation consistency
    [build_test_v1_manual.ino]
2026-09-08 fix: update Z_MARGIN_FIXED_CM to 0.48 for improved calibration consistency
    [build_test_v1_manual.ino]
2026-09-08 fix: update AUX_STEPPER_QUARTER_TURN and BUILD_PLACEMENT_OFFSET values for improved placement accuracy
    [build_test_v1_manual.ino]
2026-09-08 fix: update AUX_STEPPER_QUARTER_TURN constant to prevent overflow and ensure correct rotation
    [build_test_v1_manual.ino]
2026-09-08 fix: update AUX_STEPPER_QUARTER_TURN calculation to prevent overflow and ensure correct rotation
    [build_test_v1_manual.ino]
2026-09-08 fix: update AUX_STEPPER_QUARTER_TURN to prevent overflow and ensure correct rotation
    [build_test_v1_manual.ino]
2026-09-08 fix: update AUX_STEPPER_QUARTER_TURN calculation for accurate quarter turn rotation
    [build_test_v1_manual.ino]
2026-09-08 fix: update BUILD_PLACEMENT_OFFSET values for improved placement accuracy
    [build_test_v1_manual.ino]
2026-09-08 fix: update BUILD_PLACEMENT_OFFSET values for improved calibration accuracy
    [build_horizontal_grid.ino, build_test_v1_manual.ino, build_vertical_grid.ino, motion_preflight.py, part_ch4.py, part_ch6.py]
2026-09-08 refactor: rename feeder references to pickup and remove blocked cell logic
    - Updated tests and implementation to replace "feeder" terminology with "pickup" for clarity.
    - Removed isBlocked and blockedCells functions, along with related tests and styles.
    - Adjusted placement logic to reflect the new pickup cell concept.
    - Cleaned up Lattice and Runner components to remove references to blocked cells.
    - Updated validation rules to use pickup cell instead of feeder cell.
    [build_controller.py, build_job.py, build_log.py, calibration_transfer.py, config.py]
2026-09-09 feat: implement session reset functionality to clear build state
    - Added a new API endpoint `/session/reset` to clear the build state, which resets the server's memory of the current board and its associated judgments.
    - Updated the RunnerPanel component to include a button for clearing the build state, which triggers the new API call.
    - Enhanced the RunnerPanel tests to verify the behavior of the clear build state functionality, including scenarios where the server refuses the reset.
    - Modified the state management to ensure that the panel reflects the server's memory state accurately after a reset attempt.
    - Documented the reset functionality in the API and updated the relevant interfaces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
2026-09-09 feat: implement camera-gated automatic pickup for autonomous RUN
    - Added `feeder_has_block` check to determine if a block is staged at the feeder.
    - Introduced `auto_pickup` state management in the web application to handle automatic claw closure.
    - Created API endpoint `/auto-pickup` to arm/disarm automatic pickup functionality.
    - Updated `RunnerPanel` to reflect the state of the feeder and manage automatic pickup.
    - Enhanced tests to cover new behavior for RUN style, including waiting for blocks at the feeder.
    - Introduced vertical cell exclusion logic to ignore remnants during horizontal operations.
    - Added regression tests for vertical cell exclusion and feeder checks.
2026-09-09 feat: Enhance feeder detection and visualization in horizontal mode
    - Updated documentation to clarify the behavior of the physical feeder in horizontal and vertical modes.
    - Modified `gridded_camera_feed.py` and `rig_build_v1.py` to support mode-specific analysis grid and workspace parameters.
    - Removed the `vertical_cell_exclusion` module and integrated its functionality into the new orientation filter.
    - Introduced `orientation_filter.py` to classify block orientation against camera-projected machine axes.
    - Added tests for orientation detection and filtering to ensure correct behavior across modes.
    - Enhanced `GridOverlay` and `Lattice` components to visualize the true feeder marker in h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
    [block_outline.py, console_pipeline.py, orientation_filter.py]
2026-09-09 feat: Implement operator kill switch for placement supervision and enhance state management
2026-09-09 feat: Implement operator kill switch for supervision and enhance workspace handling
2026-09-09 feat: Add supervision toggle component and integrate into CameraView and BuildMode
2026-09-09 feat: Enhance CLEAR BUILD STATE functionality to reset grid shift and build level to zero
    [workspace.py]
